baobuibk/SpaceLiin_BEE-DAL_EXP_V1.0_HW/07_REF/position-connectors.docx

TOP VIEW

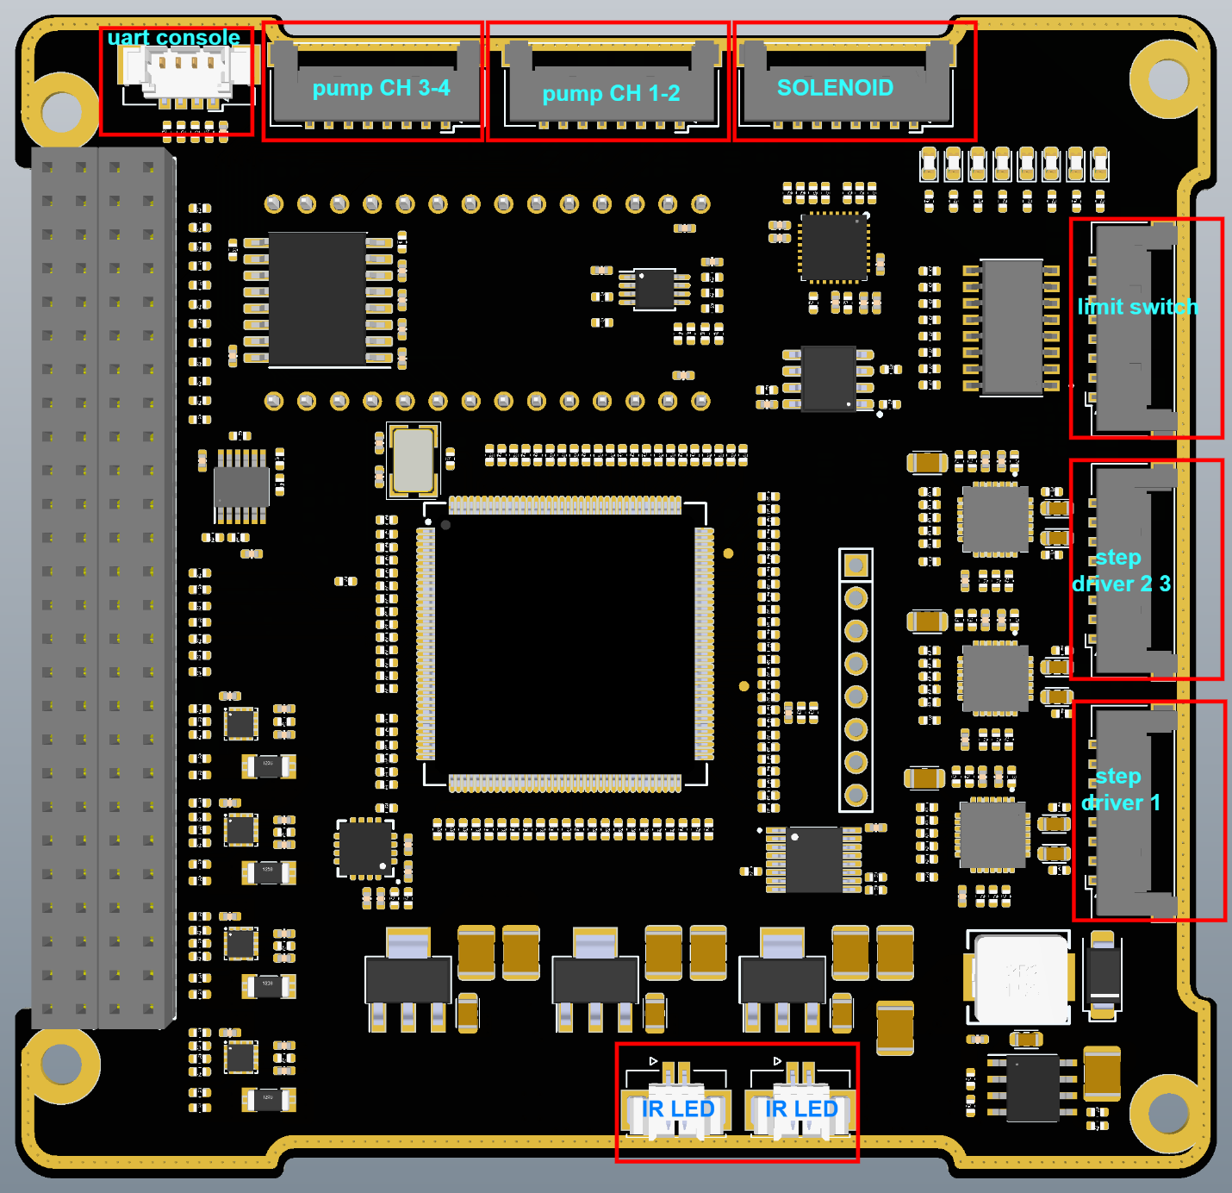
[picture p5: figure]

BOT VIEW

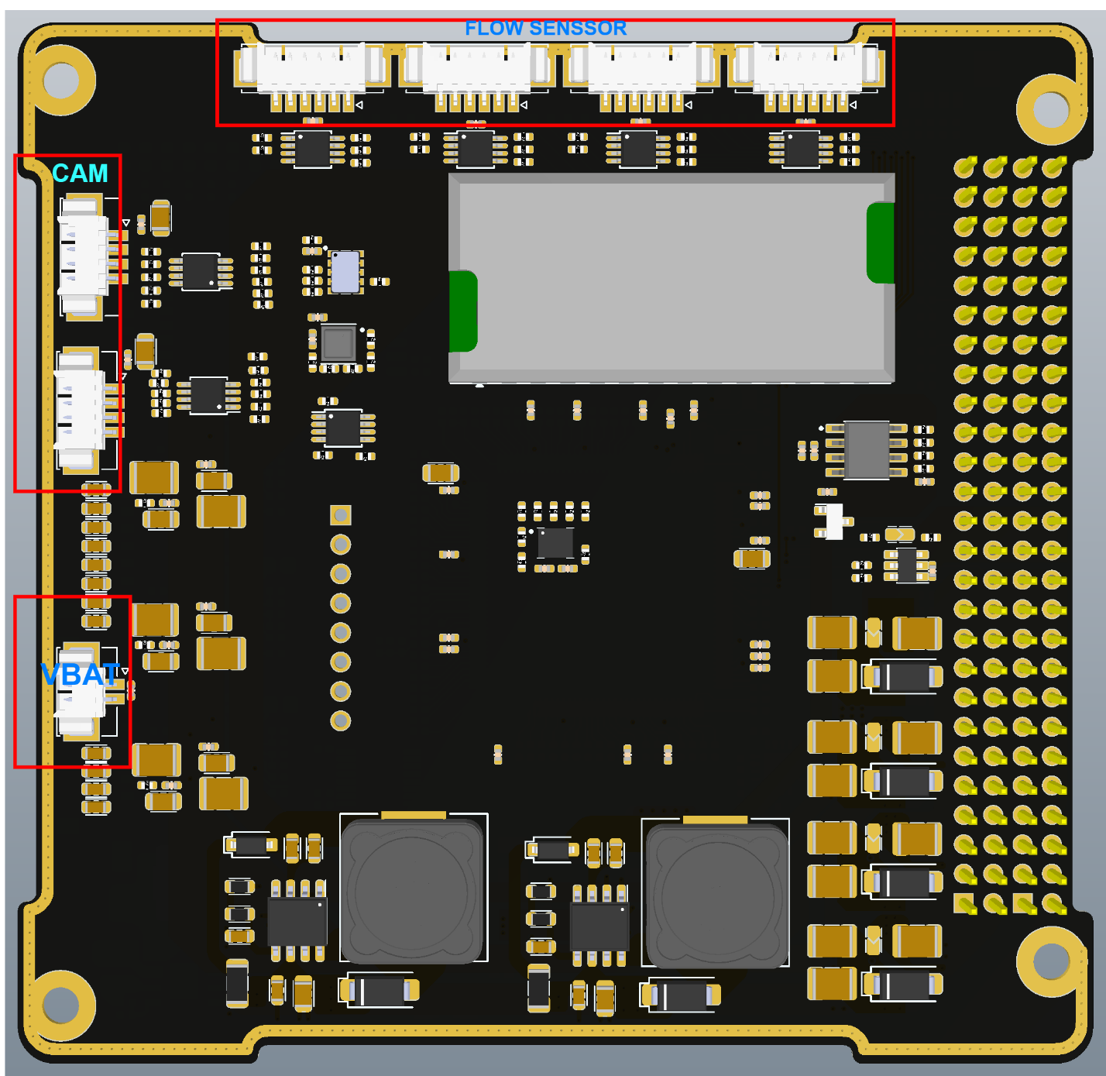
[picture p6: figure]
