baobuibk/SpaceLiin_BEE-DAL_EXP_V1.0_HW/03_BOM/BEE-DAL_EXP_V1.0.xlsx

Name | Description | Designator | Quantity | Library Name | Footprint | Manufacturer 1 | Manufacturer Part Number 1
_LED_YELLOW | LED YELLOW CLEAR 0603 SMD | D3, D10, D11, D12, D13, D14, D15, D16 | 8 | LABLIB.SchLib | LED_0603 | Würth Elektronik Midcom | 150060YS75000
0R | RES 0 OHM JUMPER 1/16W 0402 | R81, R91, R135, R144, R154, R156, R233, R234, R235, R236, R239, R240, R241, R242, R243, R244, R246, R285, R286, R287, R296, R297, R298, R304, R305, R307, R311, R312 | 28 | LABLIB.SchLib | RES_C_1005X40 | Yageo Group | RC0402JR-070RL
0.01uF/50V | CAP CER 10000PF 50V X7R 0603 | C19 | 1 | LABLIB.SchLib | CAP_C_1608X80 | Samsung Electro-Mechanics | CL10B103KB8NNNC
0.05R/1W | RES 0.05 OHM 1% 1W 1206 | R173, R176 | 2 | LABLIB.SchLib | RES_C_3216X70 | Stackpole Electronics | CSNL1206FT50L0
0.1uF/25V | CAP CER 0.1UF 25V X7R 0402 | C13, C14, C17, C18, C23, C29, C30, C31, C32, C33, C34, C35, C36, C37, C38, C39, C40, C41, C42, C43, C44, C45, C46, C47, C48, C49, C50, C51, C52, C53, C54, C55, C56, C57, C58, C59, C60, C61, C63, C64, C111, C112, C134, C137, C139, C141, C142, C143, C144, C164, C165, C166, C167, C168, C171, C172, C173, C174, C176, C177, C178, C179, C407, C408 | 64 | LABLIB.SchLib | CAP_C_1005X60 | Samsung Electro-Mechanics | CL05B104KA5NNNC
0.1uF/25V | CAP CER 0.1UF 25V X7R 0603 | C16, C69, C70, C71, C72, C74, C75, C76, C77, C80, C81, C82, C83, C84, C85, C86, C87, C88, C89, C90, C91, C92, C93 | 23 | LABLIB.SchLib | CAP_C_1608X80 | Samsung Electro-Mechanics | CL10B104KA8NNNC
1k | RES SMD 1K OHM 1% 1/10W 0402 | R5, R13, R256, R257, R258, R263, R271 | 7 | LABLIB.SchLib | RES_C_1005X40 | Panasonic | ERJ2RKF1001X
1k | RES 1K OHM 1% 1/10W 0603 | R174, R177 | 2 | LABLIB.SchLib | RES_C_1608X60 | SEI | RMCF0603FT1K00
1M | RES 1M OHM 1% 1/16W 0402 | R112 | 1 | LABLIB.SchLib | RES_C_1005X40 | Yageo Group | RC0402FR-071ML
1N4007FL | DIODE STANDARD 1000V 1A SOD123FL | D18, D19, D20, D21 | 4 | LABLIB.SchLib | SOD3717X145N | Sangdest Microelectronics | 1N4007FL
1N5819HW-7-F | DIODE SCHOTTKY 40V 1A SOD123 | D5, D7 | 2 | LABLIB.SchLib | SOD3717X145N | Diodes Inc. | 1N5819HW-7-F
1uF/25V | CAP CER 1UF 25V X5R 0402 | C4, C10, C21, C65, C125, C131, C169, C170, C175, C409 | 10 | LABLIB.SchLib | CAP_C_1005X60 | Holystone | C0402B105K025T
1.6k | RES SMD 1.6K OHM 1% 1/10W 0402 | R8, R16, R266, R274 | 4 | LABLIB.SchLib | RES_C_1005X40 | Panasonic | ERJ2RKF1601X
2.2nF/50V | CAP CER 2200PF 50V X7R 0402 | C5, C6, C11, C12, C126, C127, C132, C133 | 8 | LABLIB.SchLib | CAP_C_1005X60 | Samsung Electro-Mechanics | CL05B222KB5NNNC
2.2uF/10V | CAP CER 2.2UF 10V X7S 0402 | C67, C411 | 2 | LABLIB.SchLib | CAP_C_1005X60 | TDK | C1005X7S1A225K050BC
3.24k | RES 3.24K OHM 1% 1/16W 0402 | R35, R322 | 2 | LABLIB.SchLib | RES_C_1005X40 | Vishay | CRCW04023K24FKED
4.7k | RES SMD 4.7K OHM 1% 1/10W 0402 | R108, R114, R115, R116, R117, R118, R119, R120, R121, R126, R127, R128, R129, R131, R132, R136, R137, R138, R139, R140, R145, R146, R147, R148, R149, R157, R158, R159, R160, R283, R284, R294, R295, R327, R328, R329, R330 | 37 | LABLIB.SchLib | RES_C_1005X40 | Panasonic | ERJ-2RKF4701X
4.7nF/50V | CAP CER 4700PF 50V X7R 0603 | C15 | 1 | LABLIB.SchLib | CAP_C_1608X80 | Samsung Electro-Mechanics | CL10B472KB8NNNC
4.7uF/10V | CAP CER 4.7UF 10V X5R 0402 | C62, C109, C110, C406 | 4 | LABLIB.SchLib | CAP_C_1005X60 | Samsung Electro-Mechanics | CL05A475MP5NRNC
5.62k | RES SMD 5.62K OHM 1% 1/10W 0402 | R113 | 1 | LABLIB.SchLib | RES_C_1005X40 | Panasonic | ERJ2RKF5621X
10k | RES SMD 10K OHM 1% 1/10W 0402 | R6, R9, R14, R20, R23, R24, R50, R51, R52, R53, R62, R63, R65, R67, R78, R122, R130, R133, R163, R164, R165, R170, R180, R249, R250, R251, R264, R272, R275, R277, R279, R288, R299, R319, R320, R332, R338, R339, R342, R343, R346, R349, R352, R355, R409, R410, R415 | 47 | LABLIB.SchLib | RES_C_1005X40 | Panasonic | ERJ-2RKF1002X
10k | RES 10K OHM 1% 1/10W 0603 | R175, R178 | 2 | LABLIB.SchLib | RES_C_1608X60 | Yageo Group | RC0603FR-0710KL
10uF/25V | CAP CER 10UF 25V X5R 0805 | C27, C28, C68, C73, C113, C116, C119, C136, C138 | 9 | LABLIB.SchLib | CAP_C_2012X110 | Samsung Electro-Mechanics | CL21A106KAYNNNE
12pF/50V | CAP CER 12PF 50V C0G/NP0 0402 | C24, C25, C26 | 3 | LABLIB.SchLib | CAP_C_1005X60 | Murata | GJM1555C1H120FB01D
16.5k/1% | RES 16.5K OHM 1% 1/16W 0402 | R124, R125 | 2 | LABLIB.SchLib | RES_C_1005X40 | Stackpole Electronics | RMCF0402FT16K5
20k | RES 20K OHM 1% 1/16W 0402 | R172, R417 | 2 | LABLIB.SchLib | RES_C_1005X40 | Yageo Group | RC0402FR-0720KL
22nF/16V | CAP CER 0.022UF 16V X7R 0402 | C66, C410 | 2 | LABLIB.SchLib | CAP_C_1005X60 | Yageo Group | C0402C223K4RACTU
22R | RES SMD 22 OHM 0.5% 1/16W 0402 | R18, R22, R25, R26, R27, R28, R29, R30, R31, R32, R33, R34, R36, R37, R38, R39, R40, R42, R44, R46, R47, R48, R49, R54, R55, R56, R57, R58, R59, R60, R61, R64, R66, R68, R69, R70, R71, R72, R73, R74, R75, R76, R77, R79, R80, R82, R83, R85, R86, R87, R88, R90, R92, R93, R96, R97, R98, R99, R101, R102, R103, R104, R105, R106, R107, R109, R110, R111, R123, R142, R143, R150, R151, R161, R162, R166, R167, R168, R169, R171, R179, R303, R306, R308, R309, R310, R313, R321, R323, R324, R325, R326, R331, R334, R335, R344, R345, R347, R348, R350, R351, R353, R354, R411, R412, R413, R414, R416 | 108 | LABLIB.SchLib | RES_C_1005X40 | Panasonic | ERA-2AKD220X
47k | RES SMD 47K OHM 1% 1/10W 0402 | R3, R4, R7, R11, R12, R15, R261, R262, R269, R270 | 10 | LABLIB.SchLib | RES_C_1005X40 | Panasonic | ERJ2RKF4702X
47uF/25V | CAP CER 47UF 25V X5R 1210 | C1, C2, C3, C7, C8, C9, C20, C22, C78, C79, C114, C115, C117, C118, C120, C121, C122, C123, C124, C128, C129, C130 | 22 | LABLIB.SchLib | CAP_C_3225X80 | TAIYO YUDEN | TMK325ABJ476MMP
47uH | FIXED IND 47UH 2.8A 67 MOHM SMD | L1, L2 | 2 | BEE-DAL_EXP_sche.SCHLIB | IND_MP_1250x1250x850 | EPCOS | B82477P4473M000
60R | RES SMD 60.4 OHM 1% 1/10W 0402 | R17, R19 | 2 | LABLIB.SchLib | RES_C_1005X40 | Panasonic | ERJ2RKF60R4X
100k | RES 100K OHM 1% 1/10W 0402 | R278 | 1 | LABLIB.SchLib | RES_C_1005X40 | Panasonic | ERJ-2RKF1003X
120R | RES SMD 120 OHM 0.1% 1/16W 0402 | R276, R336, R337, R340, R341 | 5 | LABLIB.SchLib | RES_C_1005X40 | Panasonic | ERA2AEB121X
133k | RES SMD 133K OHM 1% 1/10W 0402 | R265, R273 | 2 | LABLIB.SchLib | RES_C_1005X40 | Panasonic | ERJ-2RKF1333X
470k | RES SMD 470K OHM 1% 1/10W 0402 | R2, R10, R260, R268 | 4 | LABLIB.SchLib | RES_C_1005X40 | Panasonic | ERJ2RKF4703X
0532610271 | CONN HEADER SMD R/A 2POS 1.25MM | J3, J11, J12 | 3 | LABLIB.SchLib | MOLEX_0532610271 | Molex | 53261-0271
0532610471 | CONN HEADER SMD R/A 4POS 1.25MM | J15, J17 | 2 | BEE-DAL_EXP_sche.SCHLIB | MOLEX_0532610471 | Molex | 53261-0471
0532610671 | CONN HEADER SMD R/A 6POS 1.25MM | J4, J5 | 2 | LABLIB.SchLib | MOLEX_0532610671 | Molex | 53261-0671
0533980471 | CONN HEADER SMD 4POS 1.25MM | J1 | 1 | LABLIB.SchLib | MOLEX_0533980471 | Molex | 53398-0471
5040500491 | CONN HEADER SMD R/A 4POS 1.5MM | J6 | 1 | LABLIB.SchLib | MOLEX_5040500491 | Molex | 504050-0491
5040500591 | CONN HEADER SMD R/A 5POS 1.5MM | J13, J14 | 2 | LABLIB.SchLib | MOLEX_5040500591 | Molex | 504050-0591
5040500891 | CONN HEADER SMD R/A 8POS 1.5MM | J7, J8, J9, J10, J16, J18, J19, J20 | 8 | LABLIB.SchLib | MOLEX_5040500891 | Molex | 504050-0891
AL8843SP-13 | IC LED DRIVER RGLTR PWM 3A 8SO | U18, U19 | 2 | BEE-DAL_EXP_sche.SCHLIB | SOIC127P602X173-8N_EPAD | Diodes Inc. | AL8843SP-13
AO3400A | MOSFET N-CH 30V 5.7A SOT23-3L | Q1, Q2, Q3, Q4 | 4 | LABLIB.SchLib | SOT95P240X120-3N | Alpha & Omega Semiconductor | AO3400A
BME688 | SENSOR GAS/HUM/PRES/TEMP I2C SPI | U13 | 1 | LABLIB.SchLib | IC_BME688 | Bosch Tools | BME688
DNP/0R |  | JP5 | 1 | LABLIB.SchLib | JUMPER_1-2_1608X60
DNP/0R | RES 0 OHM JUMPER 1/10W 0603 | JP6, JP7 | 2 | LABLIB.SchLib | RES_C_1608X60 | Yageo Group | RC0603JR-070RL
DNP/0R | RES 0 OHM JUMPER 1/16W 0402 | R289, R302, R315, R316, R317, R318 | 6 | LABLIB.SchLib | RES_C_1005X40 | Yageo Group | RC0402JR-070RL
DNP/4.7k | RES SMD 4.7K OHM 1% 1/10W 0402 | R84, R134, R141, R152, R153, R155, R237, R238, R247, R248, R281, R282, R292, R293 | 14 | LABLIB.SchLib | RES_C_1005X40 | Panasonic | ERJ-2RKF4701X
DNP/10k | RES SMD 10K OHM 1% 1/10W 0402 | R1, R259, R267 | 3 | LABLIB.SchLib | RES_C_1005X40 | Panasonic | ERJ-2RKF1002X
DNP/22R | RES SMD 22 OHM 0.5% 1/16W 0402 | R94 | 1 | LABLIB.SchLib | RES_C_1005X40 | Panasonic | ERA-2AKD220X
ESQ-126-14-G-D | CONN SOCKET 52POS 0.1 GOLD PCB | H1, H2 | 2 | BEE-DAL_EXP_sche.SCHLIB | SAMTEC_ESQ-126-14-G-D | Samtec | ESQ-126-14-G-D
FC5BQCCMC12.0-T1 | CRYSTAL 12.0000MHZ 20PF SMD | XC1 | 1 | BEE-DAL_EXP_sche.SCHLIB | AP7-00039 | Abracon | FC5BQCCMC12.0-T1
Header 8x1 |  | J2 | 1 | LABLIB.SchLib | Header_254P_8x1
hole_space |  | Hole1, Hole2, Hole3, Hole4 | 4 | BEE-DAL_EXP_sche.SCHLIB | HEX-M3_NoVia
IC_DRV8910QPWPRQ1 | IC HALF BRIDGE DRVR 6A 24HTSSOP | U20 | 1 | LABLIB.SchLib | IC_DRV8910QPWPRQ1 | Texas Instruments | DRV8910QPWPRQ1
IS66WVS8M8FBLL-104NLI | IC PSRAM 64M SPI/QUAD I/O 8-SOIC | U28 | 1 | LABLIB.SchLib | SOIC8_150MIL_N_ISI | ISSI | IS66WVS8M8FBLL-104NLI
JUMPER |  | JP1, JP2, JP3, JP4, JP10, JP11 | 6 | BEE-DAL_EXP_sche.SCHLIB | JUMPER_1608
KRL1632E-M-R010-F-T5 | RES 0.01 OHM 1% 3/4W 1206 | R252, R253, R254, R255 | 4 | LABLIB.SchLib | RES_C_1206_SHUNT | Susumu | KRL1632E-M-R010-F-T5
LM1117MP-3.3/NOPB | IC REG LINEAR 3.3V 800MA SOT-223 | VR1, VR2, VR3 | 3 | LABLIB.SchLib | VREG_LM1117MP-3.3/NOPB | Texas Instruments | LM1117MP-3.3/NOPB
LSM6DSOXTR | INEMO INERTIAL MODULE: 3D ACCELE | U14 | 1 | LABLIB.SchLib | PQFN50P250X300X86-14N | STMicroelectronics | LSM6DSOXTR
MAX3485CSA+T | IC TRANSCEIVER HALF 1/1 8SOIC | U34 | 1 | BEE-DAL_EXP_sche.SCHLIB | 21-0041-3-M_90-0096-8L_MXM | Analog Devices | MAX3485CSA+T
MAX22200ETJ+T | EIGHT HALF-BRIDGES SERIAL CONTRO | U17, U35 | 2 | LABLIB.SchLib | 21-0140AK_T3255_8C_MXM | Analog Devices | MAX22200ETJ+T
MB85RS2MTAPNF-G-BDERE1 | IC FRAM 2MBIT SPI 40MHZ 8SOP | U6 | 1 | BEE-DAL_EXP_sche.SCHLIB | SOIC127P602X173-8N | Fujitsu | MB85RS2MTAPNF-G-BDERE1
mp-HighDriver |  | U11 | 1 | LABLIB.SchLib | MP_HIGHDRIVER
mp-HighDriver4 |  | U15 | 1 | BEE-DAL_EXP_sche.SCHLIB | MP_HIGHDRIVER4
OPA2340UA | IC CMOS 2 CIRCUIT 8SOIC | U36, U37 | 2 | BEE-DAL_EXP_sche.SCHLIB | SOIC127P602X173-8N | Texas Instruments | OPA2340UA
PAC1934 UQFN-16 | IC CURRENT MONITOR 1% 16UQFN | U25 | 1 | LABLIB.SchLib | UQFN-16_4X4_EP2.6X2.6 | Microchip | PAC1934TI/JQ
PCA9508DP,118 | IC REDRIVER I2C HOTSWAP 8TSSOP | U9, U10, U12, U16, U29, U30, U32 | 7 | BEE-DAL_EXP_sche.SCHLIB | TSOP8 | NXP Semiconductors | PCA9508DP,118
RV-3129-C3-32.768KHZ-OPTION-A-TB-QA | IC RTC CLK/CALENDAR I2C 10SON | U7 | 1 | BEE-DAL_EXP_sche.SCHLIB | IC_RV-3129-C3_32.768KHZ_OPTION_A_TB_QA | Micro Crystal | RV-3129-C3-32.768KHZ-OPTION-A-TB-QA
SAMV71Q21B | IC MCU 32BIT 2MB FLASH 144LQFP | U5 | 1 | BEE-DAL_EXP_sche.SCHLIB | AP6-00118 | Microchip | ATSAMV71Q21B-AABT
SN65C3232PWR | 2/2 Transceiver Full RS232 16-TSSOP 1GHz | U4 | 1 | LABLIB.SchLib | SOP65P640X120-16N | Texas Instruments | SN65C3232PWR
SN65HVD230DR | IC TRANSCEIVER HALF 1/1 8SOIC | U3 | 1 | BEE-1012 PAY-EXP_V110.IntLib | SOIC127P600X175-8N | Texas Instruments | SN65HVD230DR
SRP7050TA-220M | FIXED IND 22UH 2.5A 170 MOHM SMD | L3 | 1 | LABLIB.SchLib | PSM6050 | Bourns | SRP7050TA-220M
SS54 | DIODE SCHOTTKY 40V 5A SMA | D1, D2, D4, D6, D8, D9, D17 | 7 | LABLIB.SchLib | DO-214AC_SMA | Multicomp | SS54
TC1047AVNBTR | SENSOR ANALOG -40C-125C SOT23-3 | U31 | 1 | LABLIB.SchLib | SOT95P240X120-3N | Microchip | TC1047AVNBTR
TPL5010QDDCTQ1 | IC OSC PROG TIMER SOT-23-6 | U8 | 1 | BEE-DAL_EXP_sche.SCHLIB | SOT95P280X145-6N | Texas Instruments | TPL5010QDDCTQ1
TPS5430DDAR | IC REG BUCK ADJ 3A 8SOPWR | U33 | 1 | BEE-DAL_EXP_sche.SCHLIB | TPS54531DDAR | Texas Instruments | TPS5430DDAR
TPS259470ARPWR | IC ELECTRONIC FUSE 10VQFN | U1, U2, U26, U27 | 4 | BEE-DAL_EXP_sche.SCHLIB | VQFN-HR-10 | Texas Instruments | TPS259470ARPWR
 | TOTAL COMPONENTS |  | 546
