baobuibk/SpaceLiin_BEE-DAL_EXP_V1.0_HW/02_Schematic_pdf/BEE-DAL_EXP_V1.0.pdf

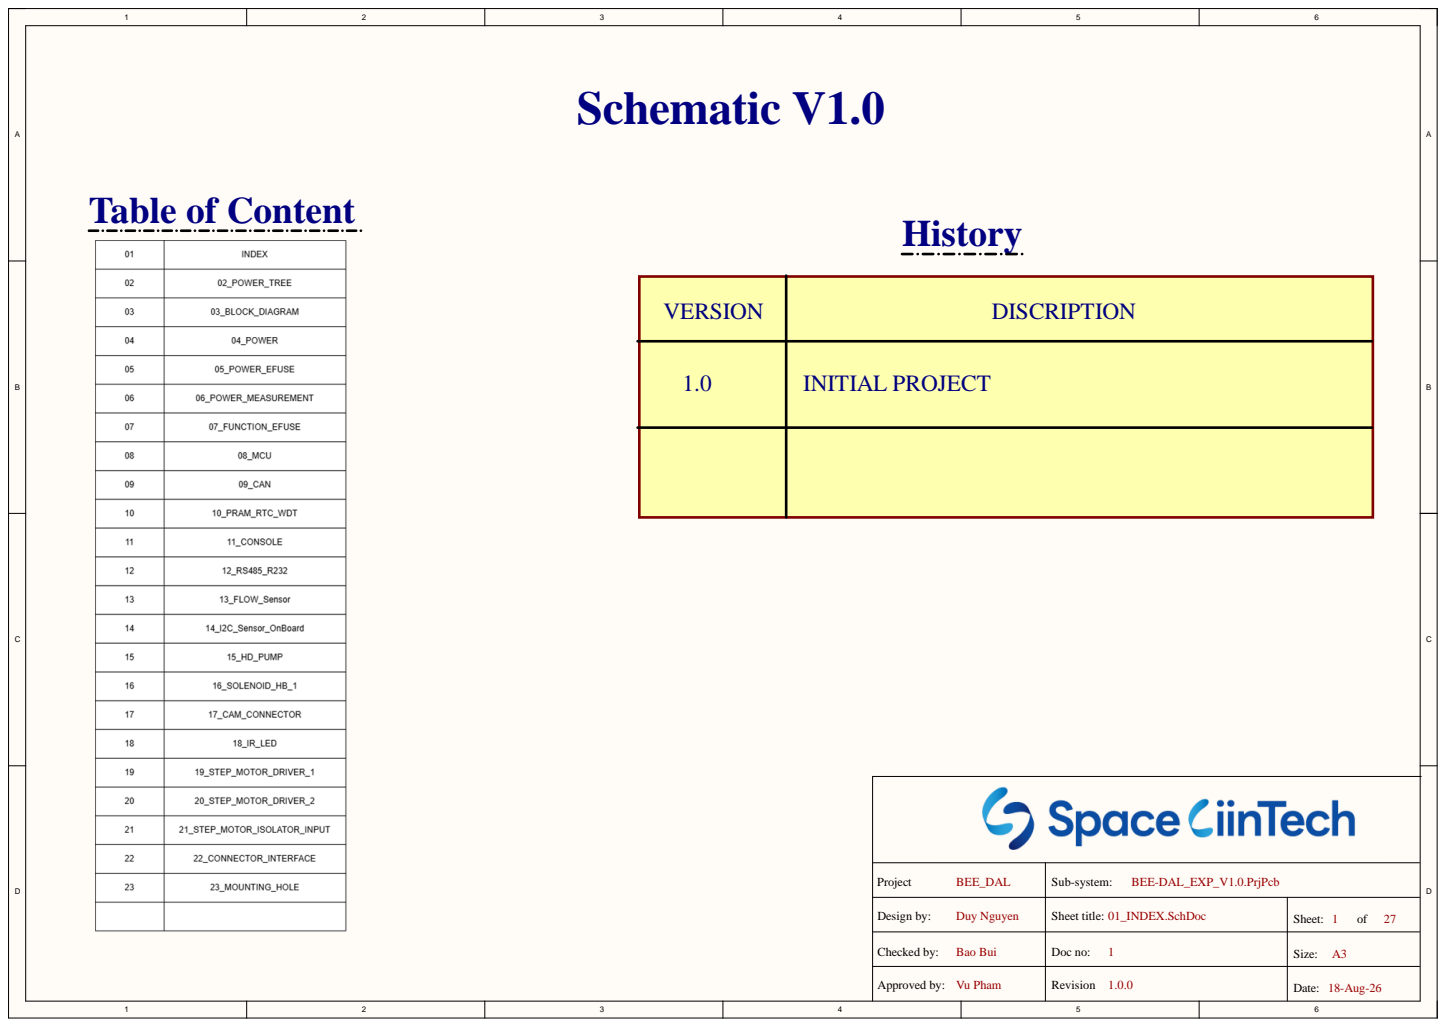
[picture p7: page 1]

VERSION | DISCRIPTION

1.0 | INITIAL PROJECT

Project BEE_DAL | Sub-system: BEE-DAL_EXP_V1.0.PrjPcb

Design by: Duy Nguyen | Sheet title: 01_INDEX.SchDoc | Sheet: 1 of 27

Checked by: Bao Bui | Doc no: 1 | Size: A3

Approved by: Vu Pham | Revision 1.0.0 | Date: 18-Aug-26

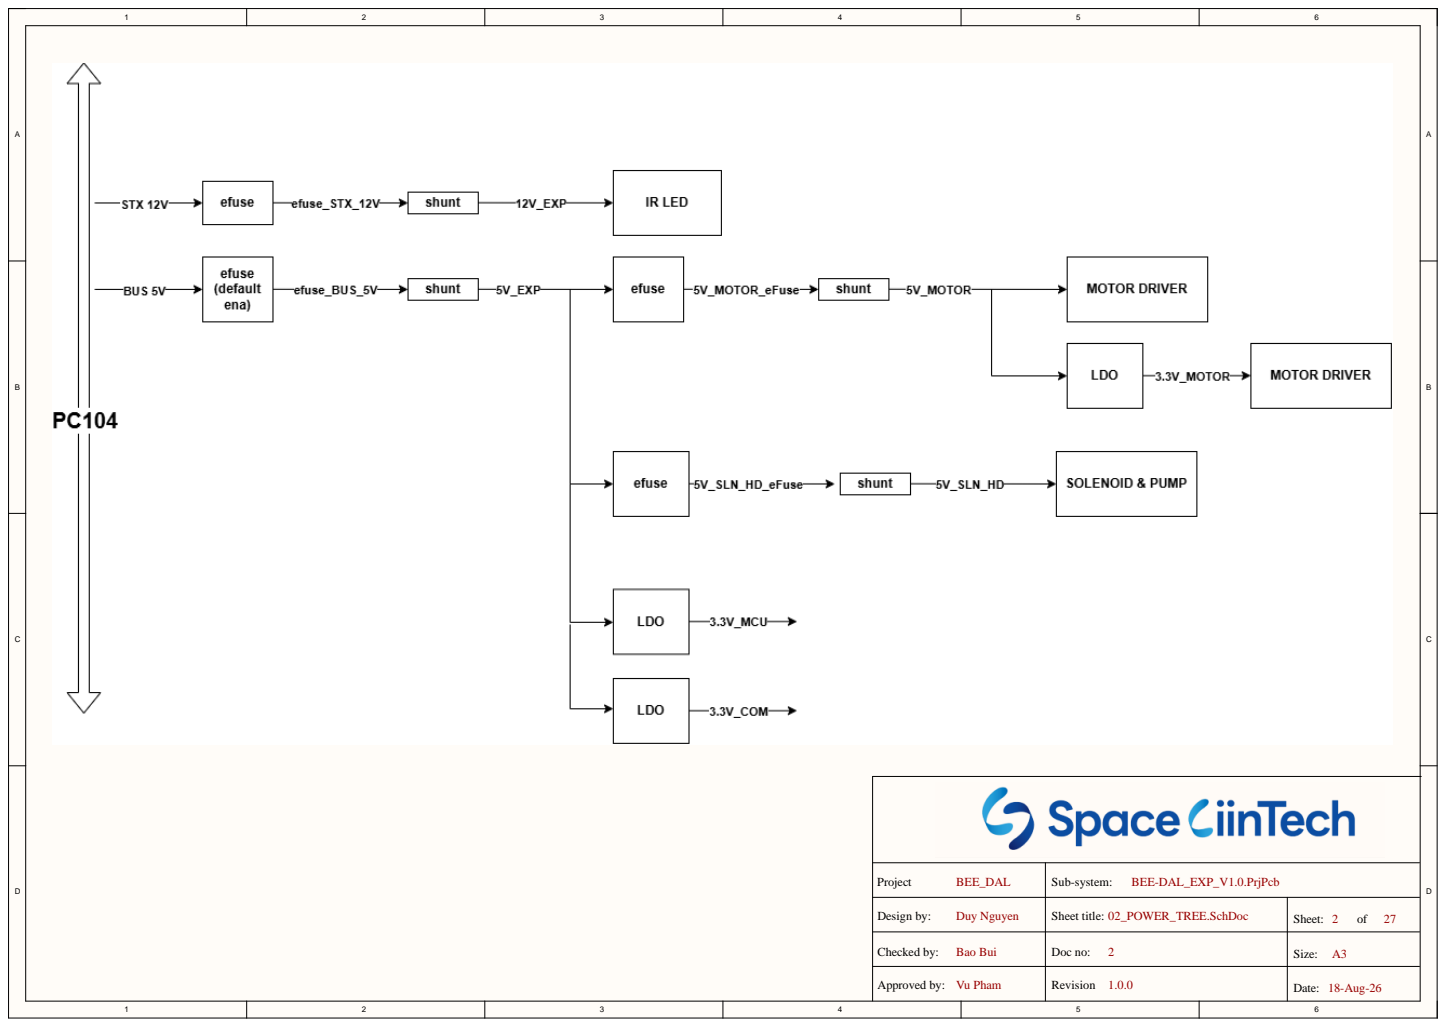
[picture p8: page 2]

Project BEE_DAL | Sub-system: BEE-DAL_EXP_V1.0.PrjPcb

Design by: Duy Nguyen | Sheet title: 02_POWER_TREE.SchDoc | Sheet: 2 of 27

Checked by: Bao Bui | Doc no: 2 | Size: A3

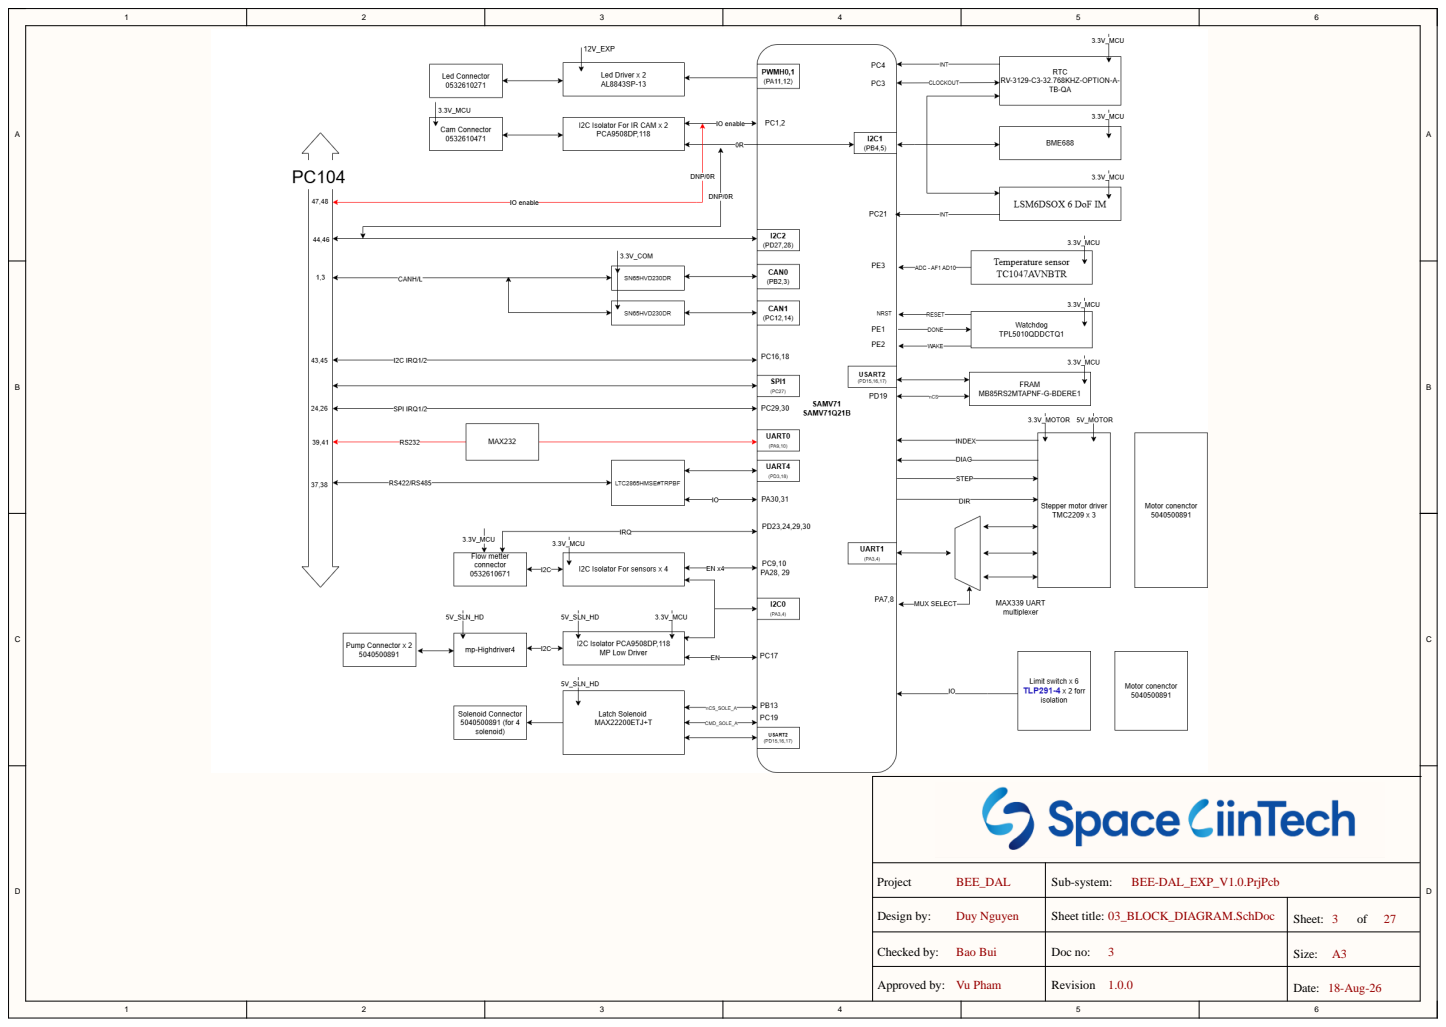
[picture p9: page 3]

Project BEE_DAL | Sub-system: BEE-DAL_EXP_V1.0.PrjPcb

Design by: Duy Nguyen | Sheet title: 03_BLOCK_DIAGRAM.SchDoc | Sheet: 3 of 27

Checked by: Bao Bui | Doc no: 3 | Size: A3

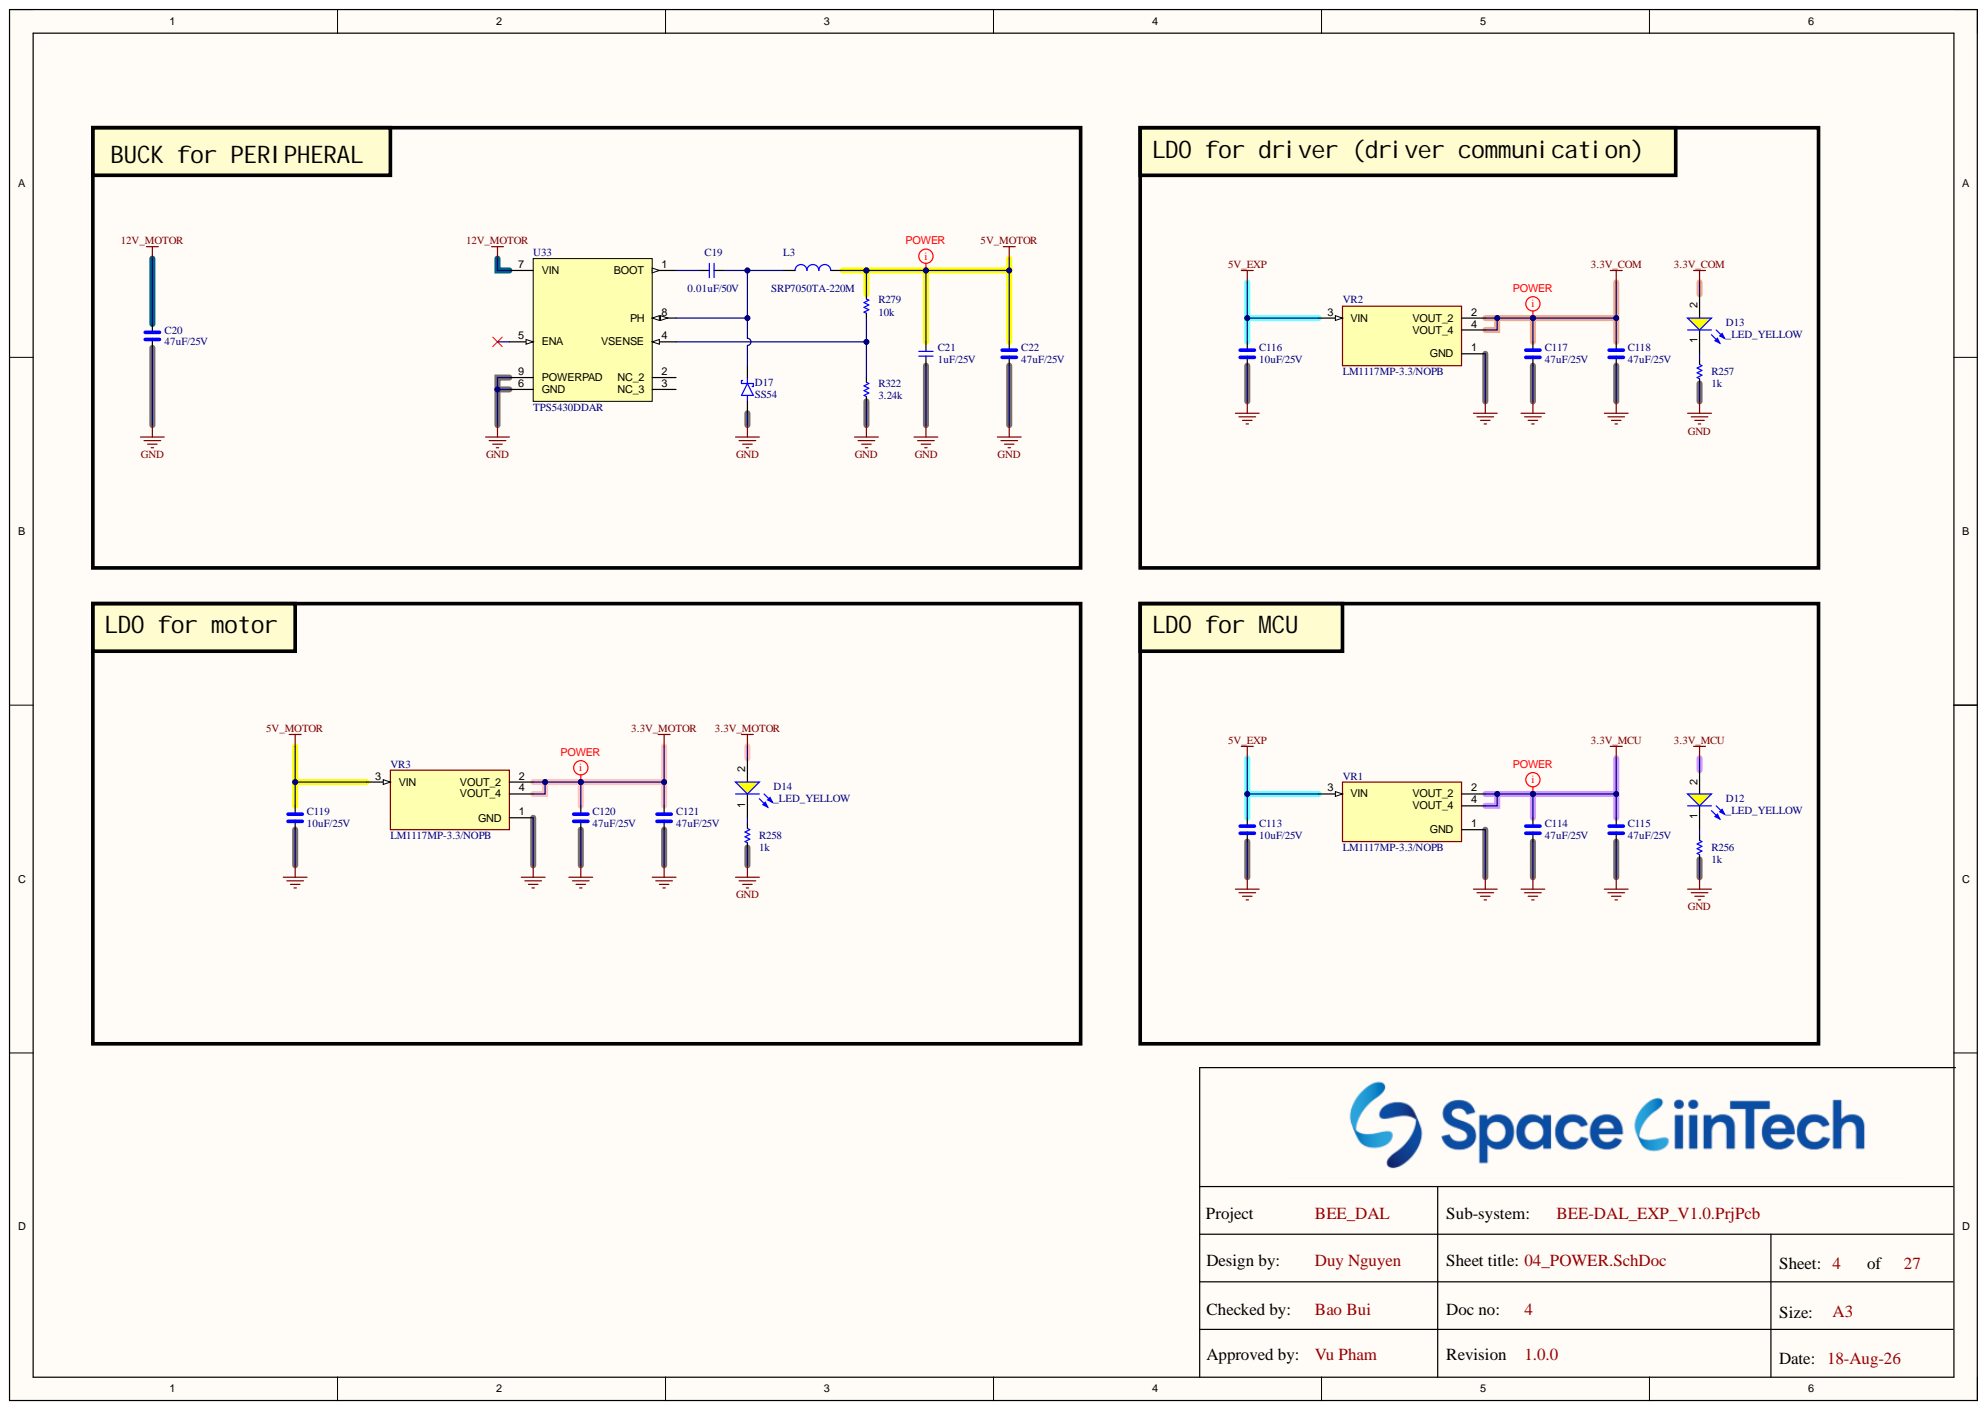
[picture p10: page 4]

LDO for driver (driver communication)

Design by: Project BEE_DAL | Sub-system: BEE-DAL_EXP_V1.0.P rjP c b

Che cked by: B ao Bui | Doc no: Revision Sheet title 4 | 18-Aug-26 4 of 27 Siz e : A3

Duy Nguye n | : 04_POWER.S chDoc | She et:

Vu Pha m | | Date :

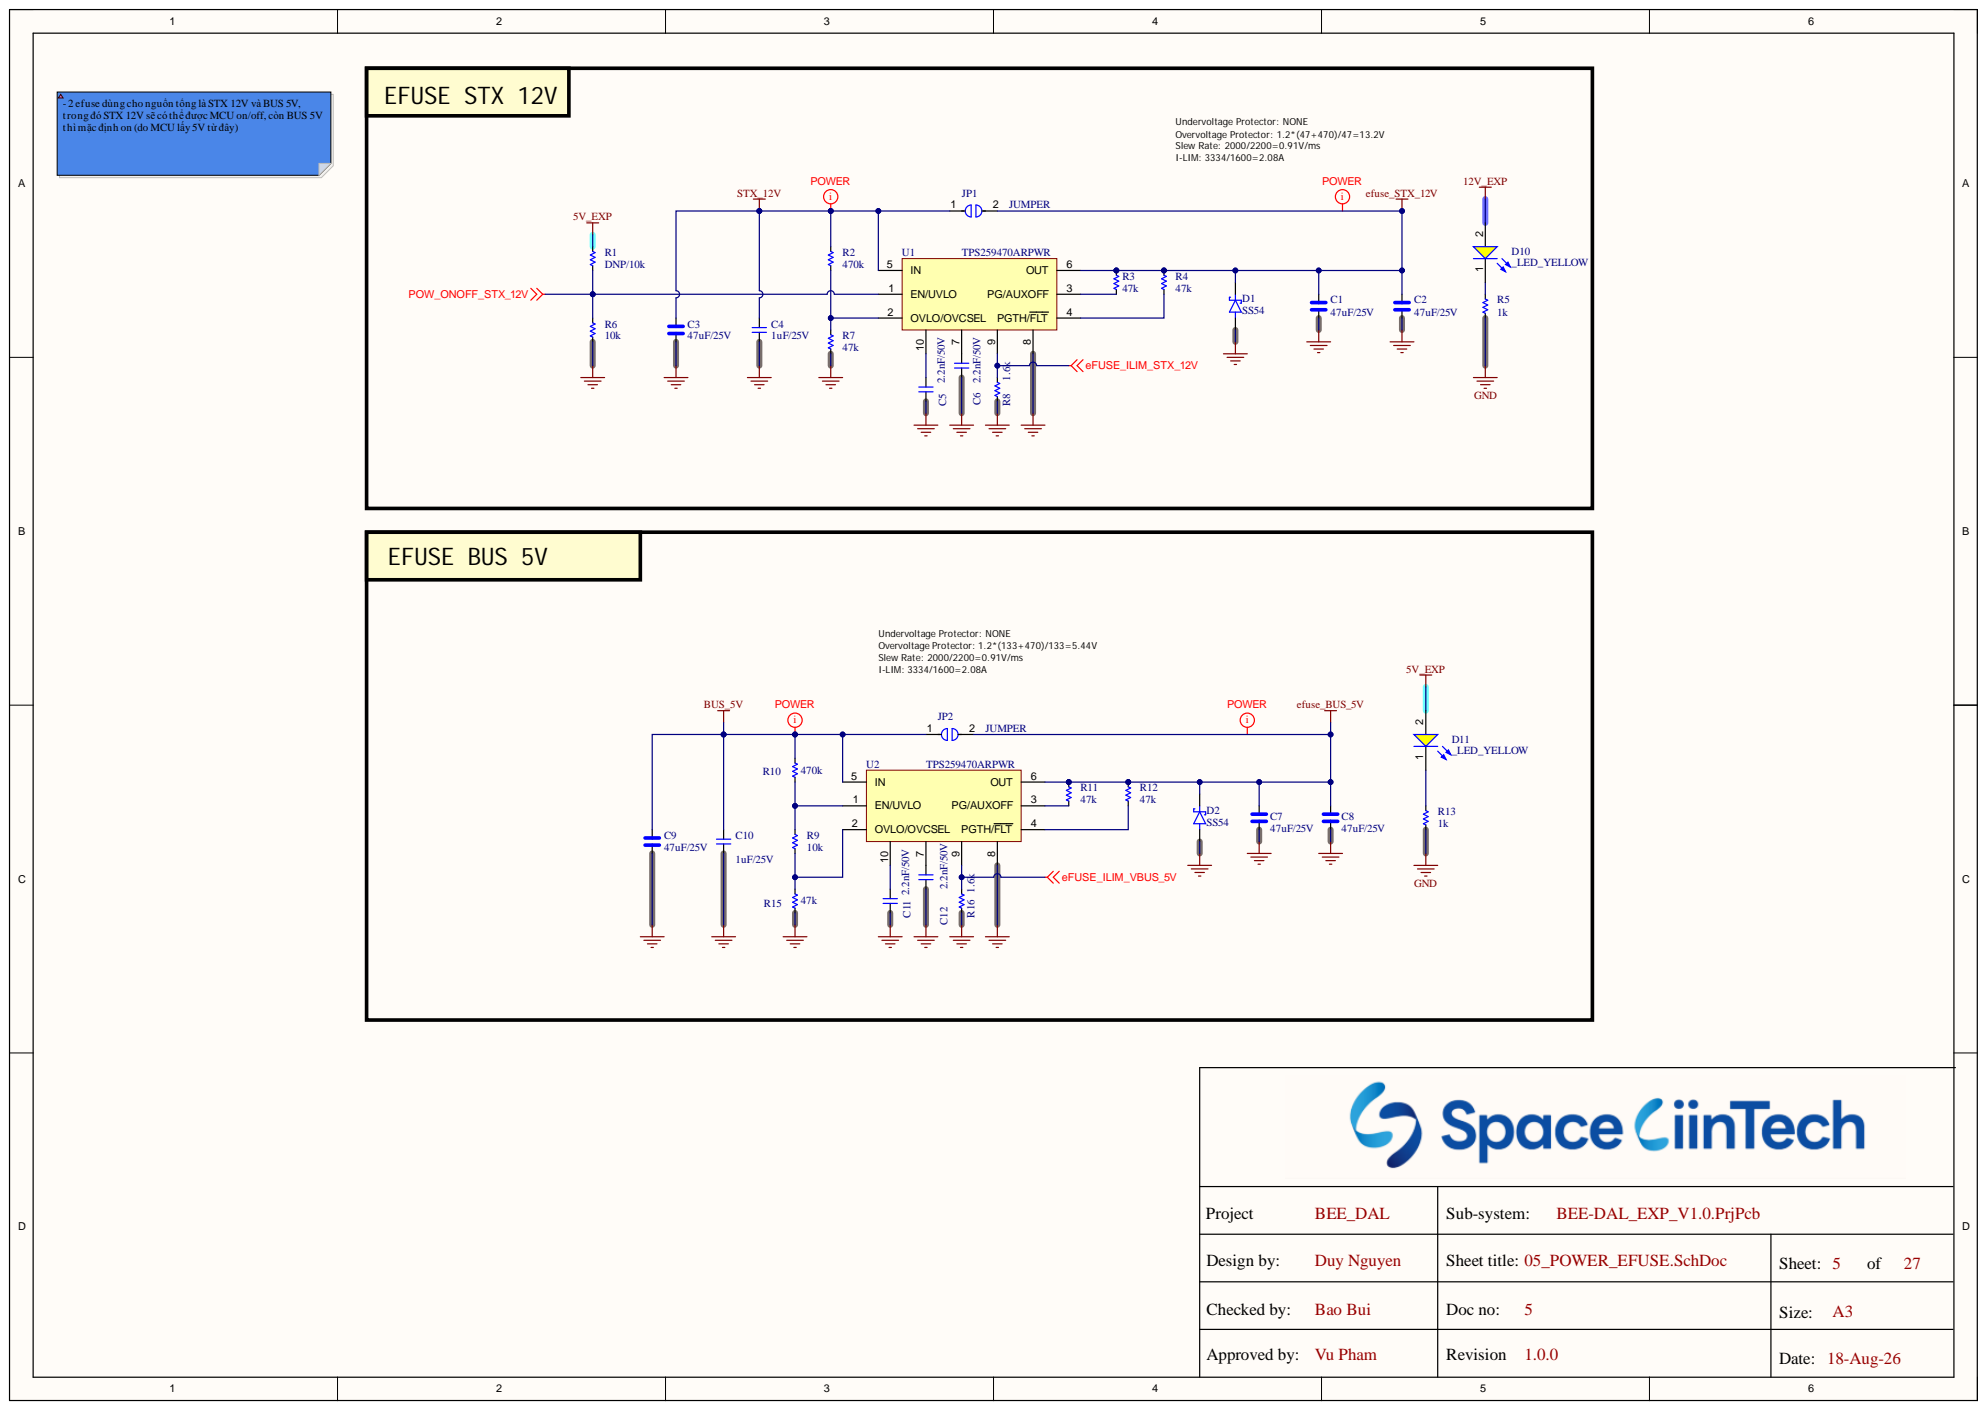
[picture p11: page 5]

- 2 efuse dùng cho nguồn tổng là STX 12V và BUS 5V,
trong đó STX 12V sẽ có thể được MCU on/off, còn BUS 5V
thì mặc định on (do MCU lấy 5V từ đây)

EN/UVLO 1 | R3

OVLO/OVCSEL 2

Project BEE_DAL | Sub-system: BEE-DAL_EXP_V1.0.PrjPcb

Design by: Duy Nguyen | Sheet title: 05_POWER_EFUSE.SchDoc | Sheet: 5 of 27

Checked by: Bao Bui | Doc no: 5 | Size: A3

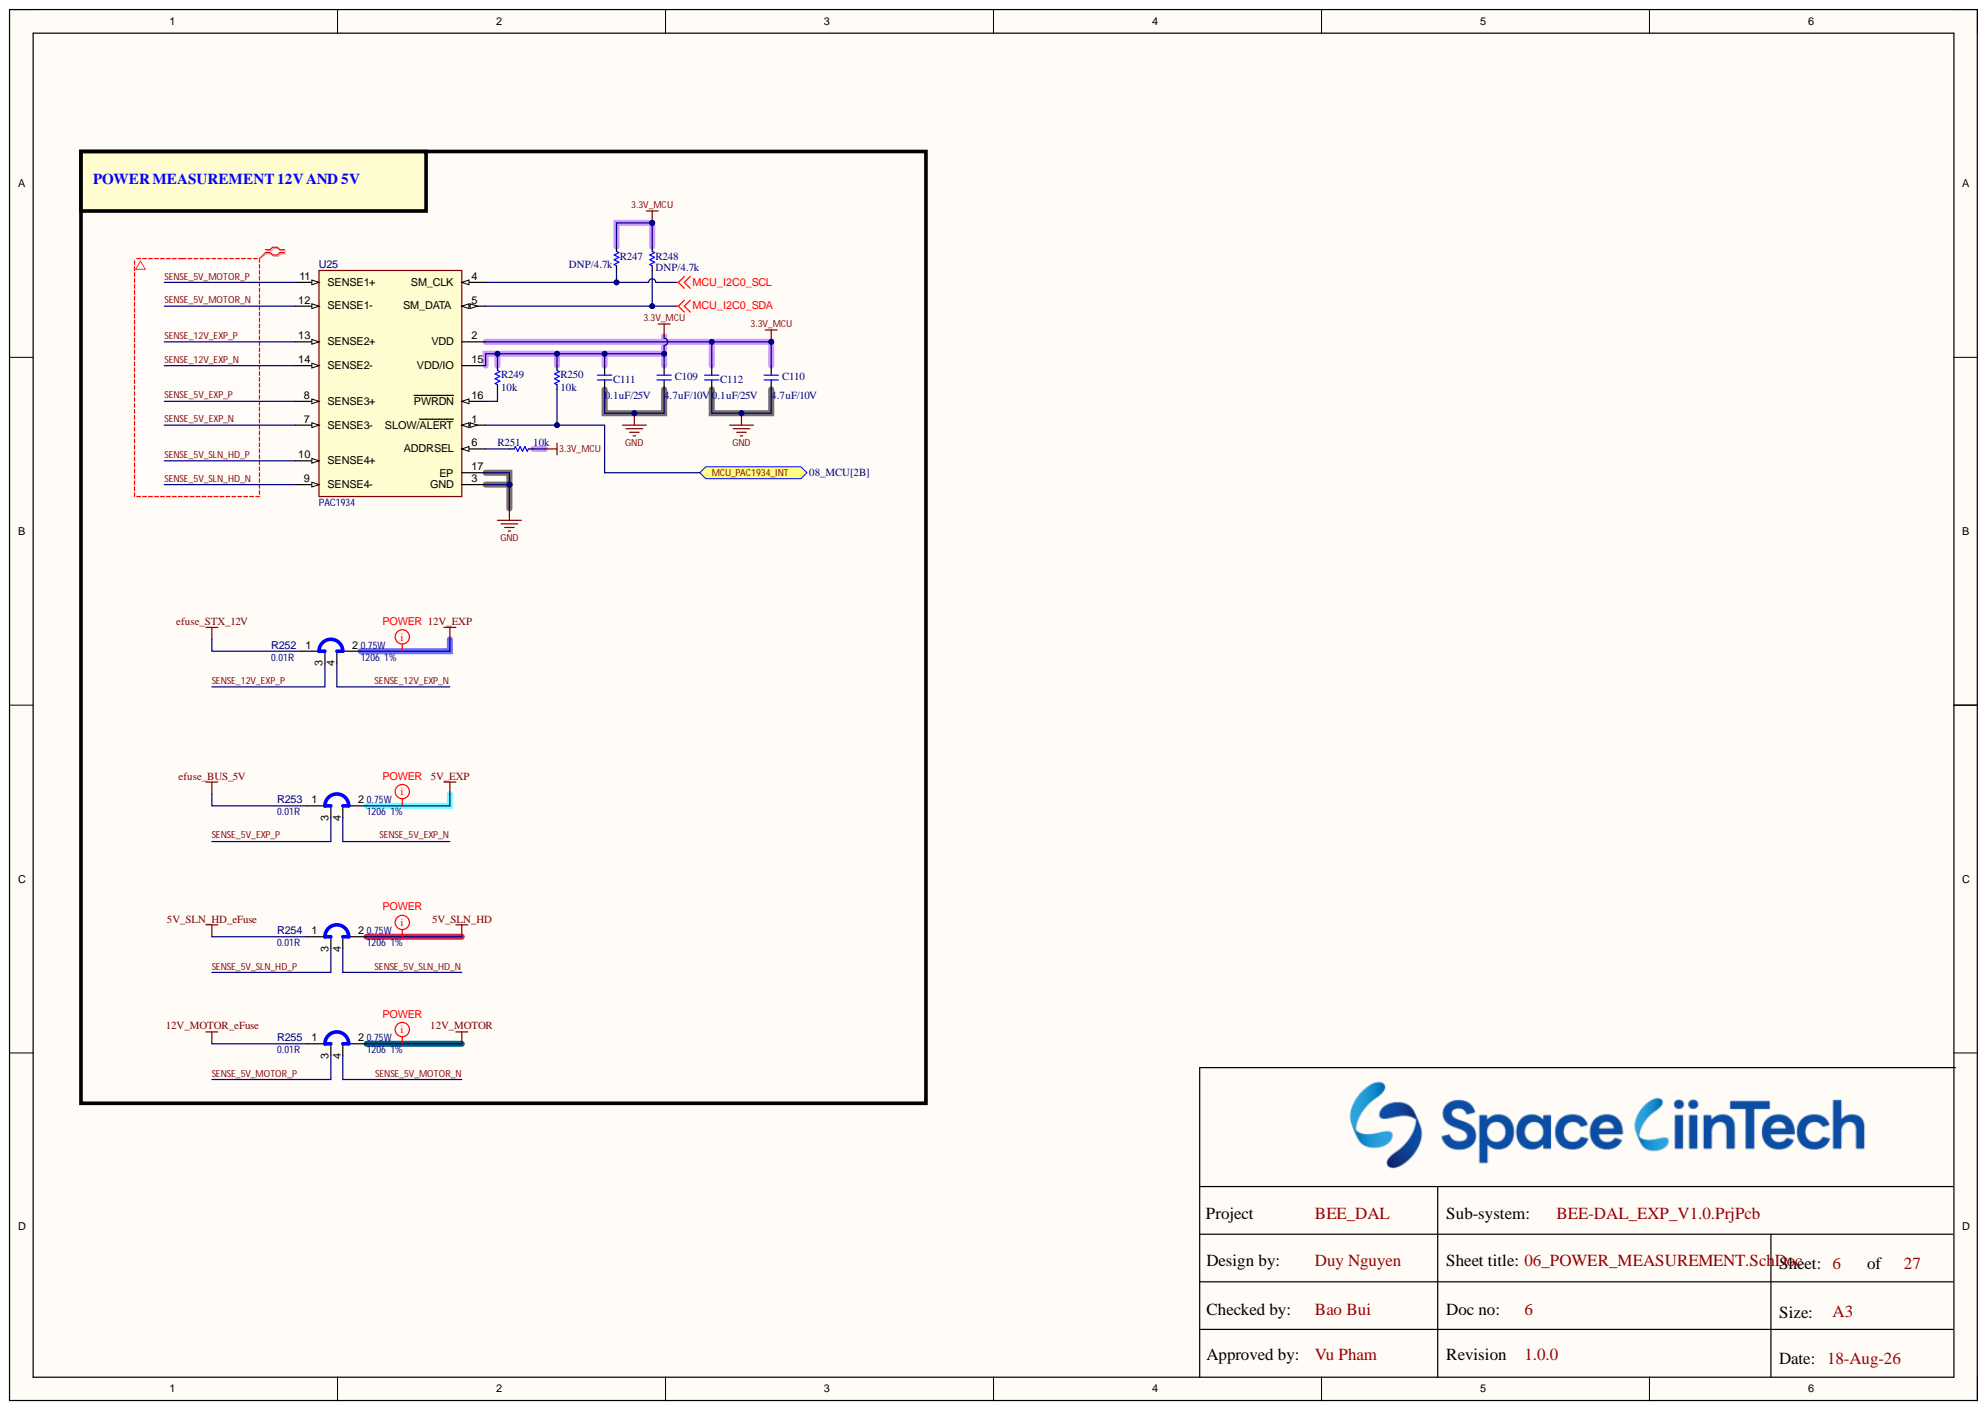
[picture p12: page 6]

Project BEE_DAL | Sub-system: BEE-DAL_EXP_V1.0.PrjPcb

Design by: Duy Nguyen | Sheet title: 06_POWER_MEASUREMENT.SchDoc | Sheet: 6 of 27

Checked by: Bao Bui | Doc no: 6 | Size: A3

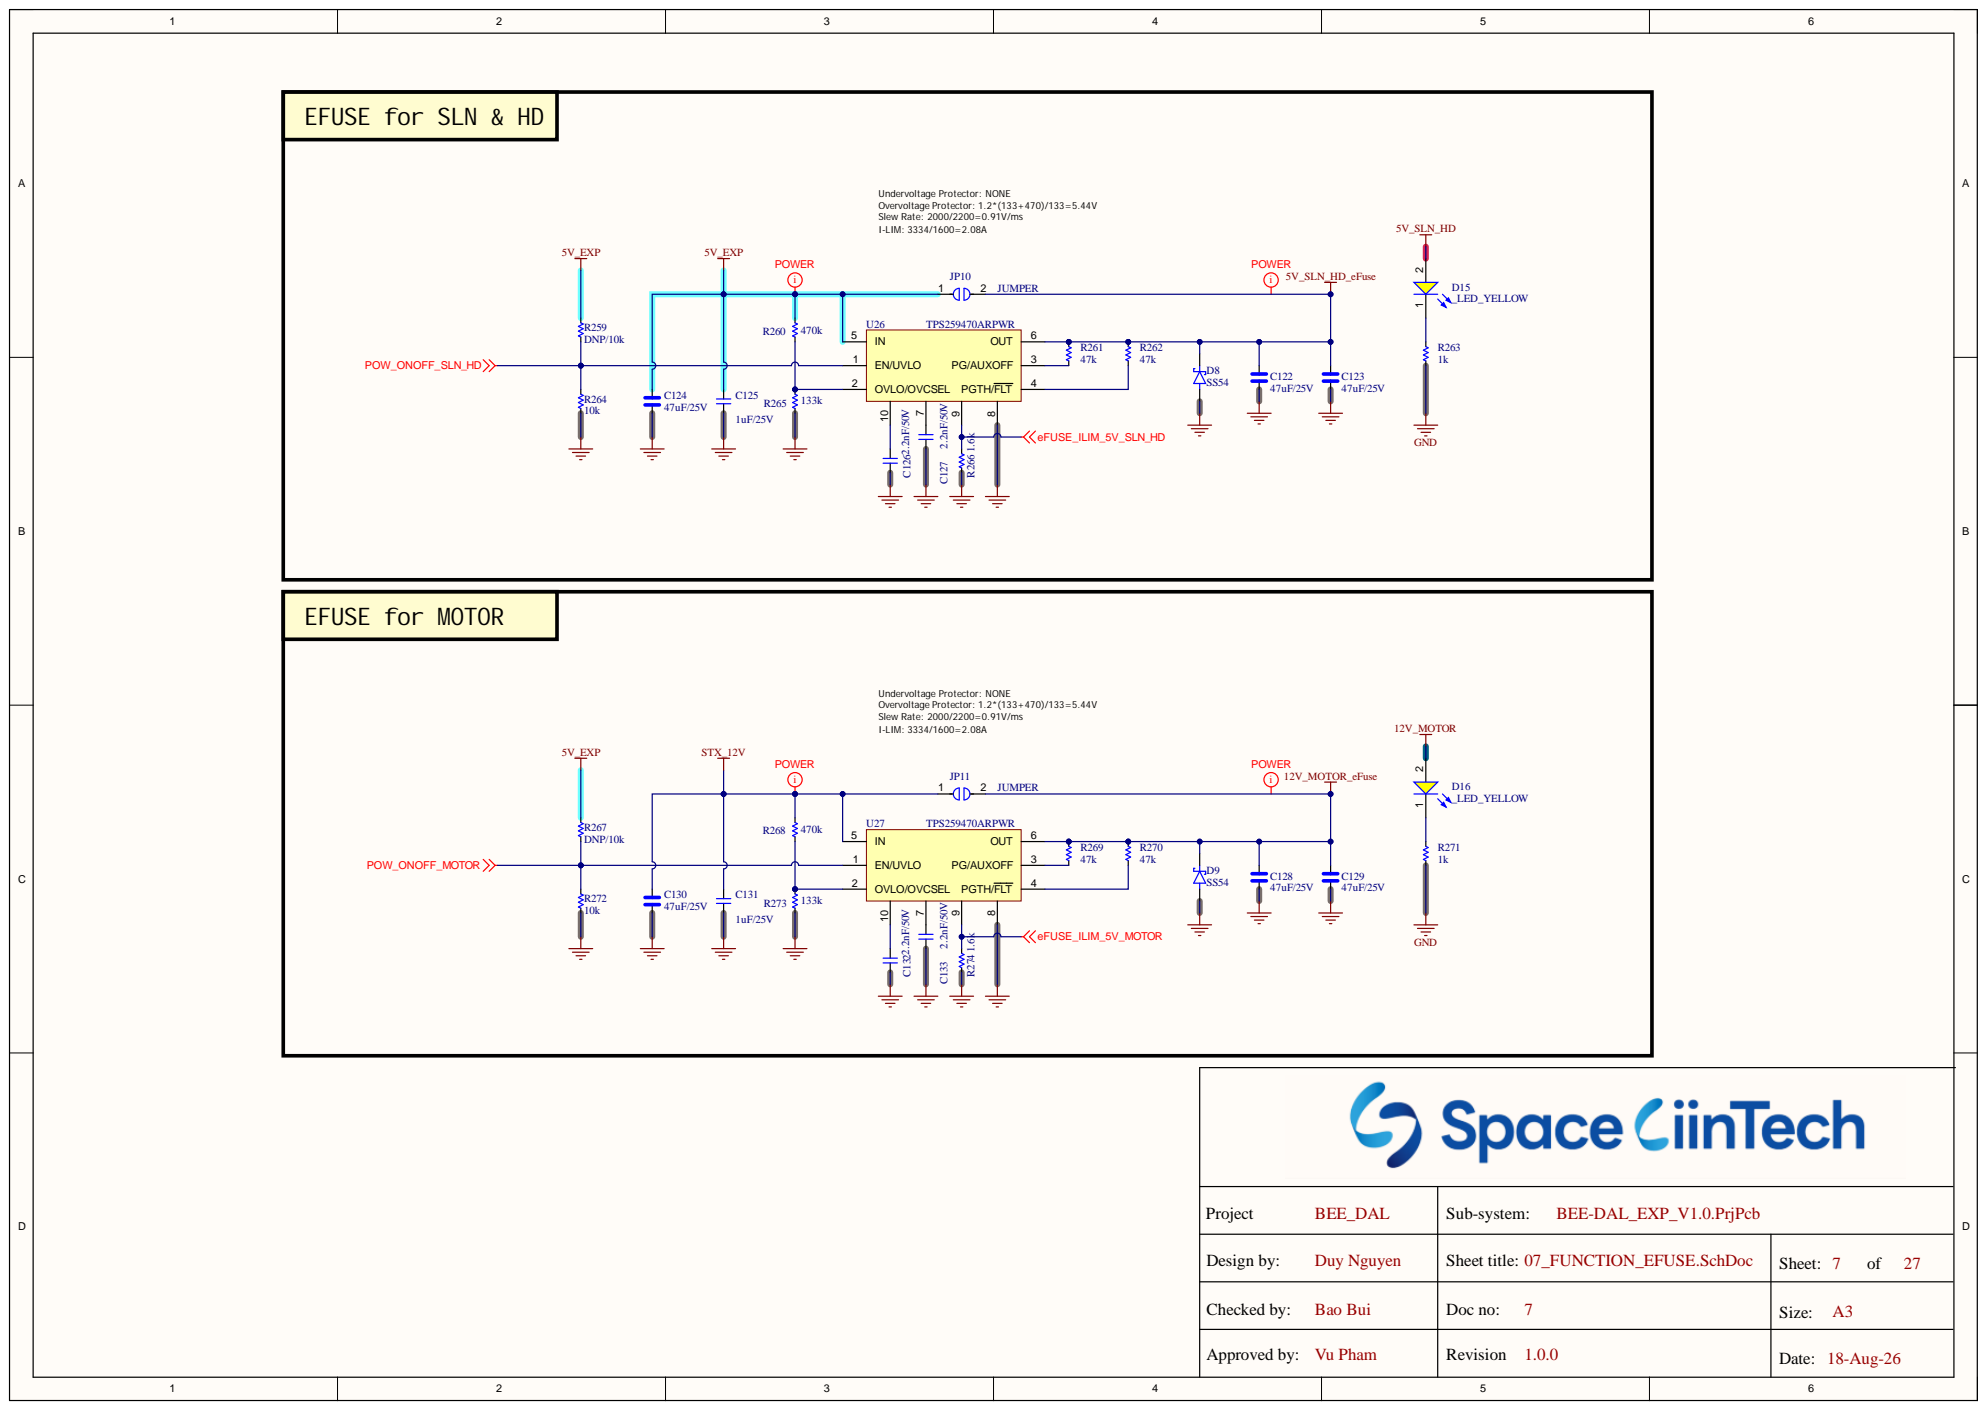
[picture p13: page 7]

EFUSE for SLN & HD

IN | PG/AUXO E L PGTH/F | T

2 | OVLO/OVC S LT | 4

Design by: Project BEE_DAL | Sub-system: BEE-DAL_EXP_V1.0.P rjP c b

Che cked by: B ao Bui | Doc no: Revision Sheet title 7 | 18-Aug-26 7 of 27 Siz e : A3

Duy Nguye n | : 07_FUNCTION_EFUSE.S chDoc | She et:

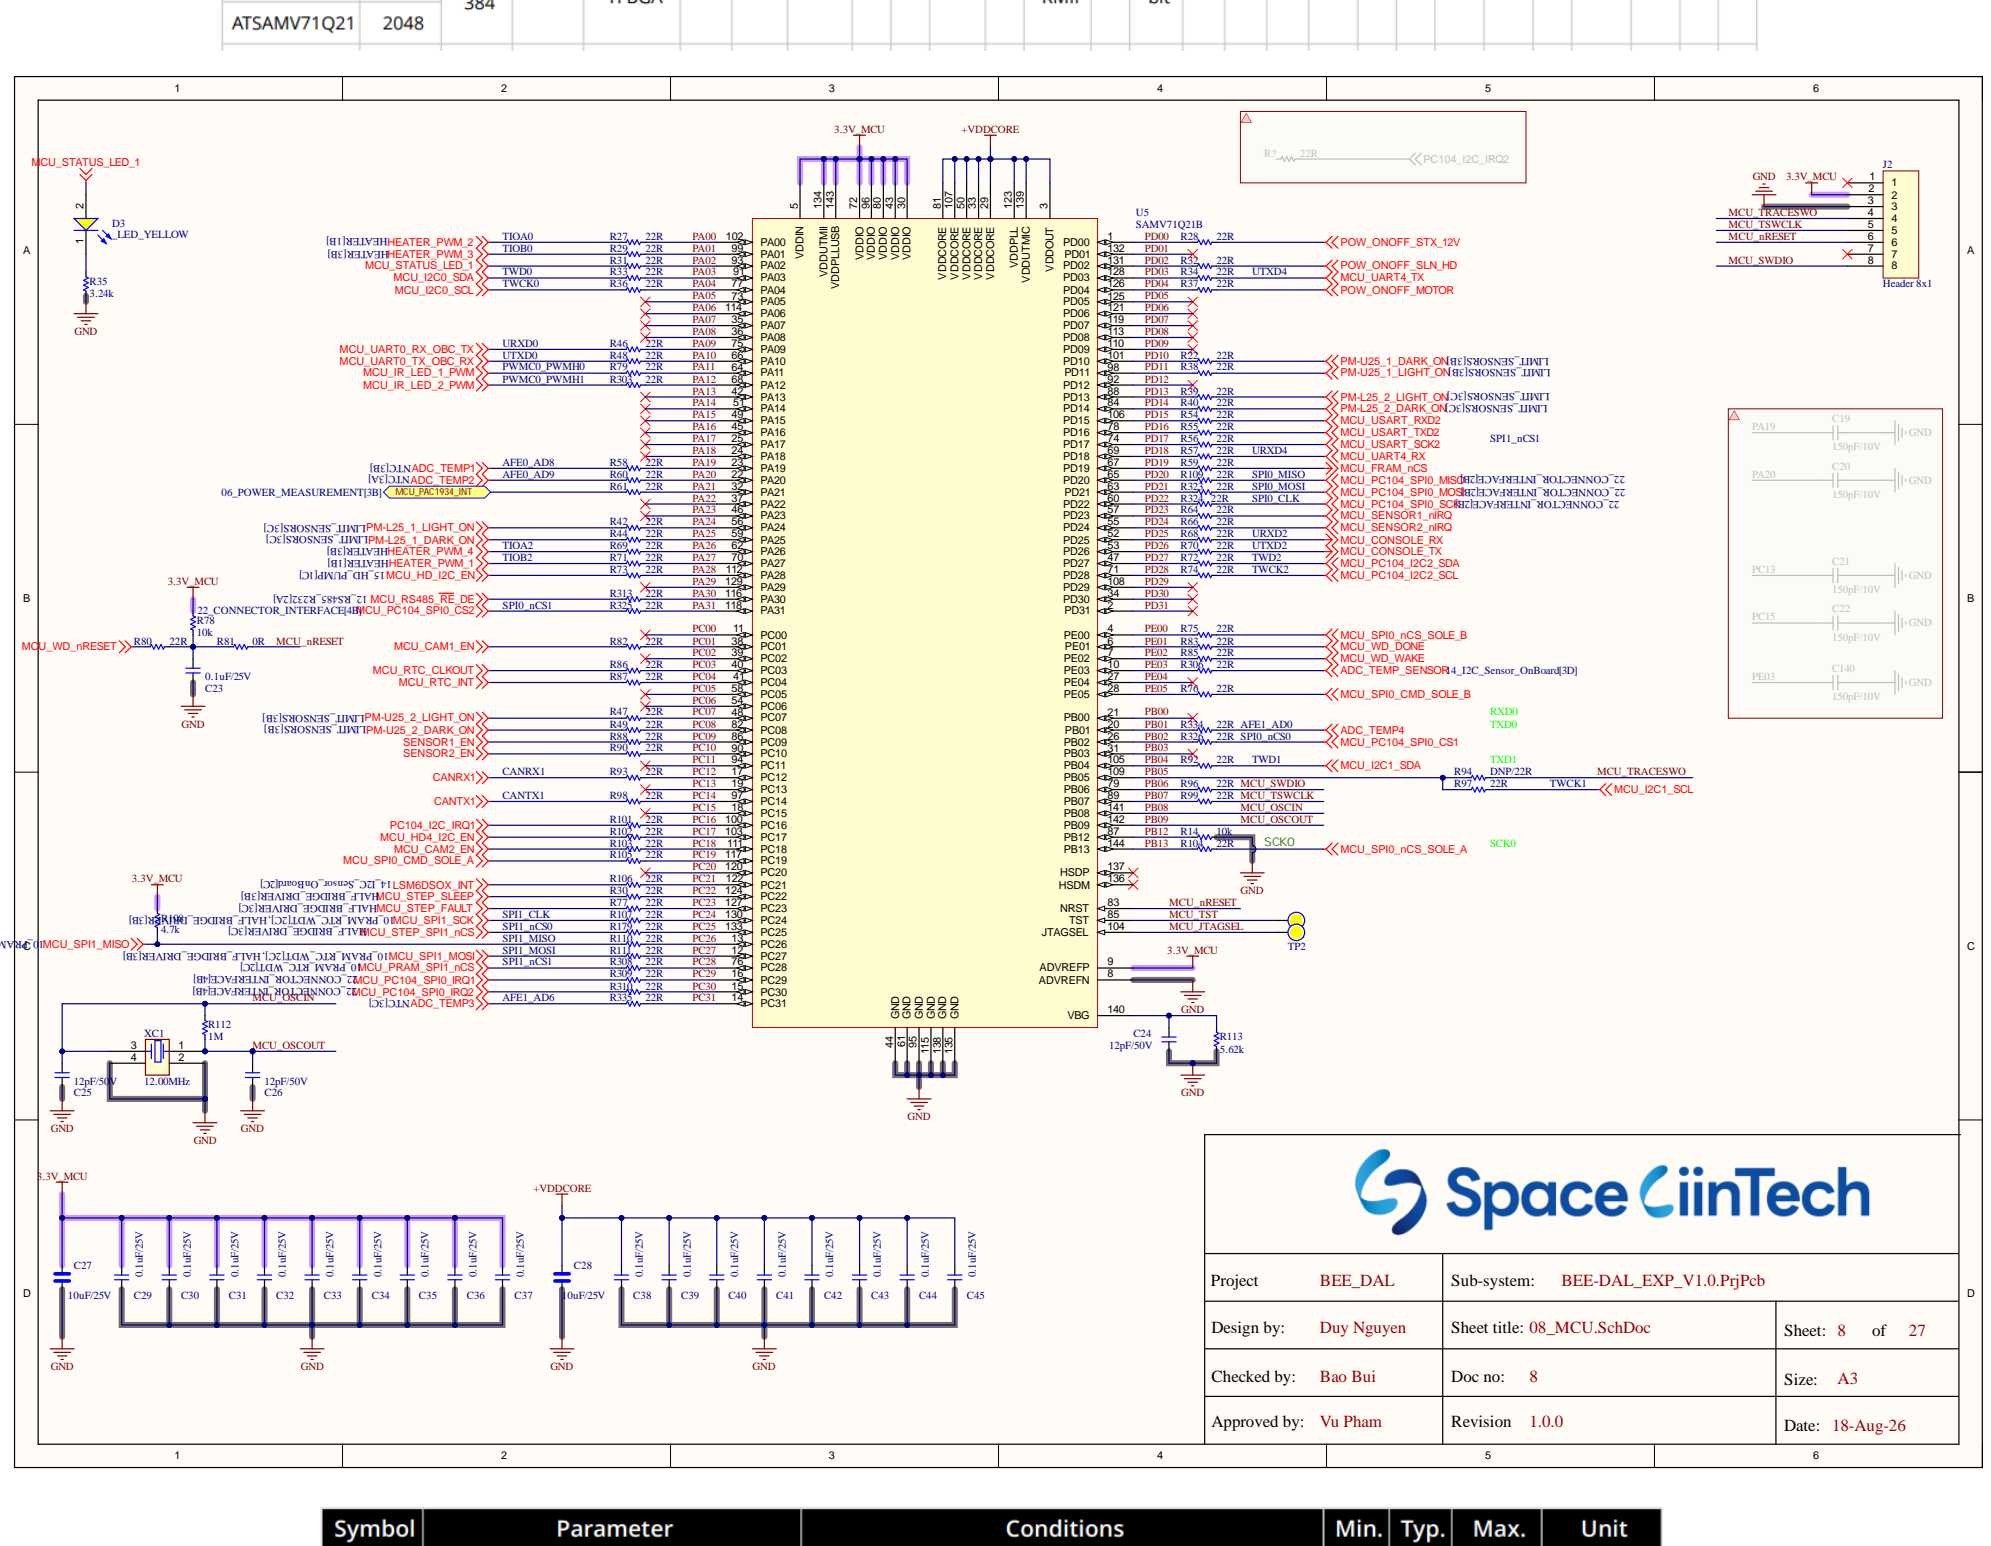
[picture p14: page 8]

Design by: Project BEE_DAL | Sub-system: BEE-DAL_EXP_V1.0.P rjP c b

Duy Nguye n | : 08_MCU.S chDoc | She et:

Doc no: Revision Sheet title

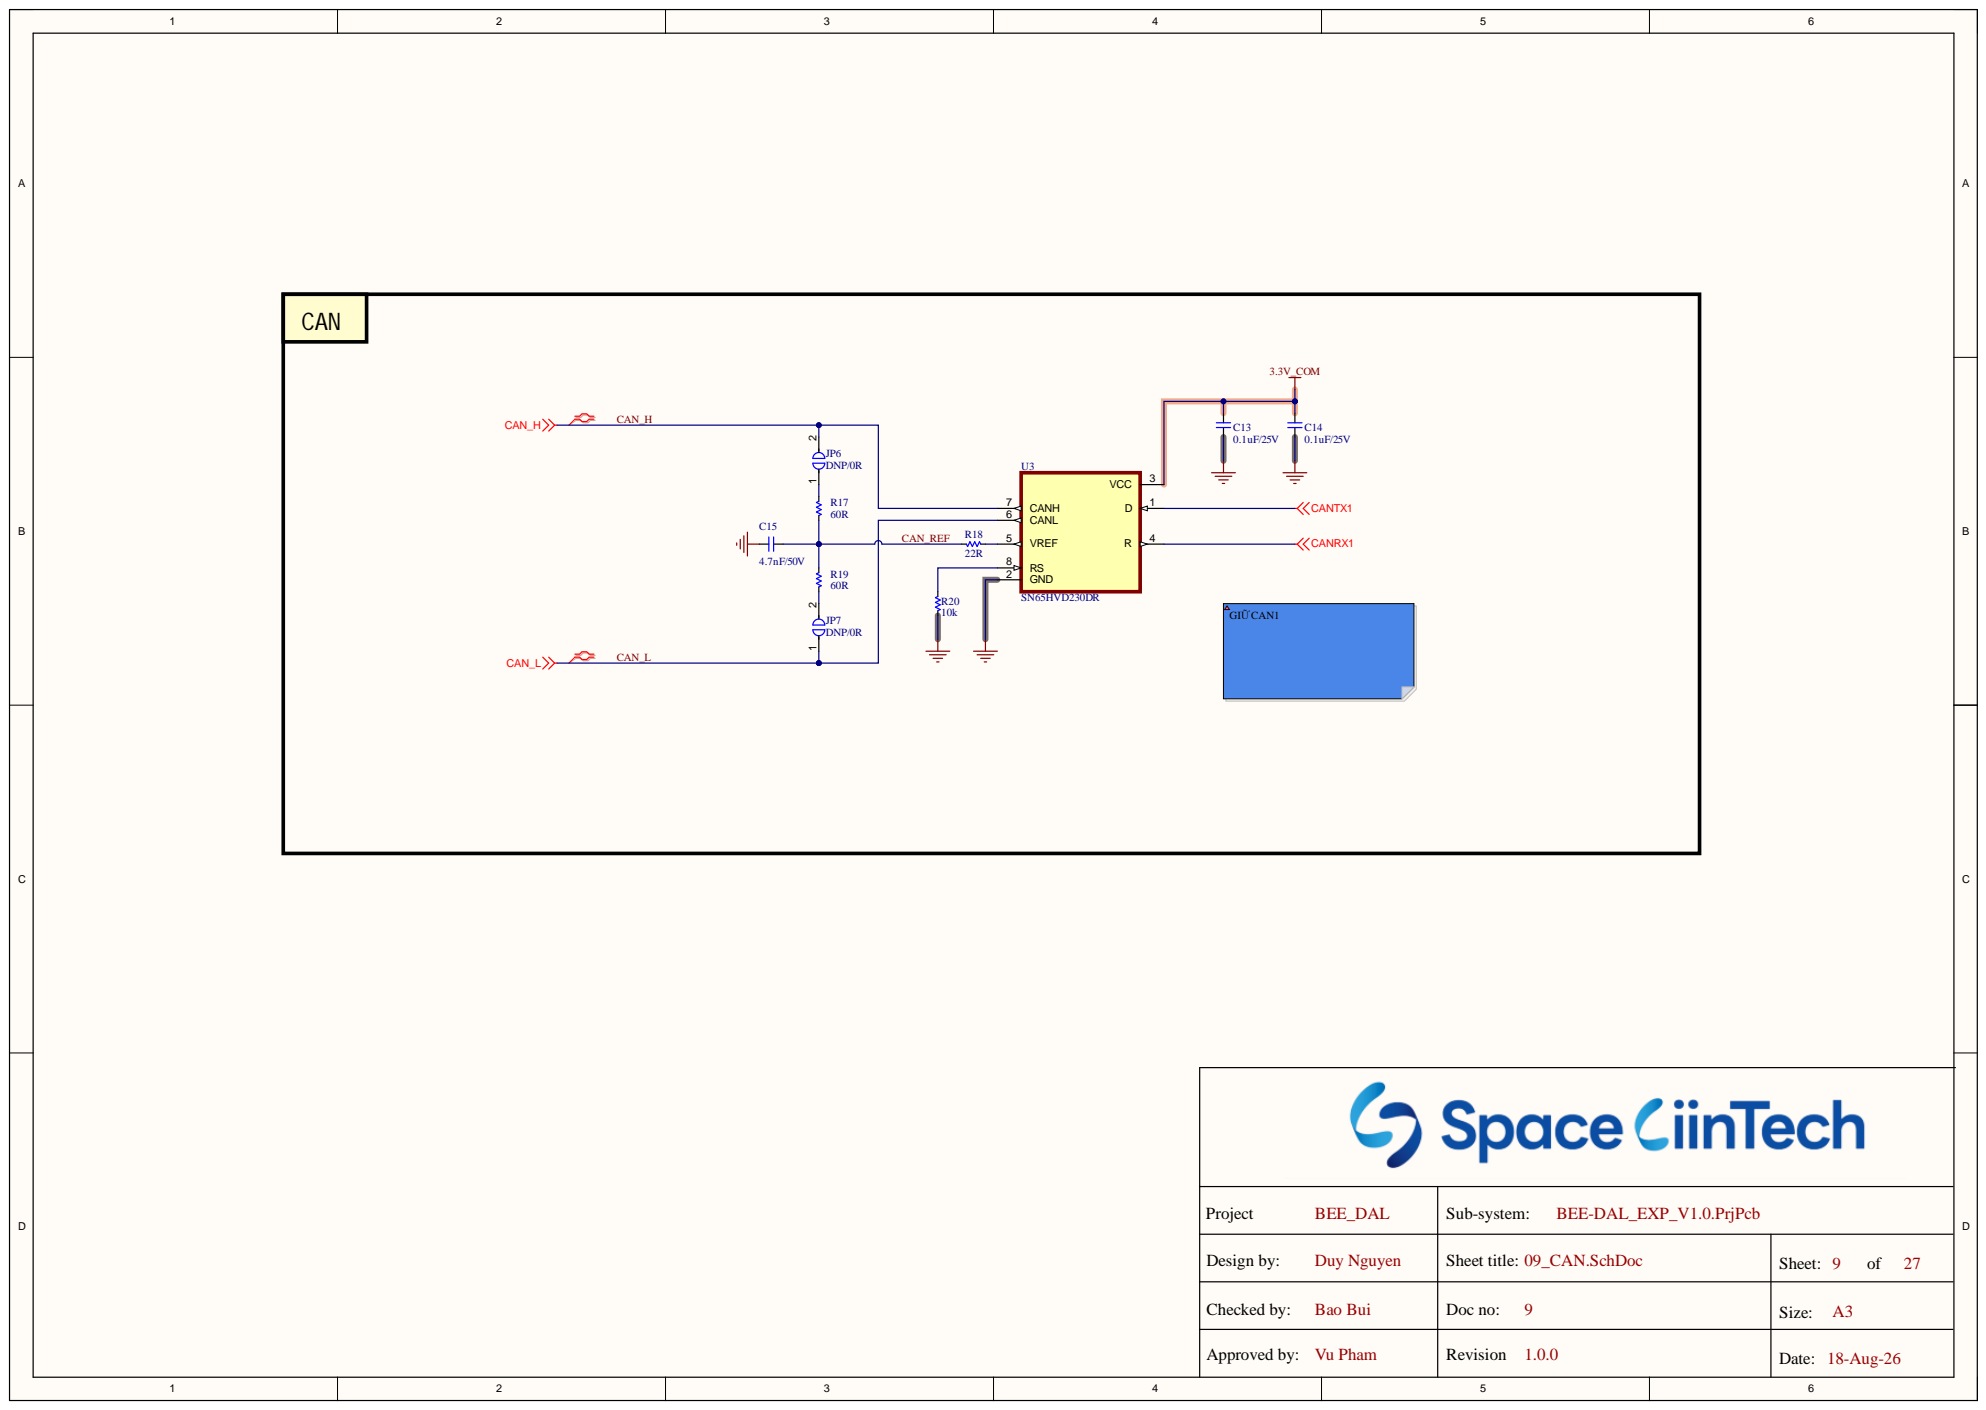
[picture p15: page 9]

Design by: Project BEE_DAL | Sub-system: BEE-DAL_EXP_V1.0.P rjP c b

Che cked by: B ao Bui | Doc no: Revision Sheet title 9 | 18-Aug-26 9 of 27 Siz e : A3

Duy Nguye n | : 09_CAN.S chDoc | She et:

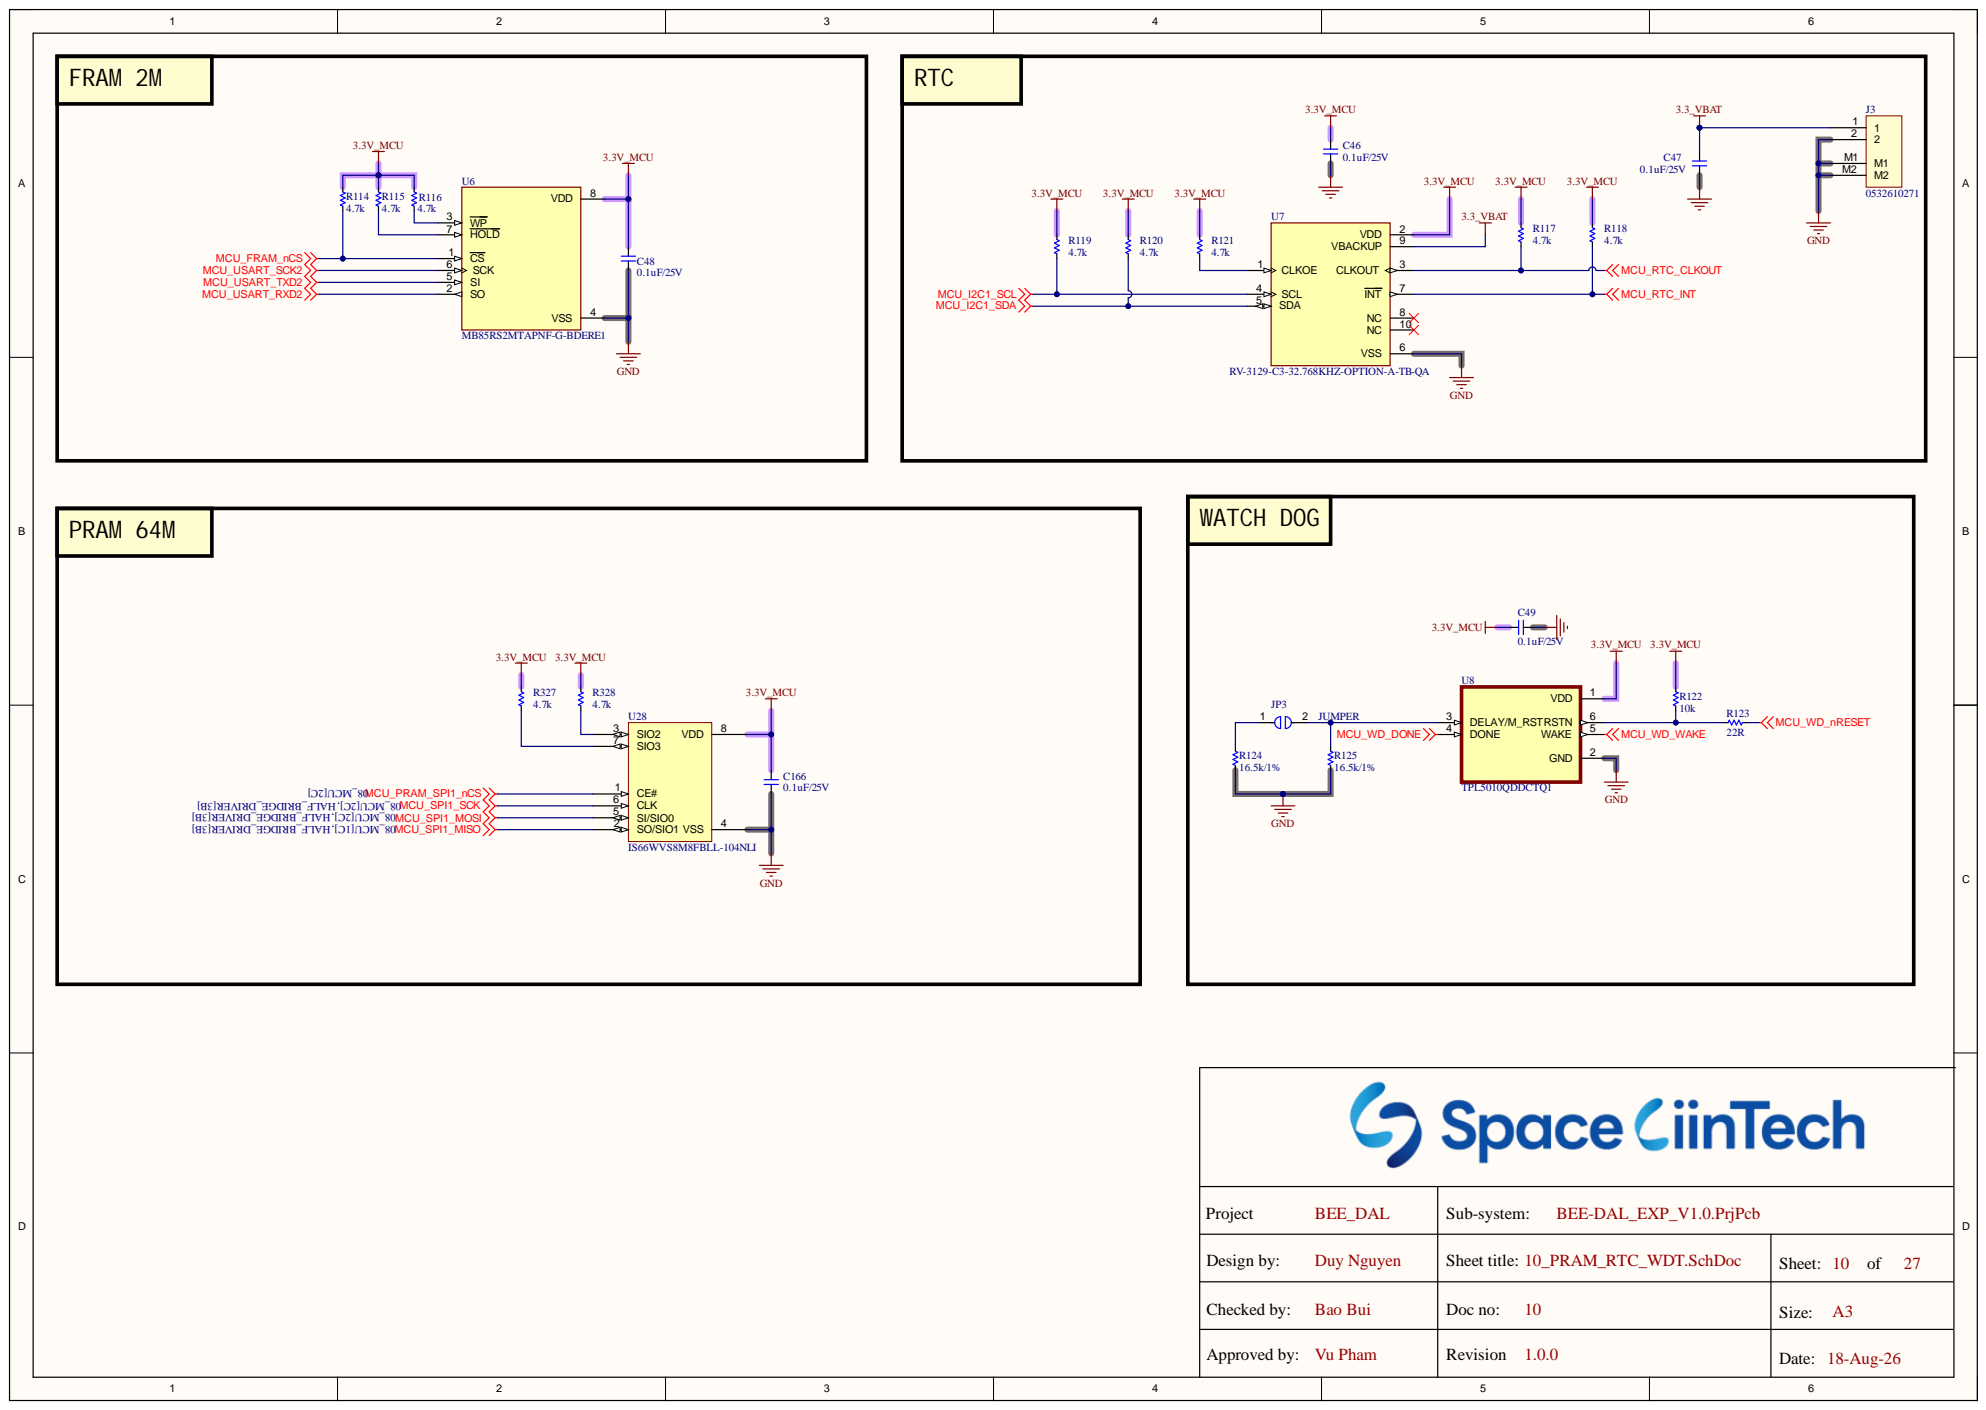
[picture p16: page 10]

RV-3129-C3-32.768KHZ-OPTION-A-TB-QA

Project BEE_DAL | Sub-system: BEE-DAL_EXP_V1.0.PrjPcb

Design by: Duy Nguyen | Sheet title: 10_PRAM_RTC_WDT.SchDoc | Sheet: 10 of 27

Checked by: Bao Bui | Doc no: 10 | Size: A3

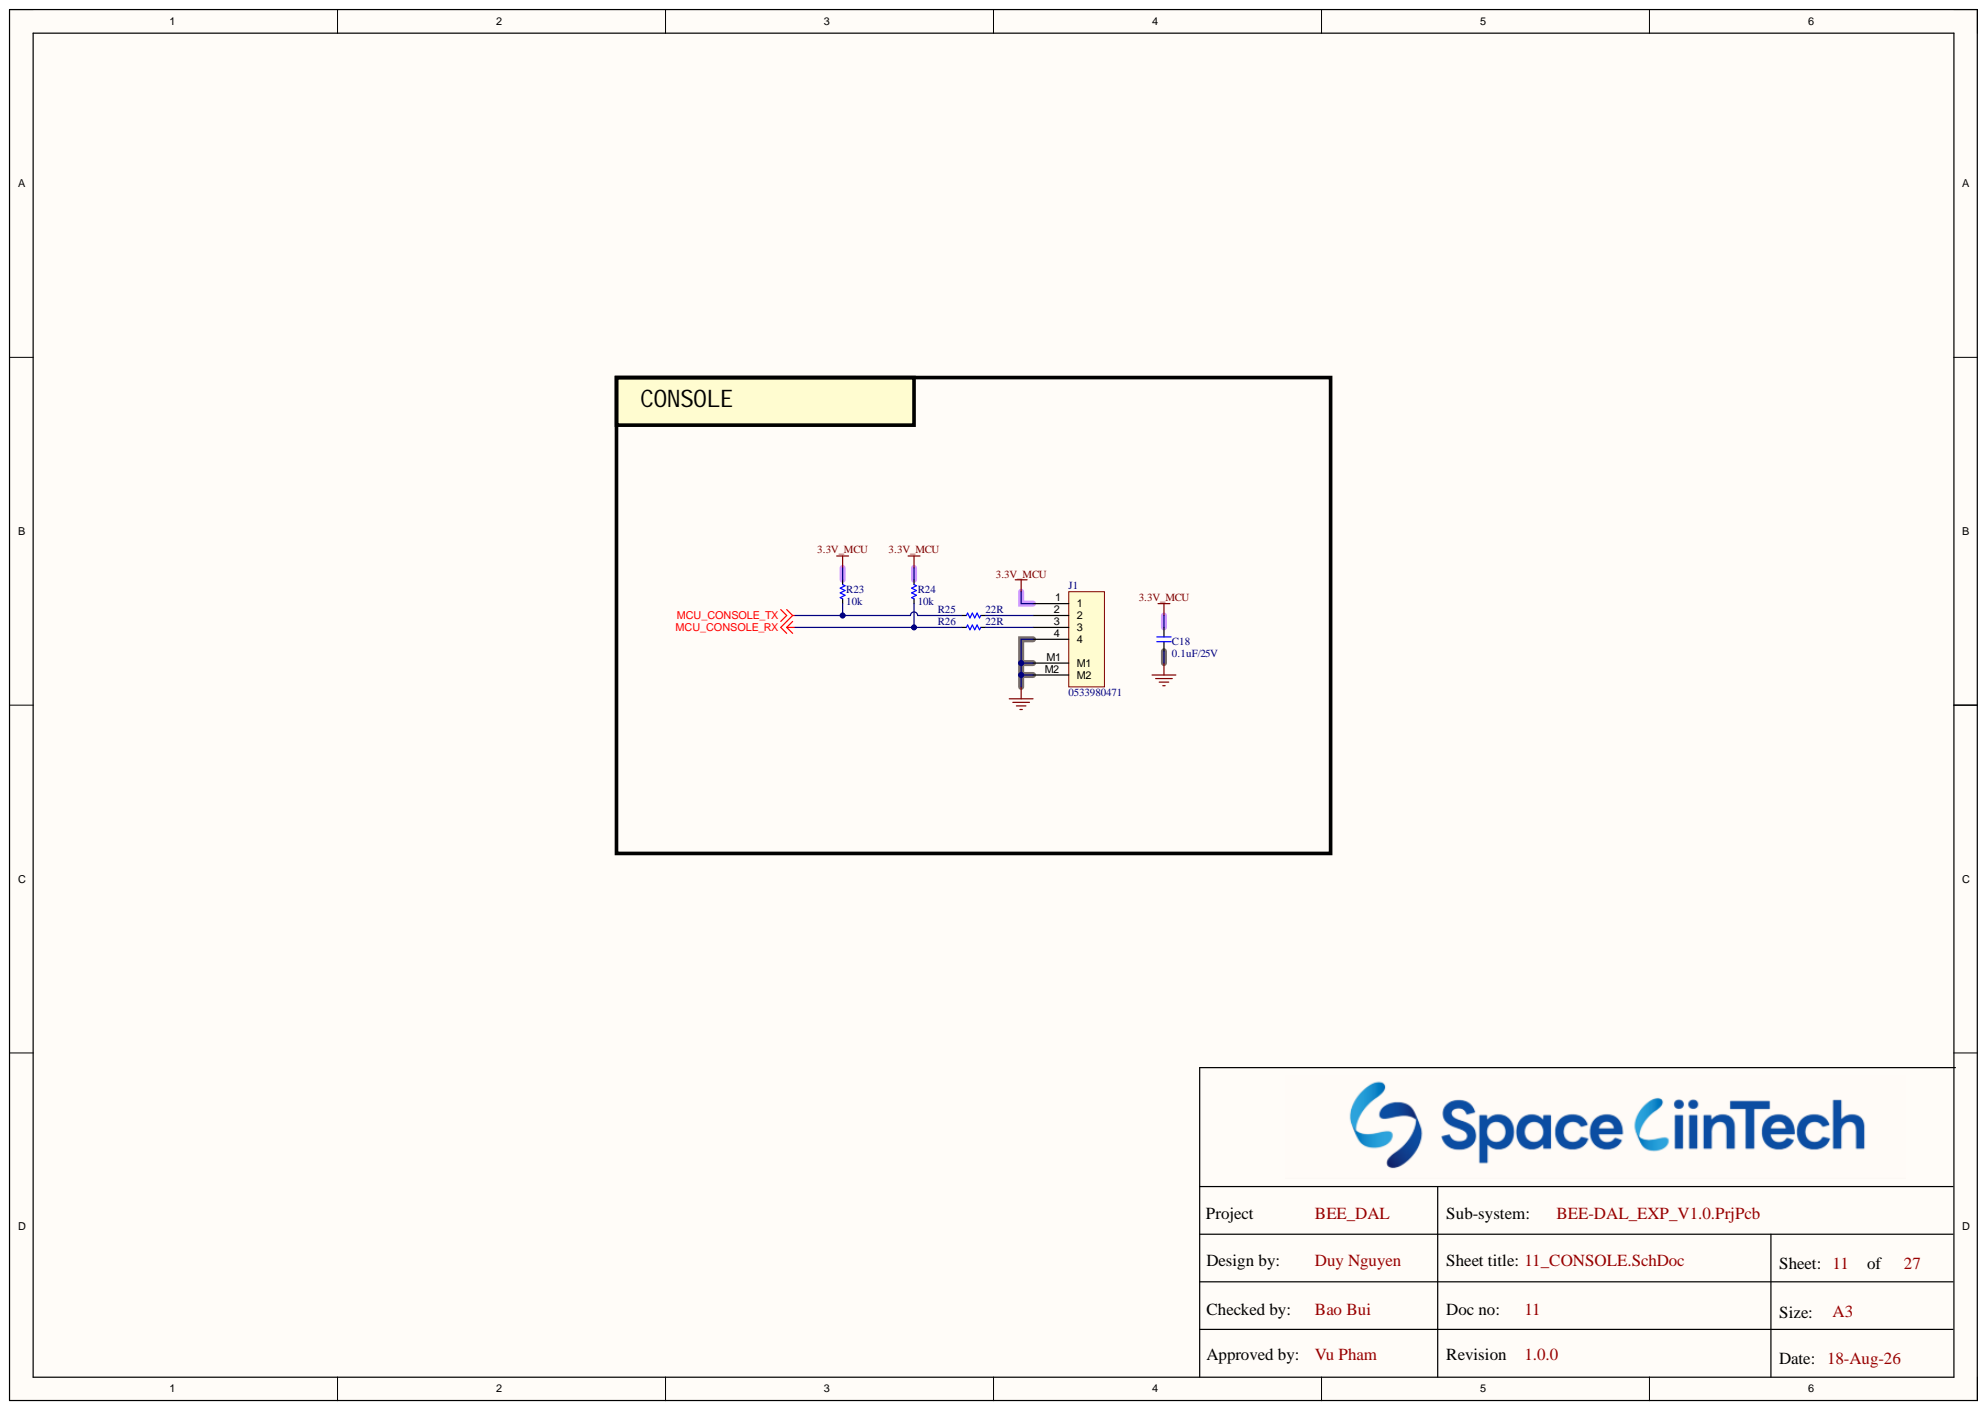
[picture p17: page 11]

M 1
M 2

Design by: Project BEE_DAL | Sub-system: BEE-DAL_EXP_V1.0.P rjP c b

Che cked by: B ao Bui | Doc no: Revision Sheet title 1.0.0 11_CONSOLE.S 1 1 | 18-Aug-26 11 of 27 Siz e : A3

Duy Nguye n | : chDoc | She et:

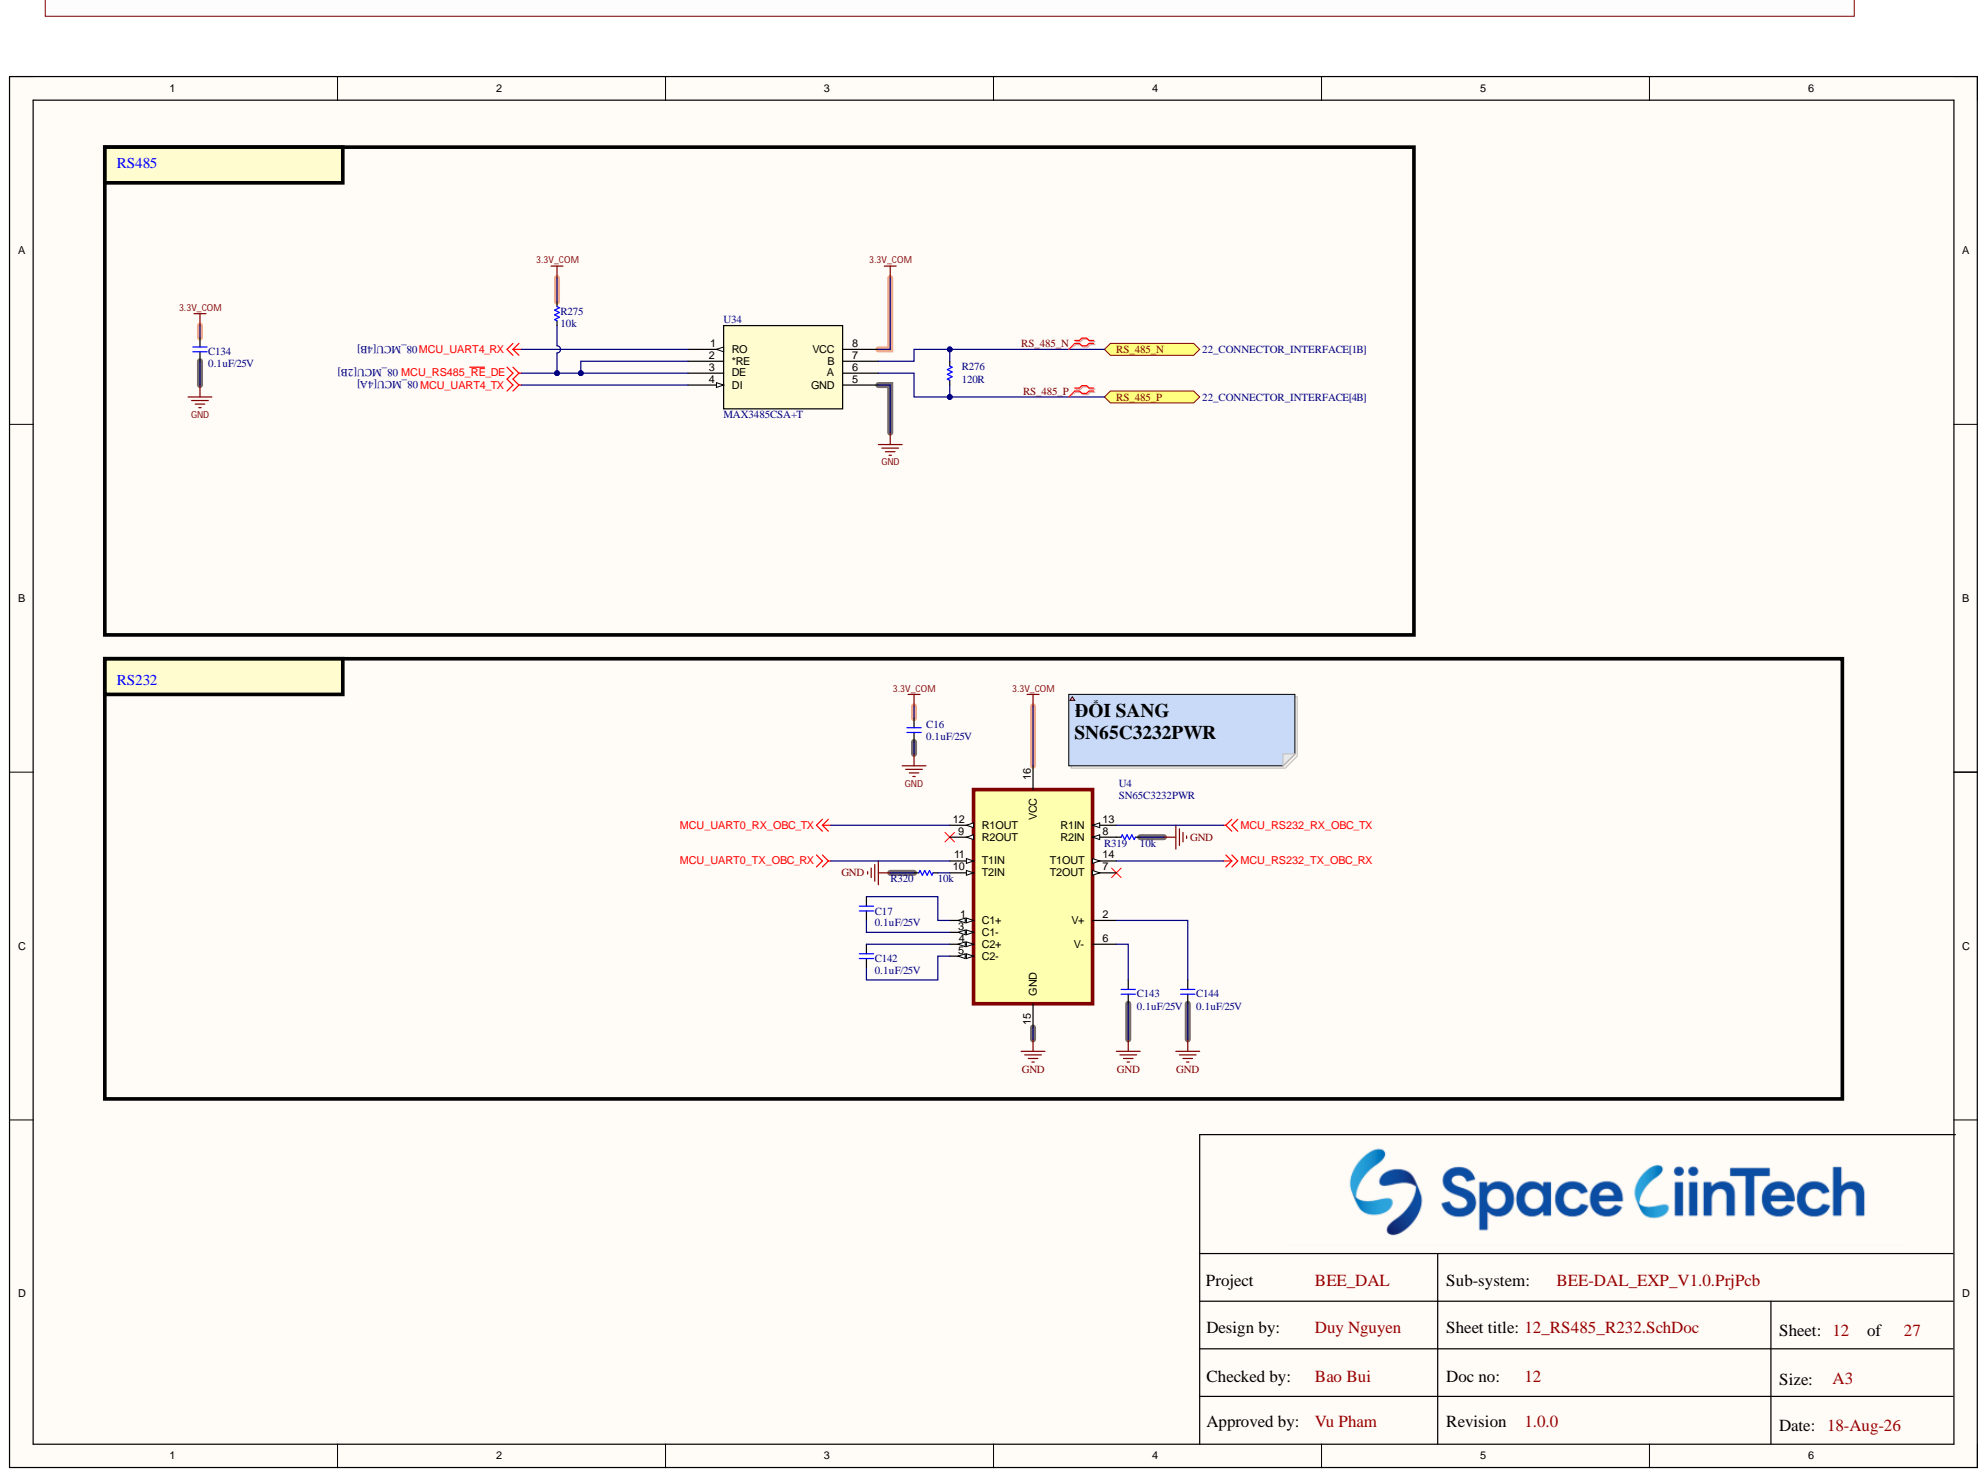
[picture p18: page 12]

Project BEE_DAL | Sub-system: BEE-DAL_EXP_V1.0.PrjPcb

Design by: Duy Nguyen | Sheet title: 12_RS485_R232.SchDoc | Sheet: 12 of 27

Checked by: Bao Bui | Doc no: 12 | Size: A3

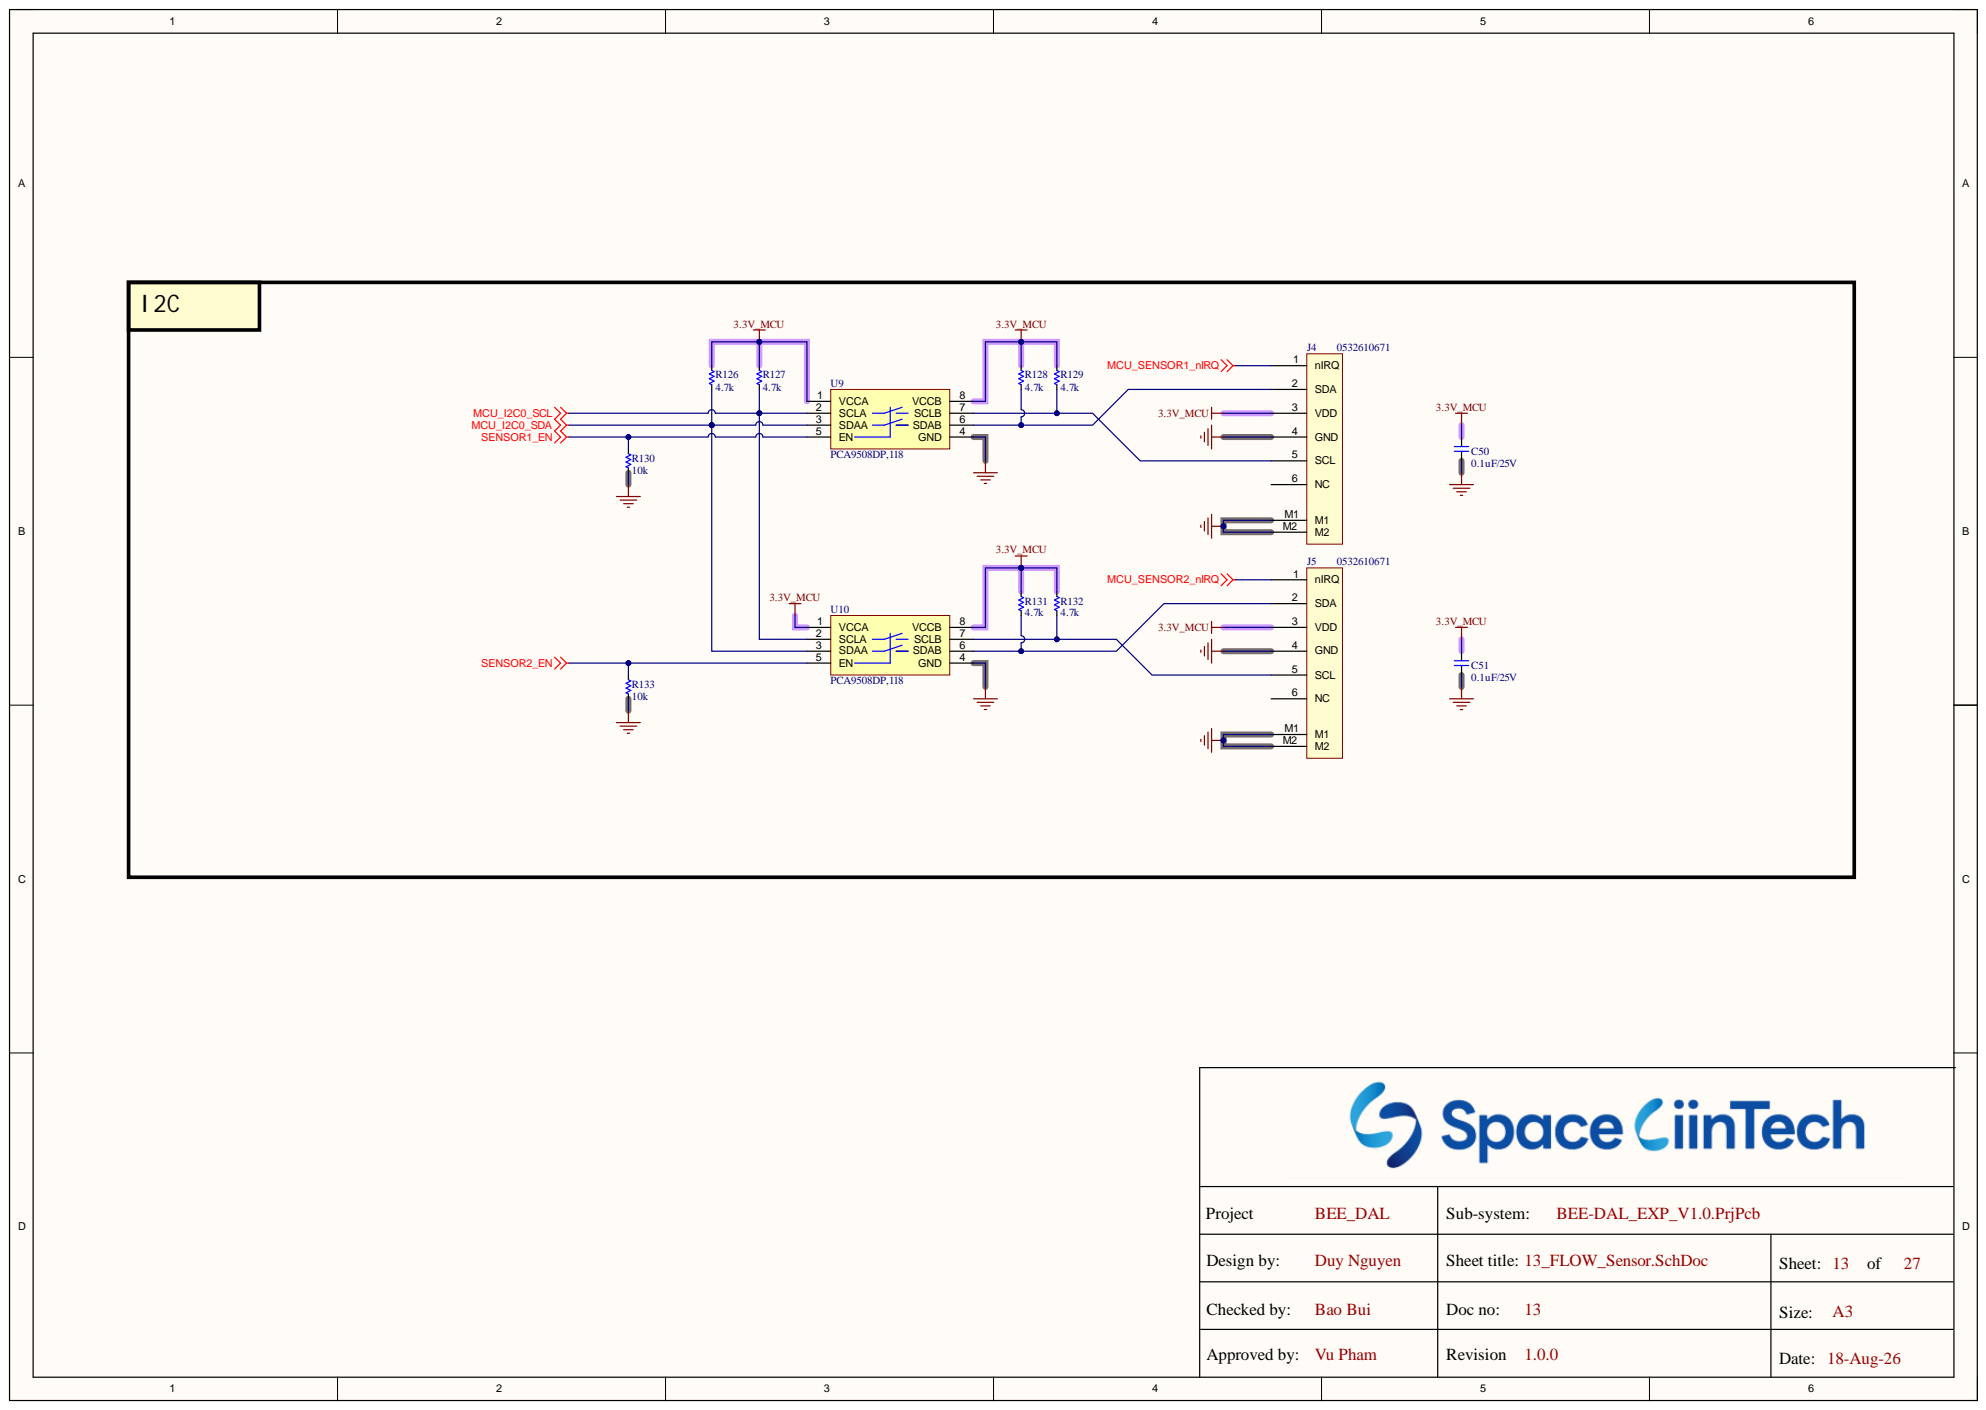
[picture p19: page 13]

Design by: Project BEE_DAL | Sub-system: BEE-DAL_EXP_V1.0.P rjP c b

Che cked by: B ao Bui | Doc no: Revision Sheet title 13 | Siz e : A3

Duy Nguye n | : 13_FLOW_S ensor.S chDoc | She et: 13 of 27

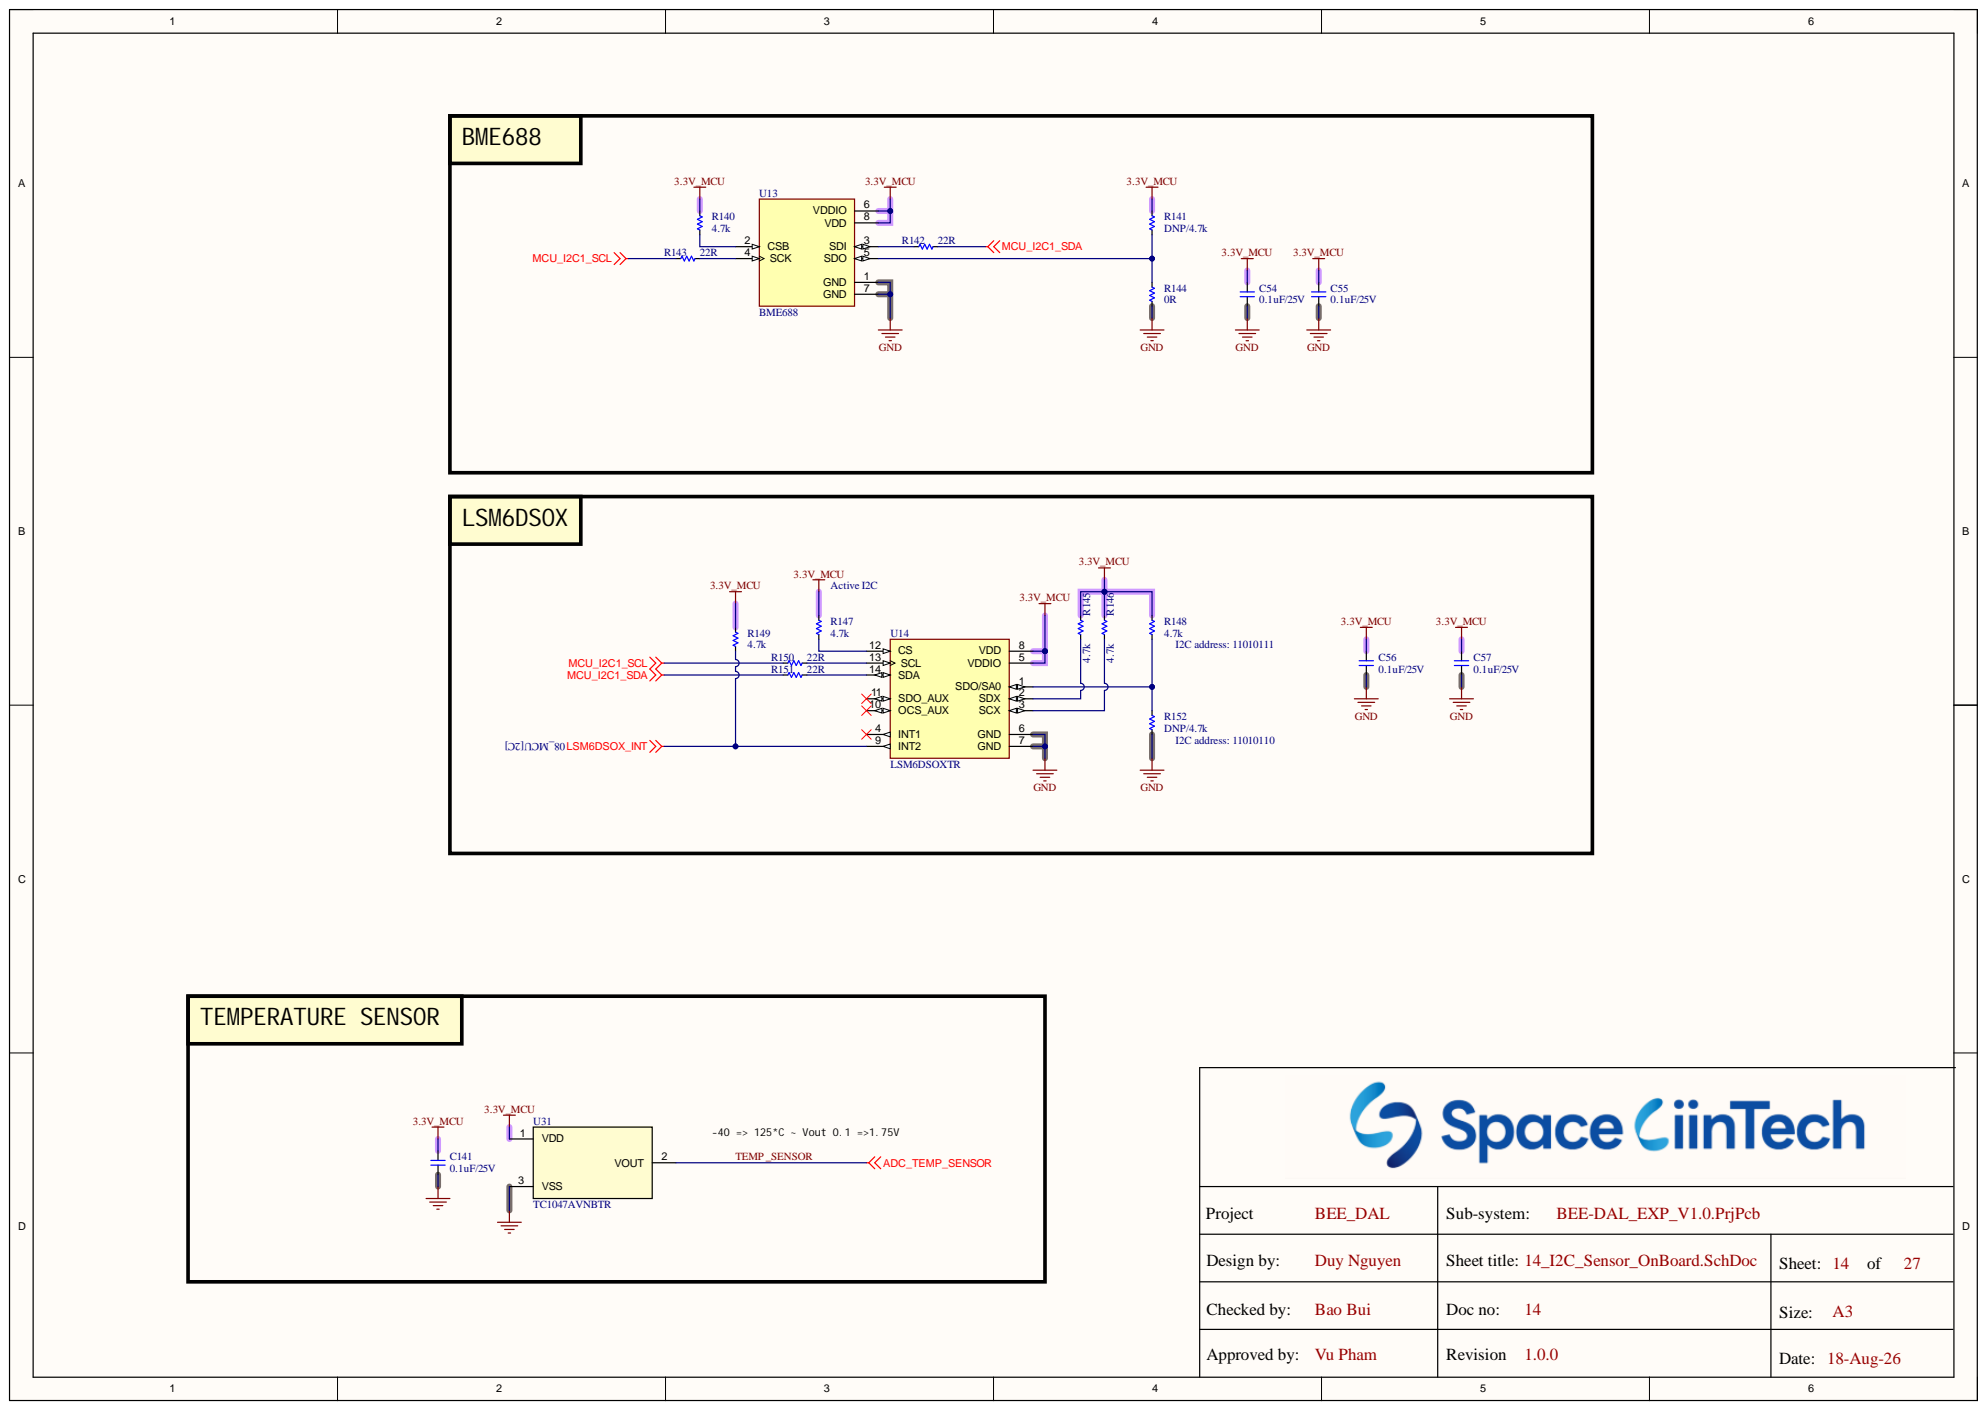
[picture p20: page 14]

Project BEE_DAL | Sub-system: BEE-DAL_EXP_V1.0.PrjPcb

Design by: Duy Nguyen | Sheet title: 14_I2C_Sensor_OnBoard.SchDoc | Sheet: 14 of 27

Checked by: Bao Bui | Doc no: 14 | Size: A3

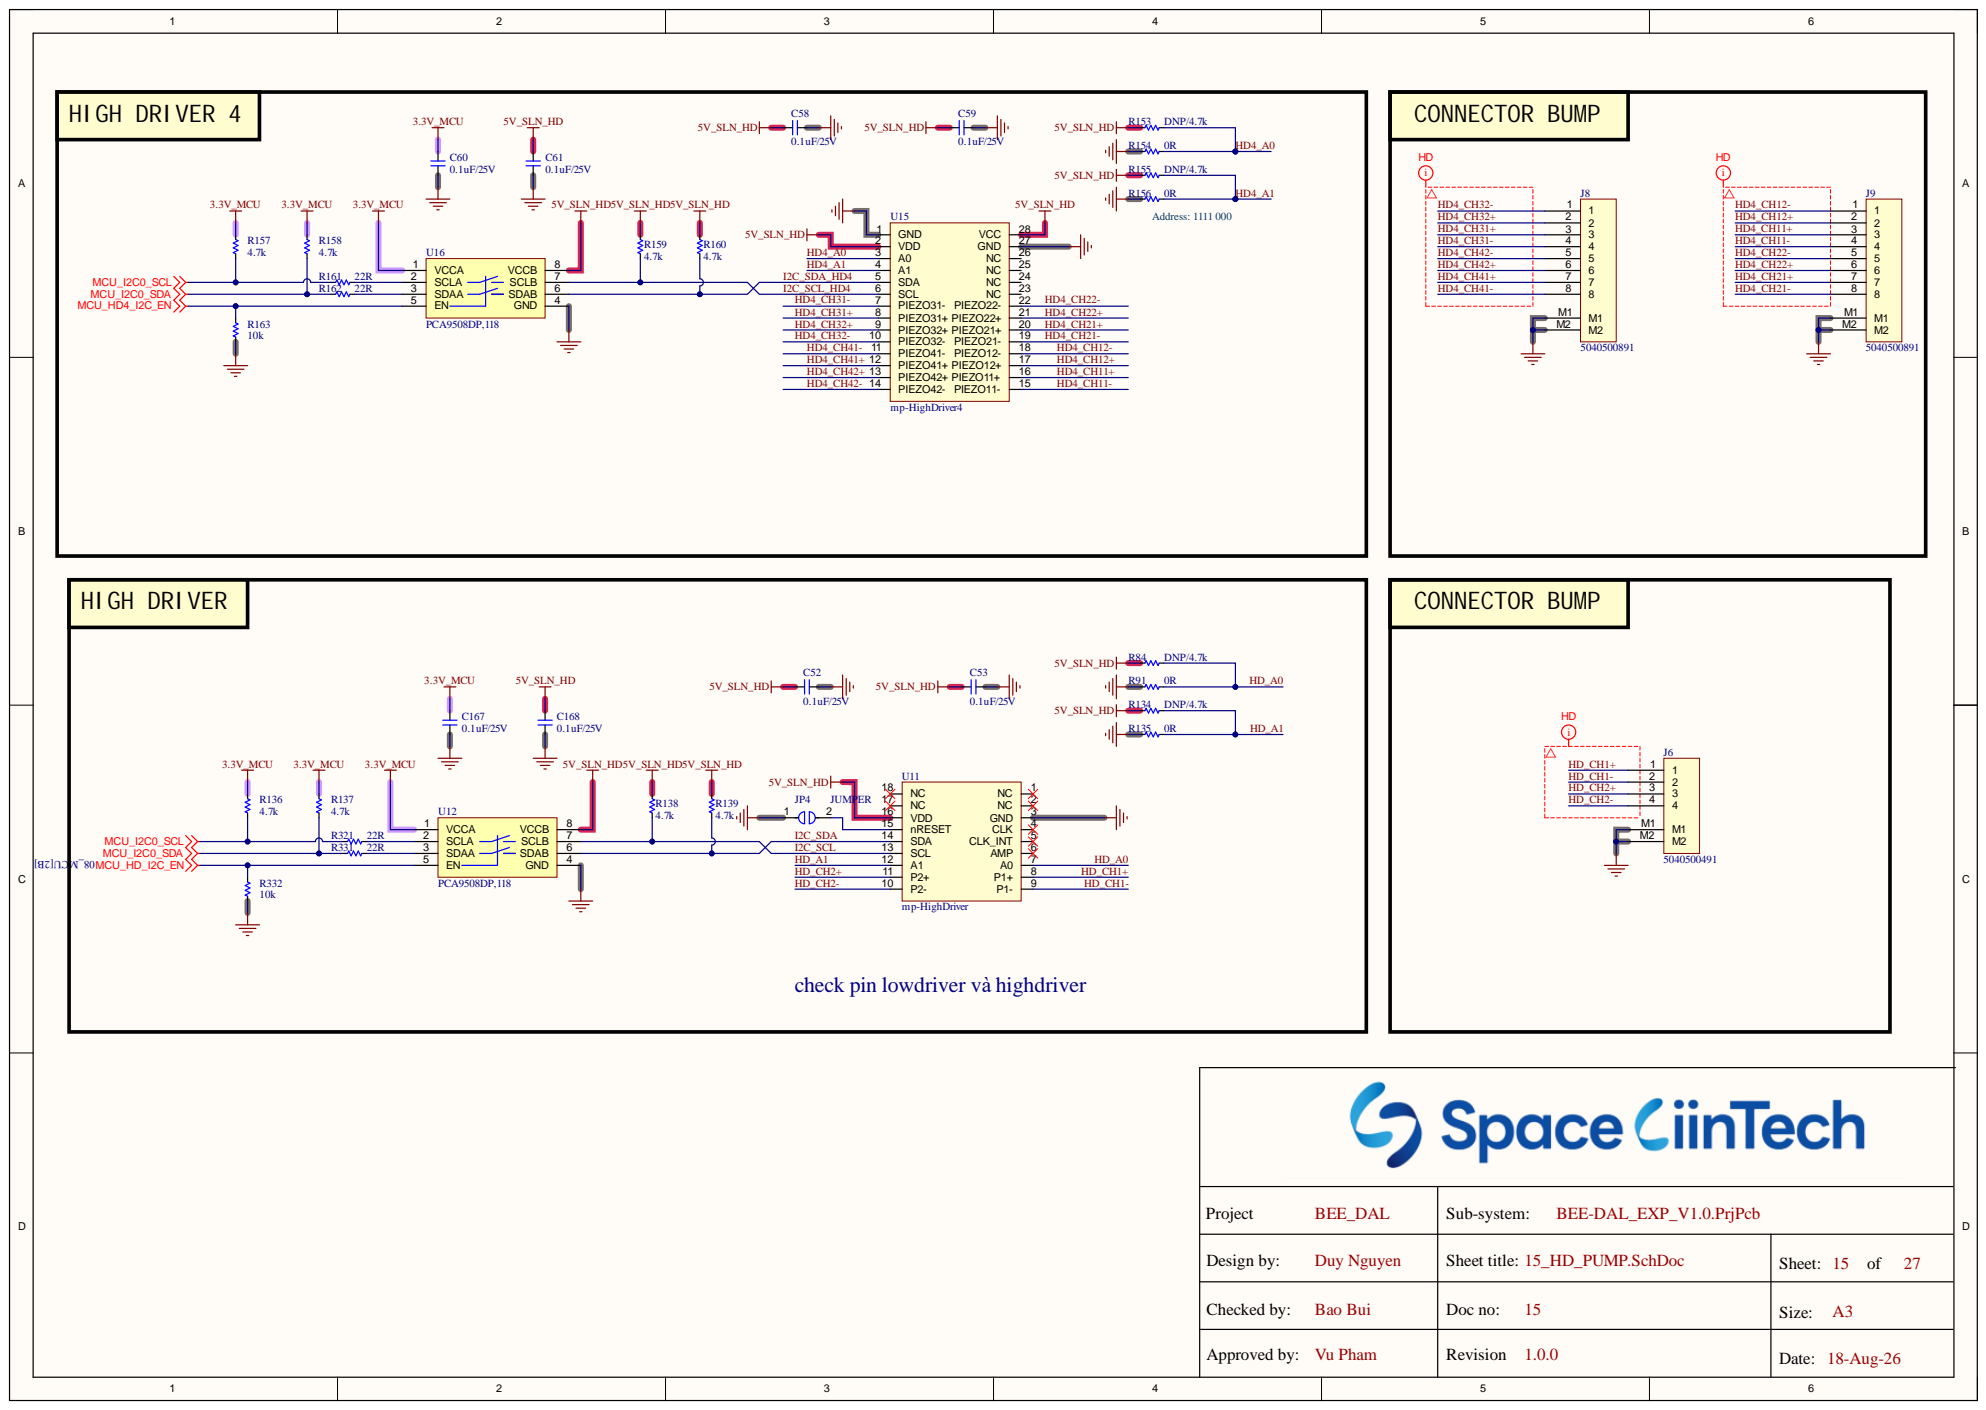
[picture p21: page 15]

check pin lowdriver và highdriver

Project BEE_DAL | Sub-system: BEE-DAL_EXP_V1.0.PrjPcb

Design by: Duy Nguyen | Sheet title: 15_HD_PUMP.SchDoc | Sheet: 15 of 27

Checked by: Bao Bui | Doc no: 15 | Size: A3

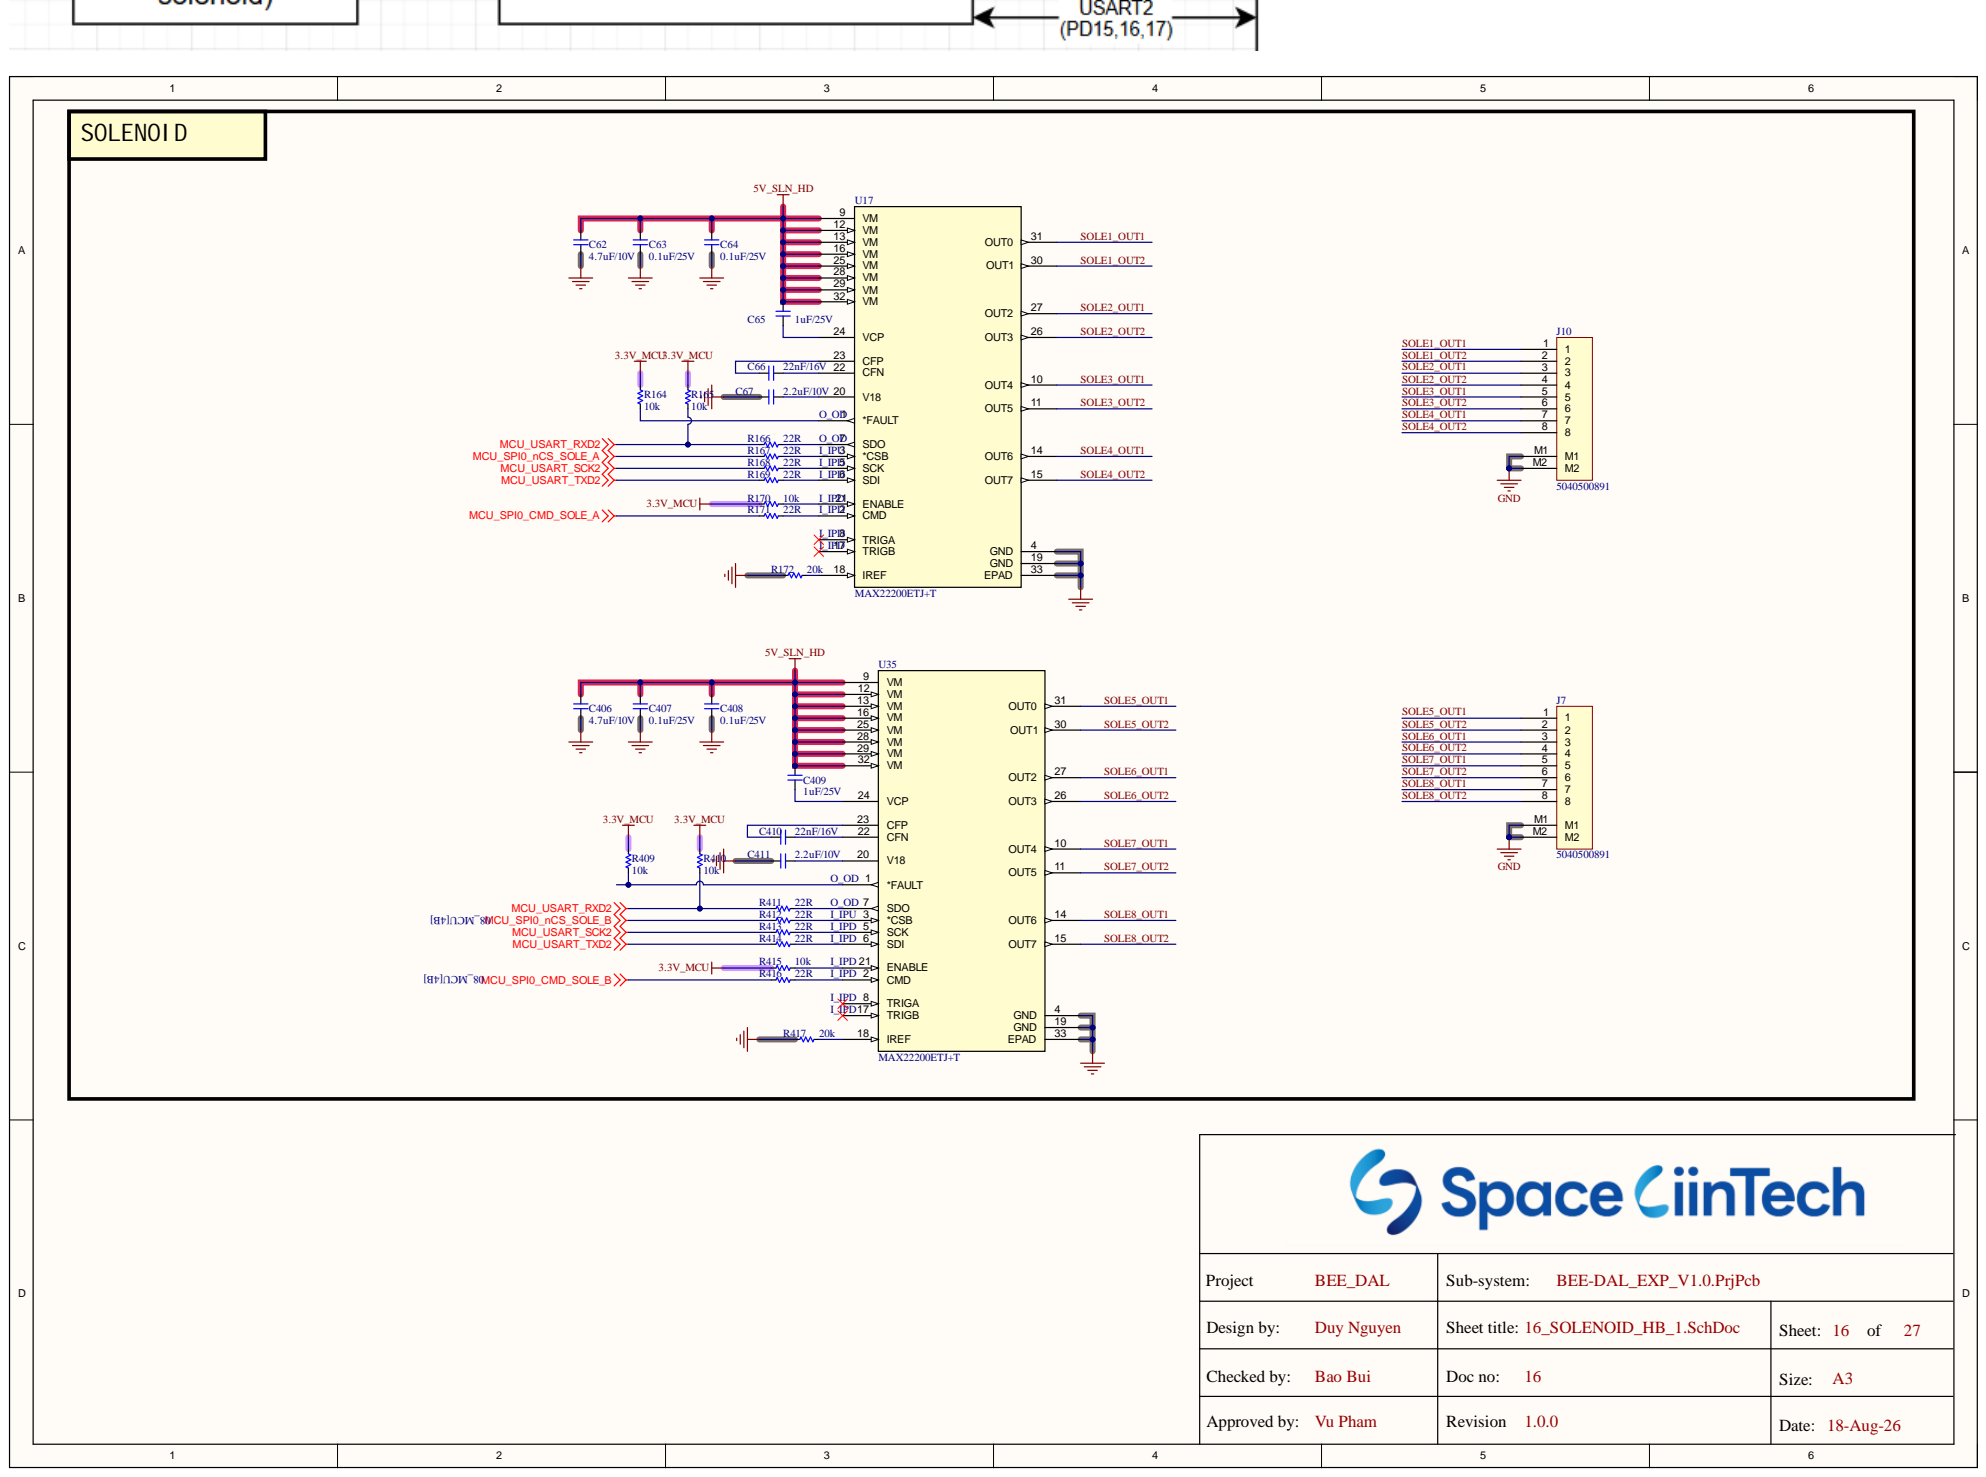
[picture p22: page 16]

Design by: Project BEE_DAL | Sub-system: BEE-DAL_EXP_V1.0.P rjP c b

Che cked by: B ao Bui | Doc no: Revision Sheet title 16 | Siz e : A3

Duy Nguye n | : 16_SOLENOID_HB_1.S chDoc | She et: 16 of 27

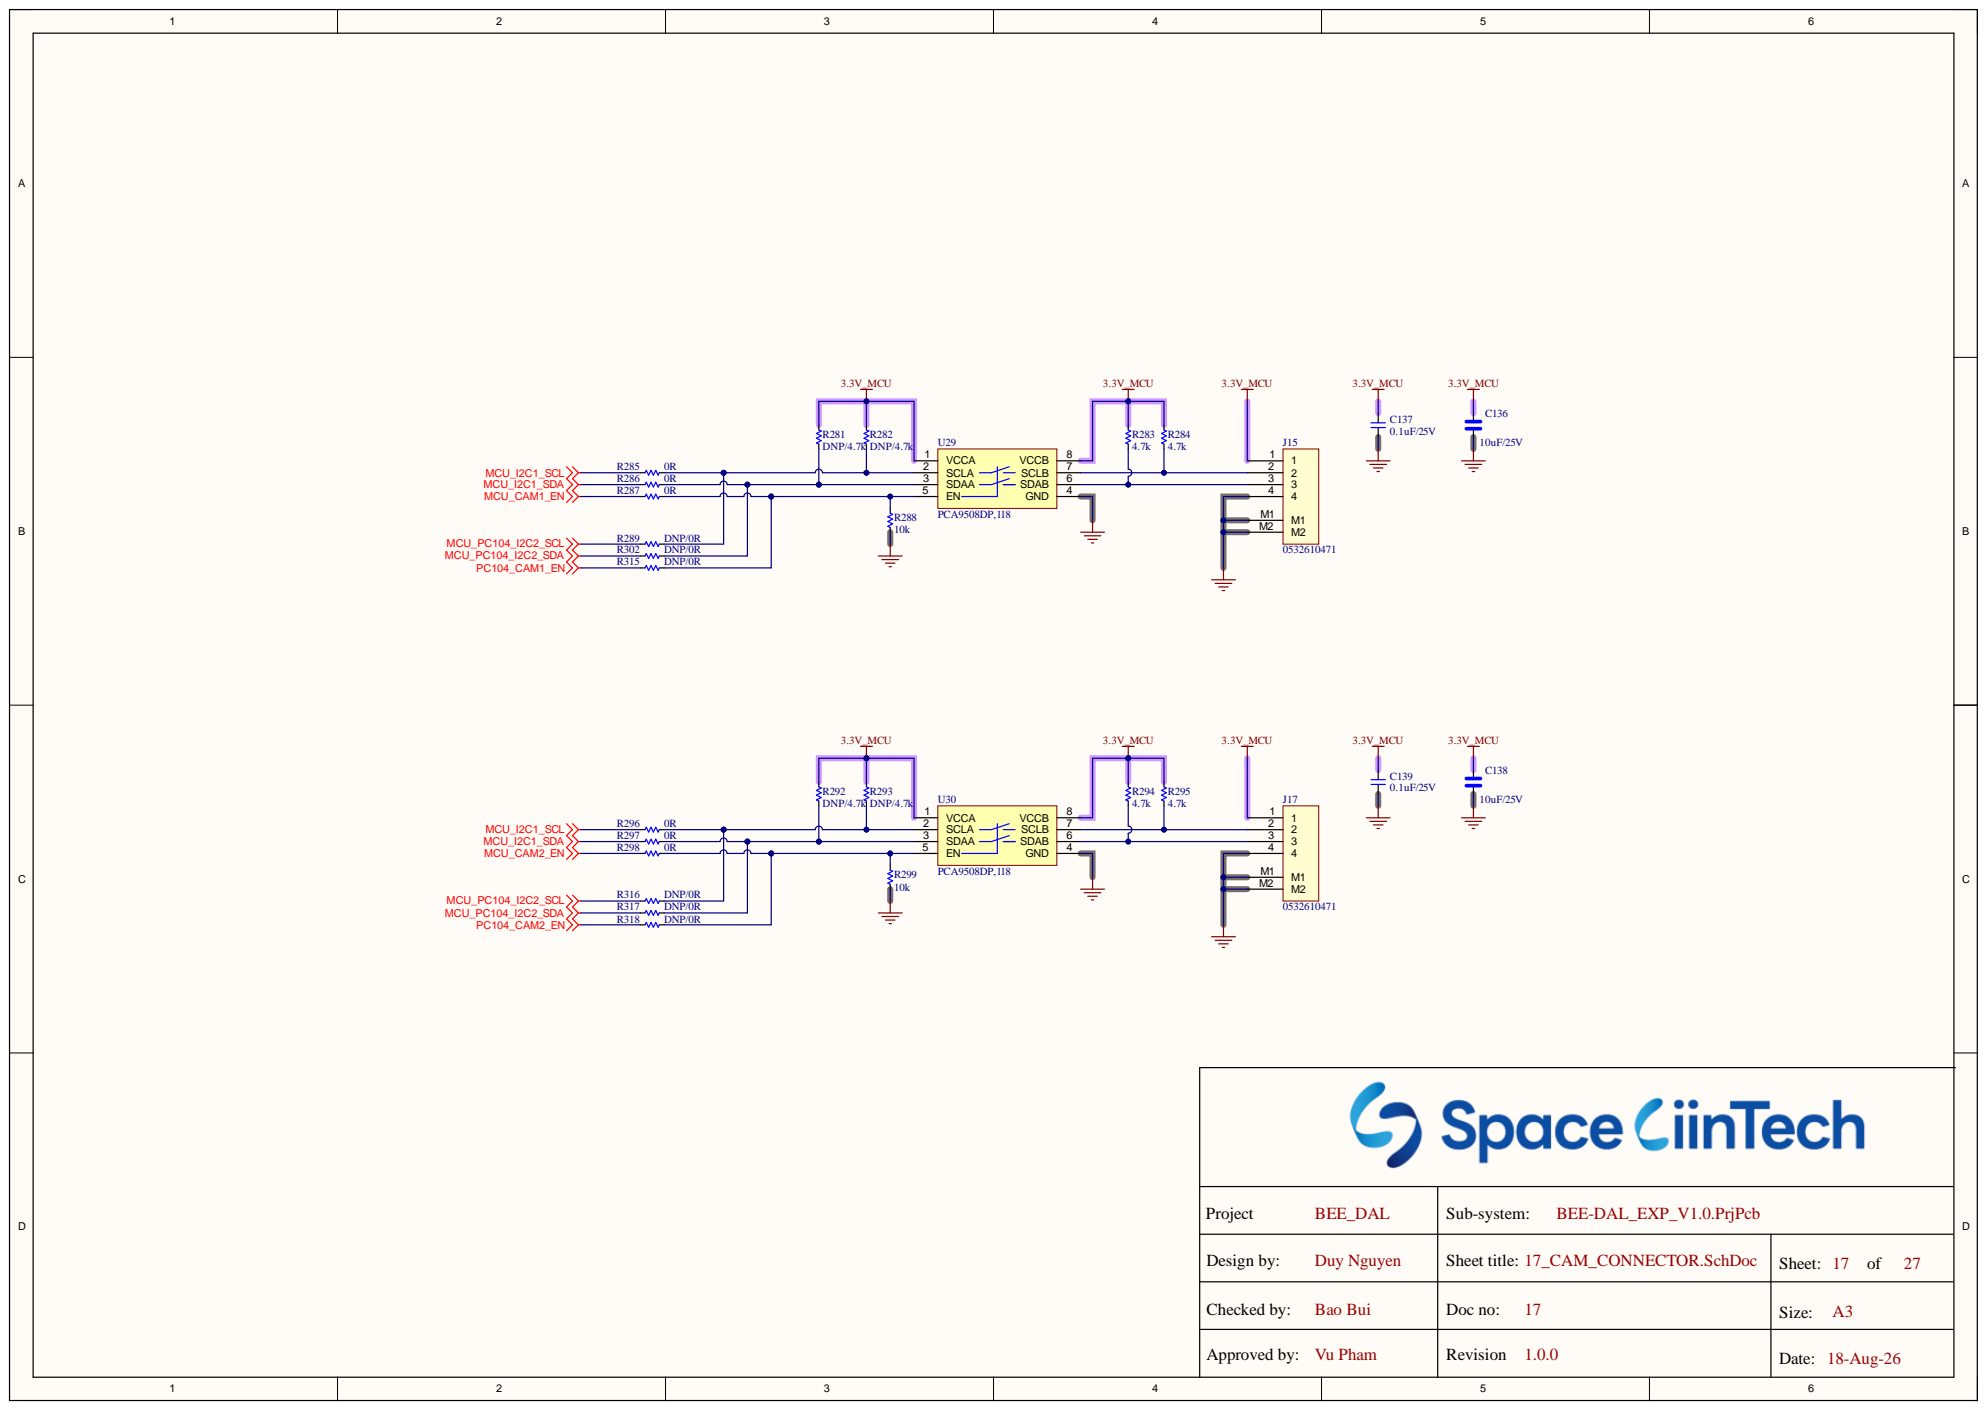
[picture p23: page 17]

Design by: Project BEE_DAL | Sub-system: BEE-DAL_EXP_V1.0.P rjP c b

Che cked by: B ao Bui | Doc no: Revision Sheet title 17 | Siz e : A3

Duy Nguye n | : 17_CAM_CONNEC TOR.S chDoc | She et: 17 of 27

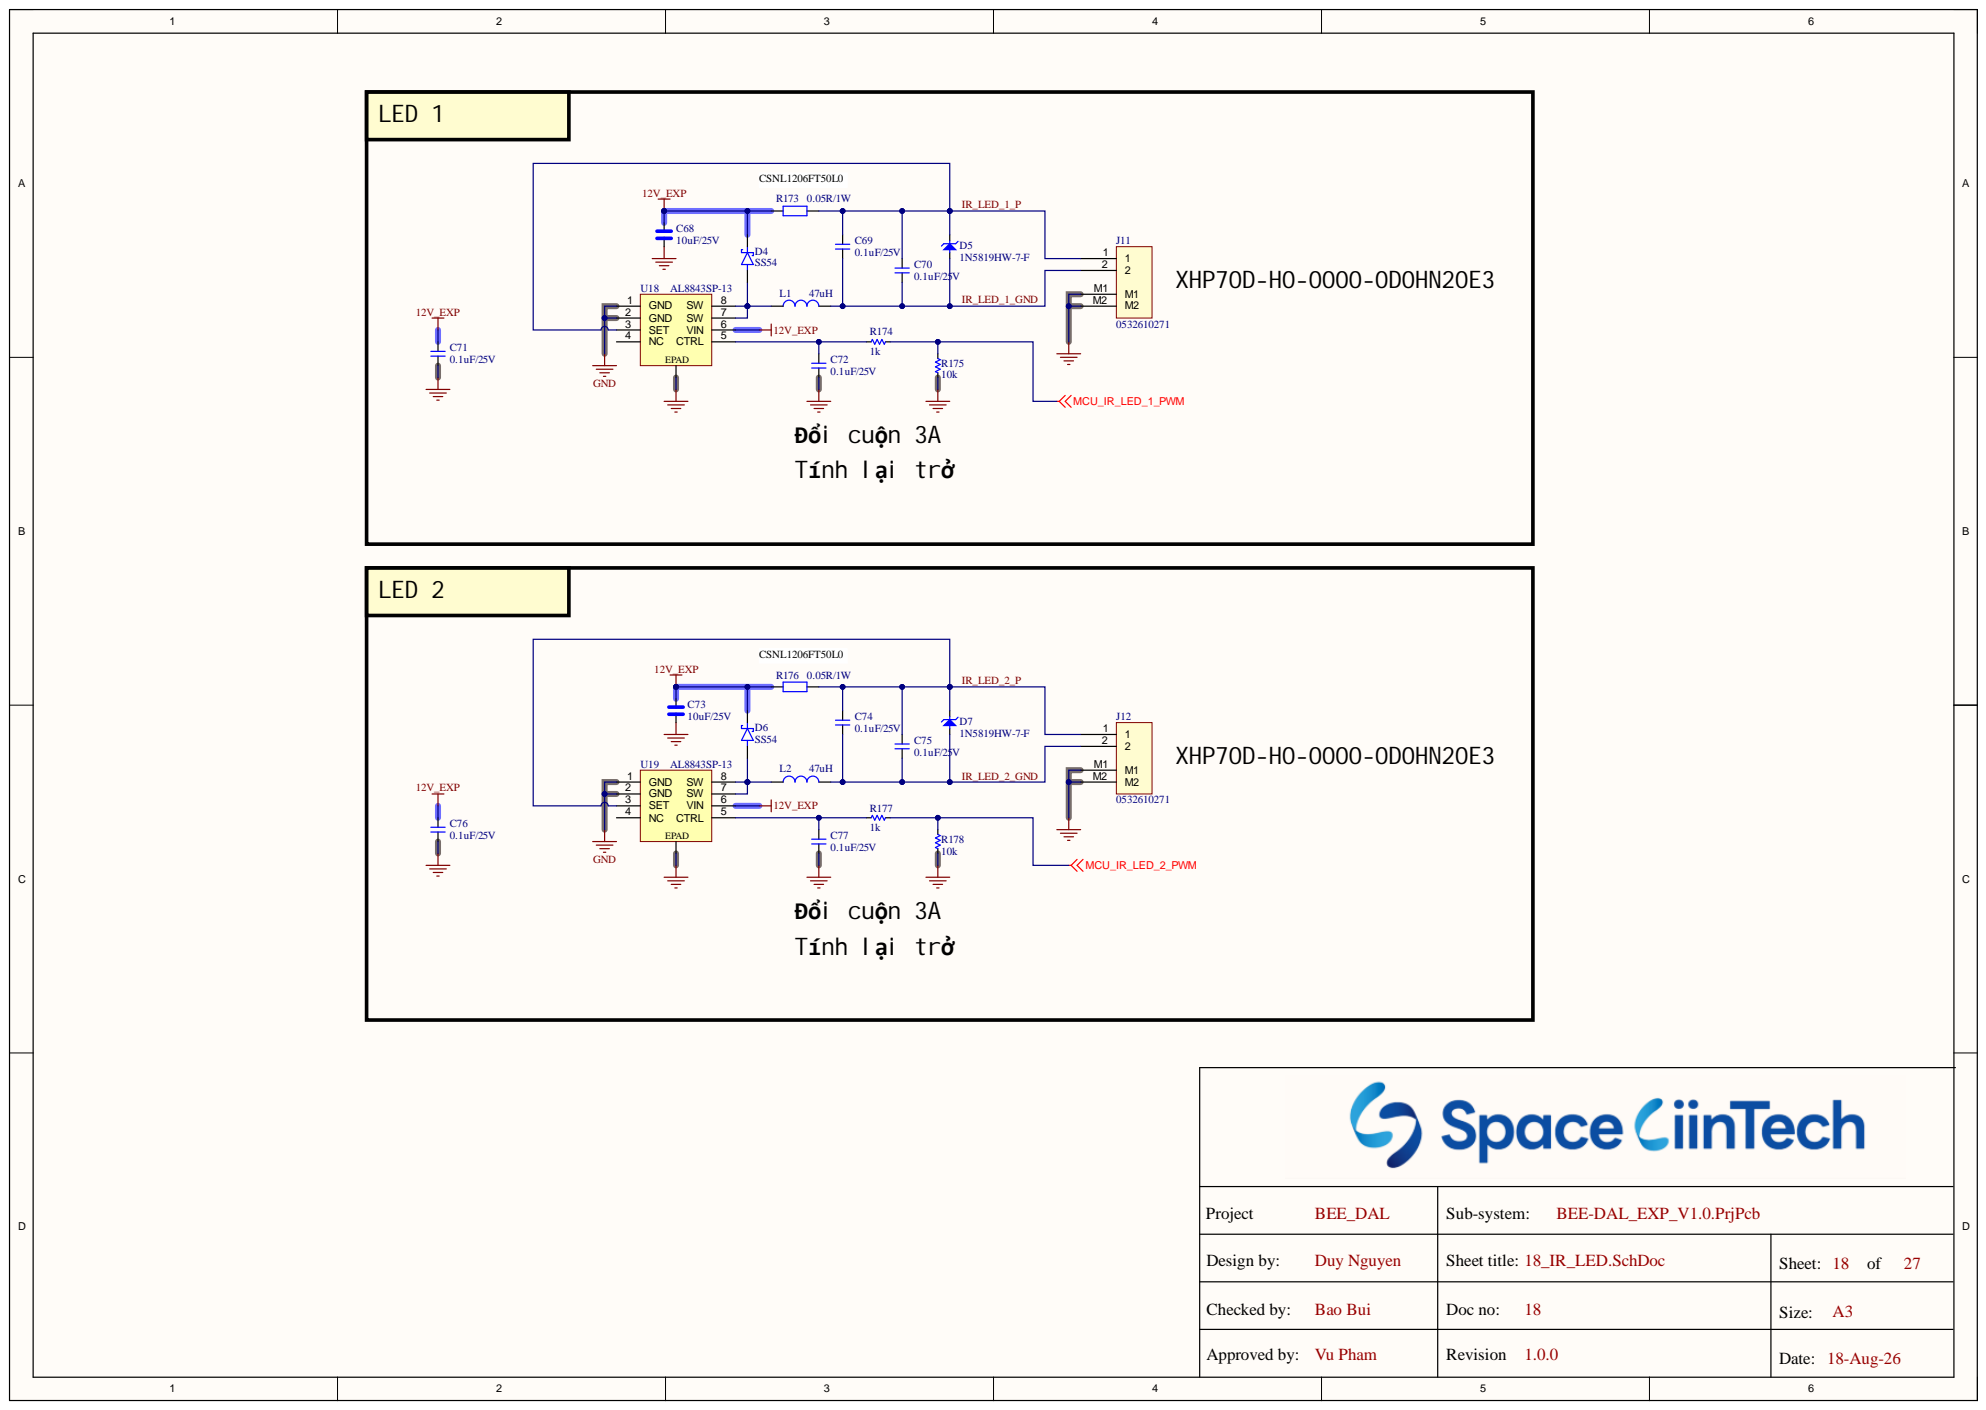
[picture p24: page 18]

GND 2

EPAD | Đổi cuộn 3A Tính lại trở

SET 3

Project BEE_DAL | Sub-system: BEE-DAL_EXP_V1.0.PrjPcb

Design by: Duy Nguyen | Sheet title: 18_IR_LED.SchDoc | Sheet: 18 of 27

Checked by: Bao Bui | Doc no: 18 | Size: A3

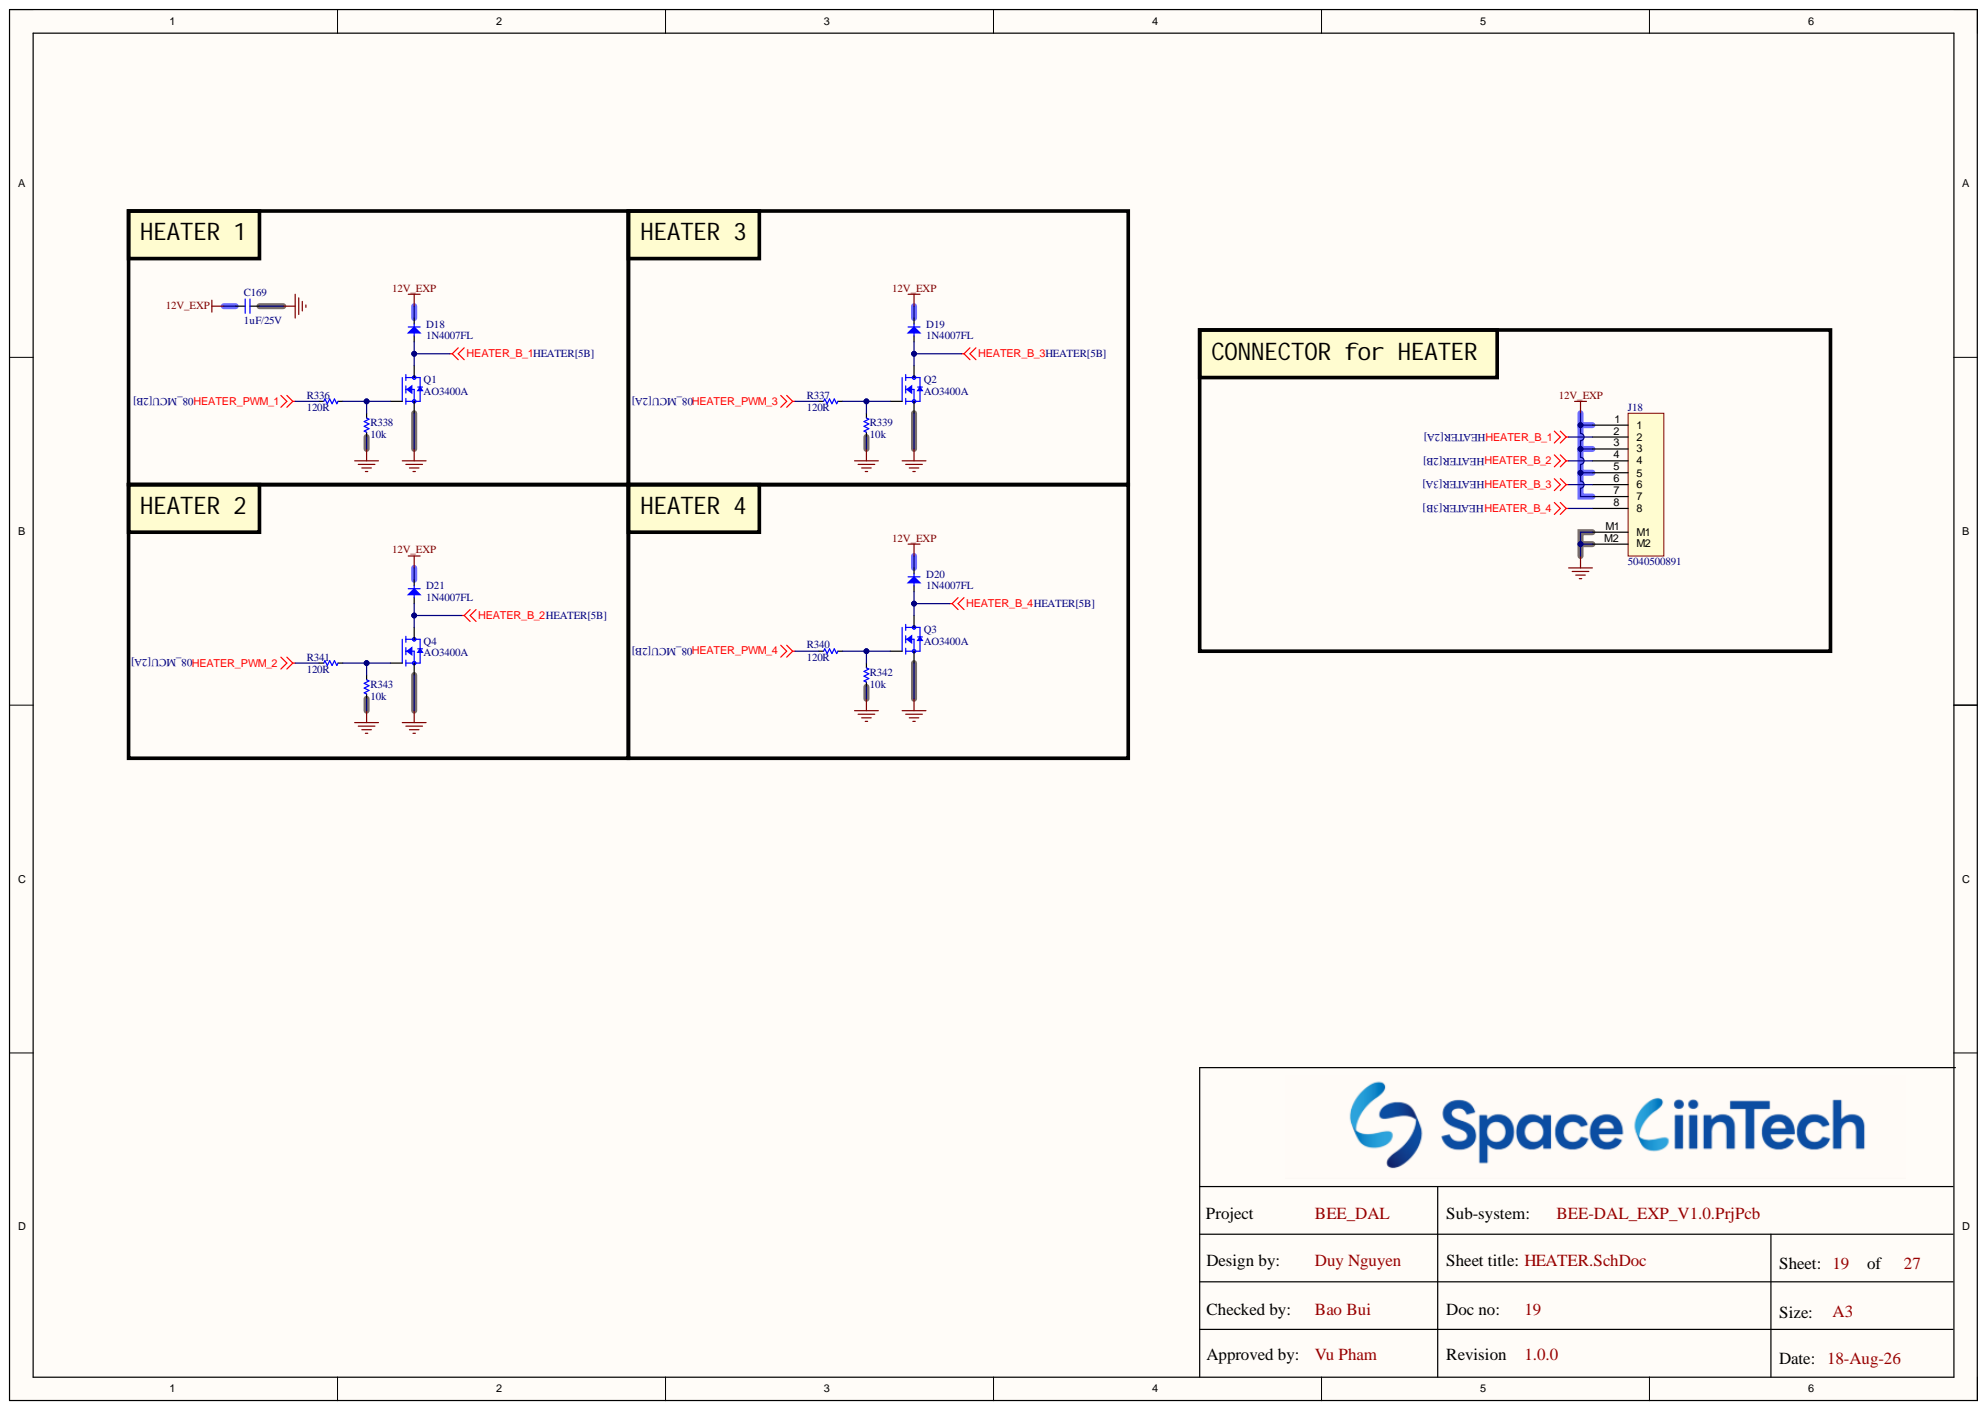
[picture p25: page 19]

HEATER 2 | 12V_EX P | HEATER 4 | 12V_EX P

Design by: Project BEE_DAL | Sub-system: BEE-DAL_EXP_V1.0.P rjP c b

Che cked by: B ao Bui | Doc no: Revision Sheet title 19 | Siz e : A3

Duy Nguye n | : HEATER.S chDoc | She et: 19 of 27

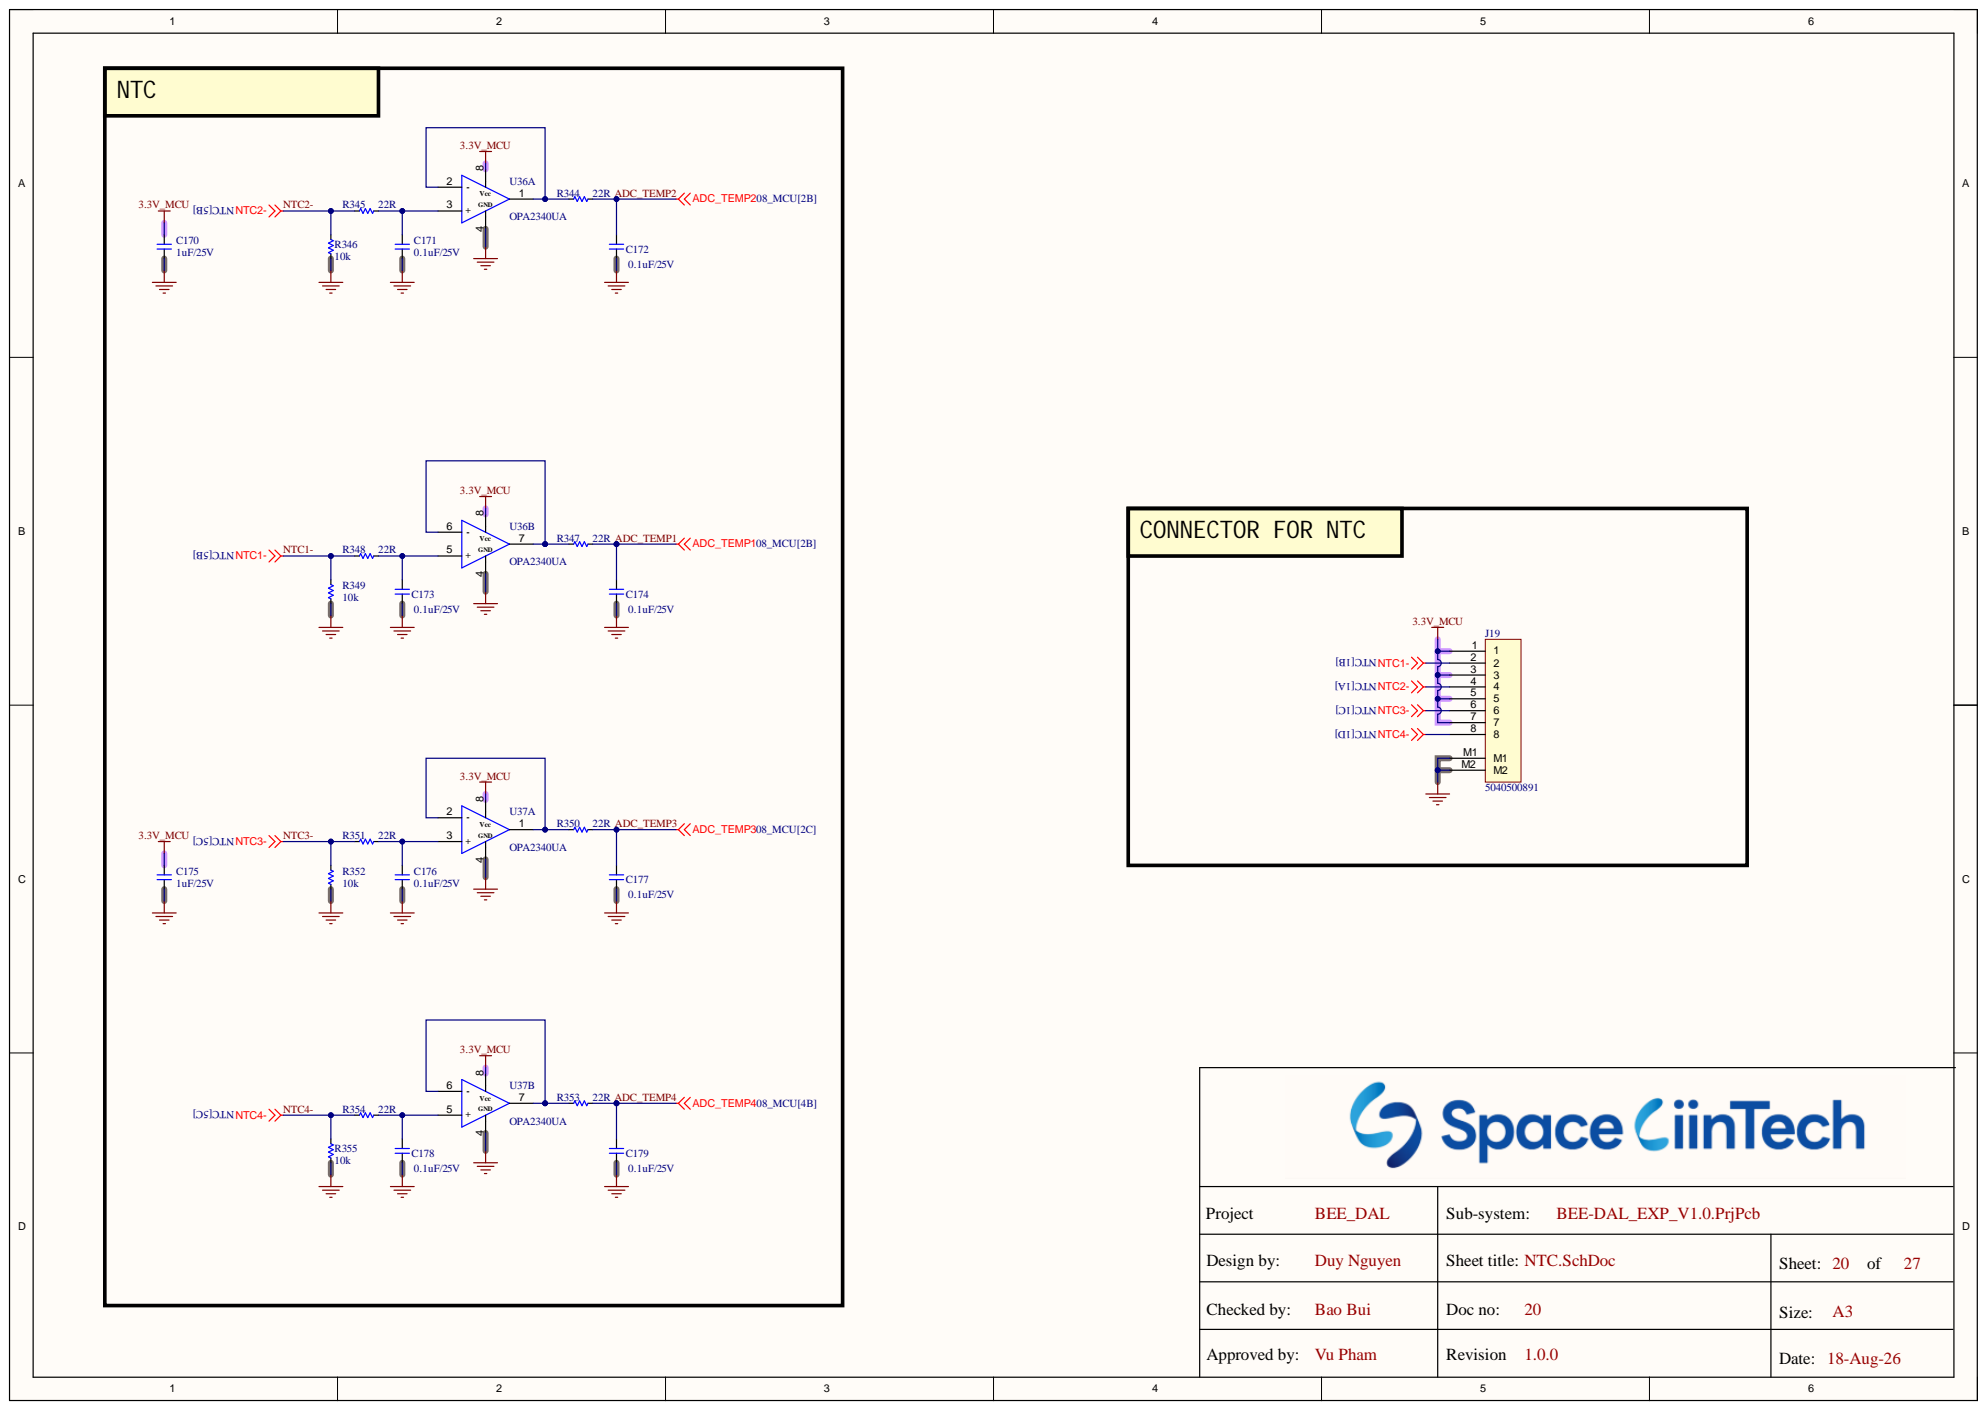
[picture p26: page 20]

Design by: Project BEE_DAL | Sub-system: BEE-DAL_EXP_V1.0.P rjP c b

Che cked by: B ao Bui | Doc no: Revision Sheet title 20 | Siz e : A3

Duy Nguye n | : NTC.S chDoc | She et: 20 of 27

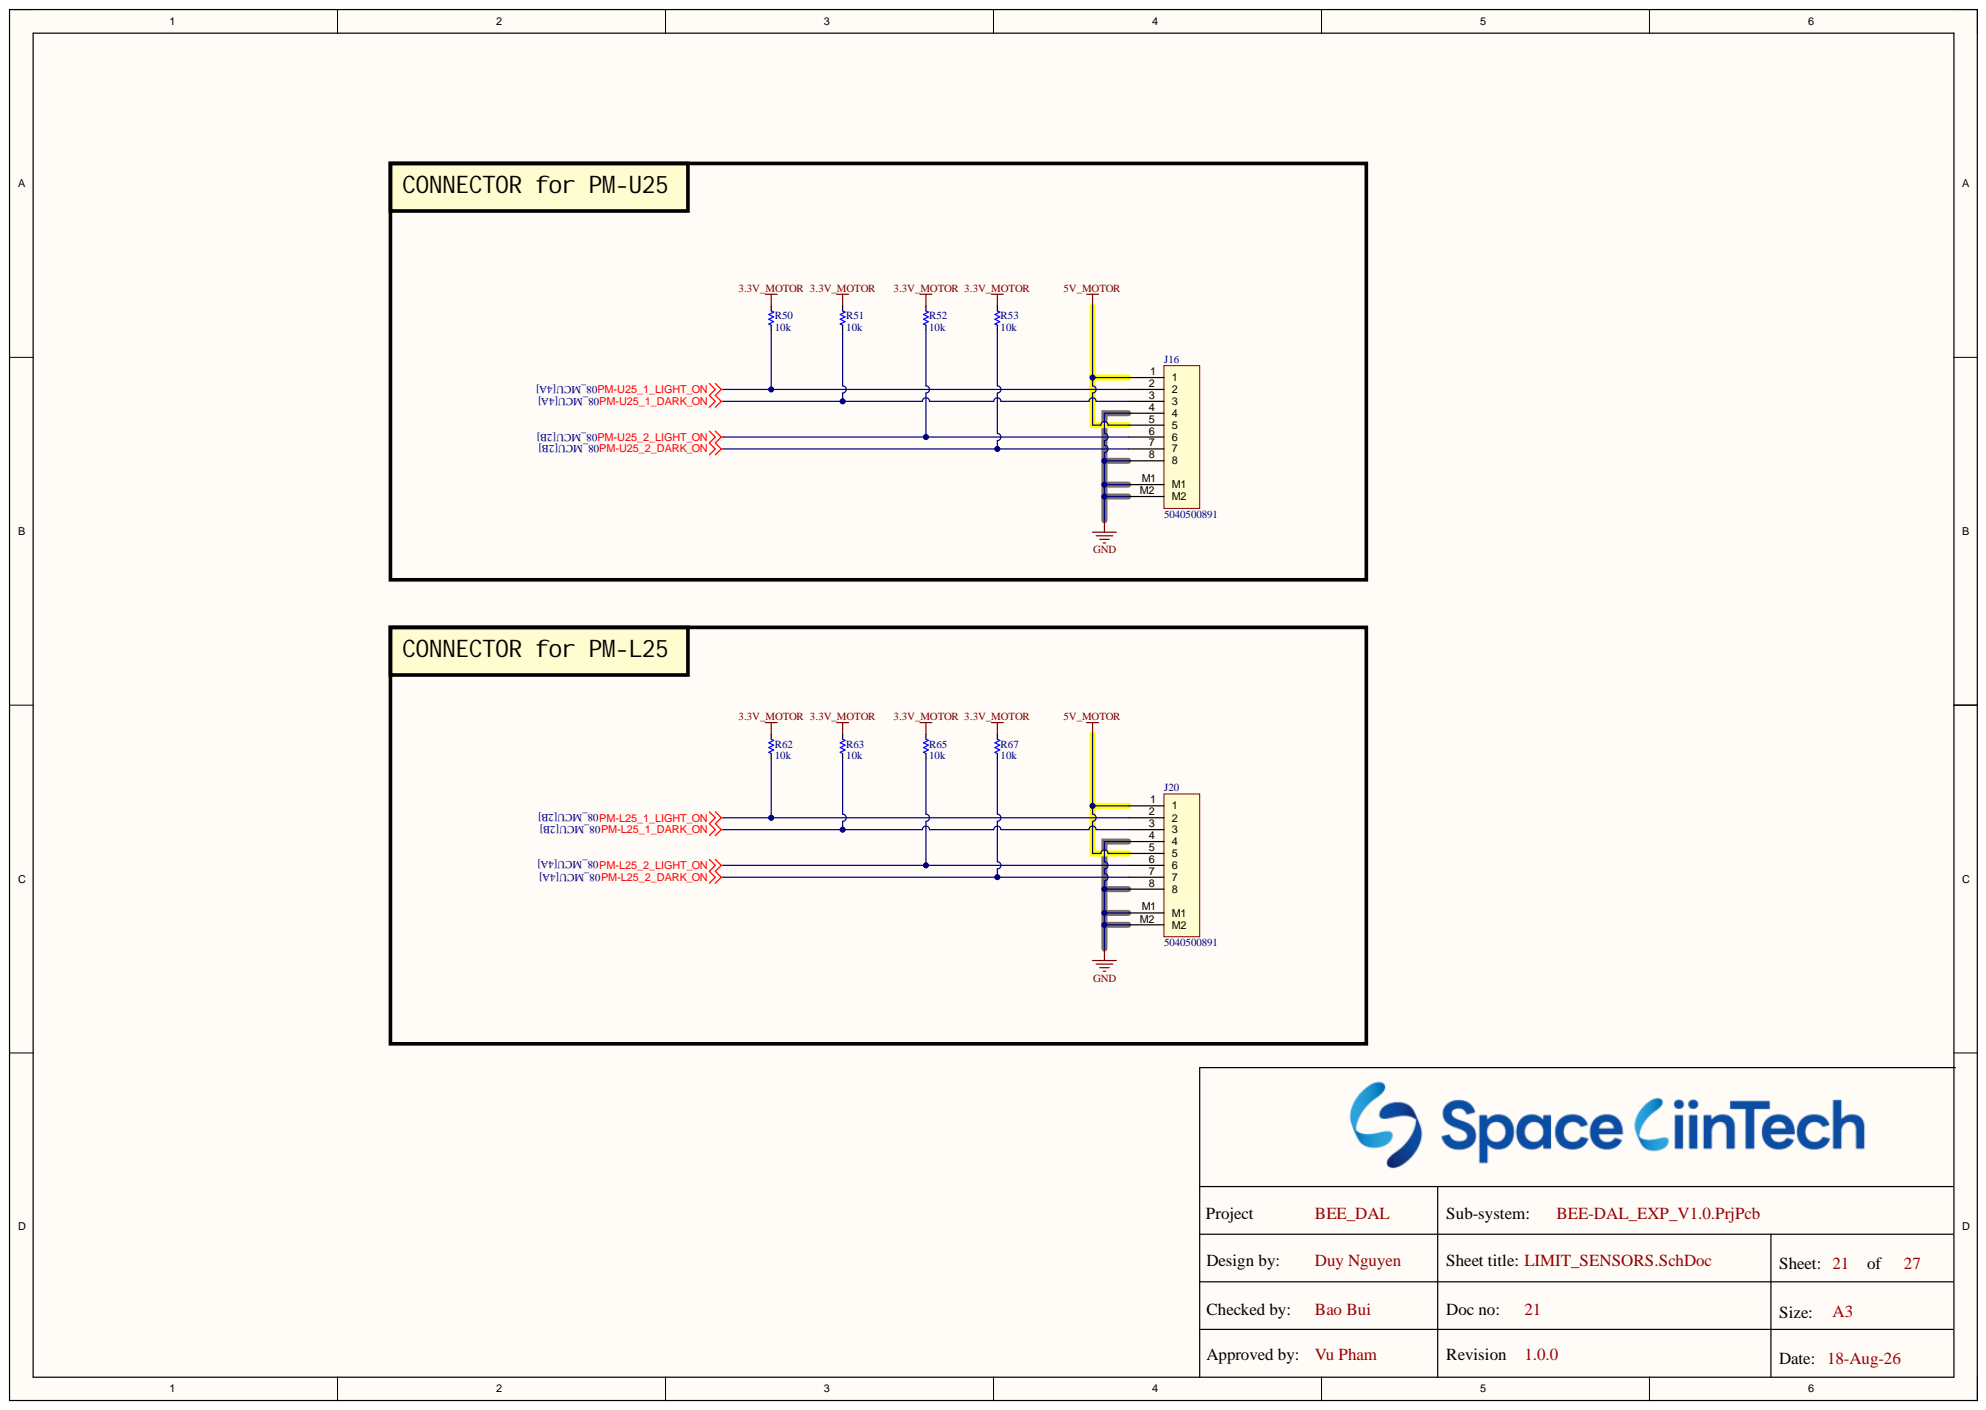
[picture p27: page 21]

4 4
5 5

M1 M1
M2 M2

Project BEE_DAL | Sub-system: BEE-DAL_EXP_V1.0.PrjPcb

Design by: Duy Nguyen | Sheet title: LIMIT_SENSORS.SchDoc | Sheet: 21 of 27

Checked by: Bao Bui | Doc no: 21 | Size: A3

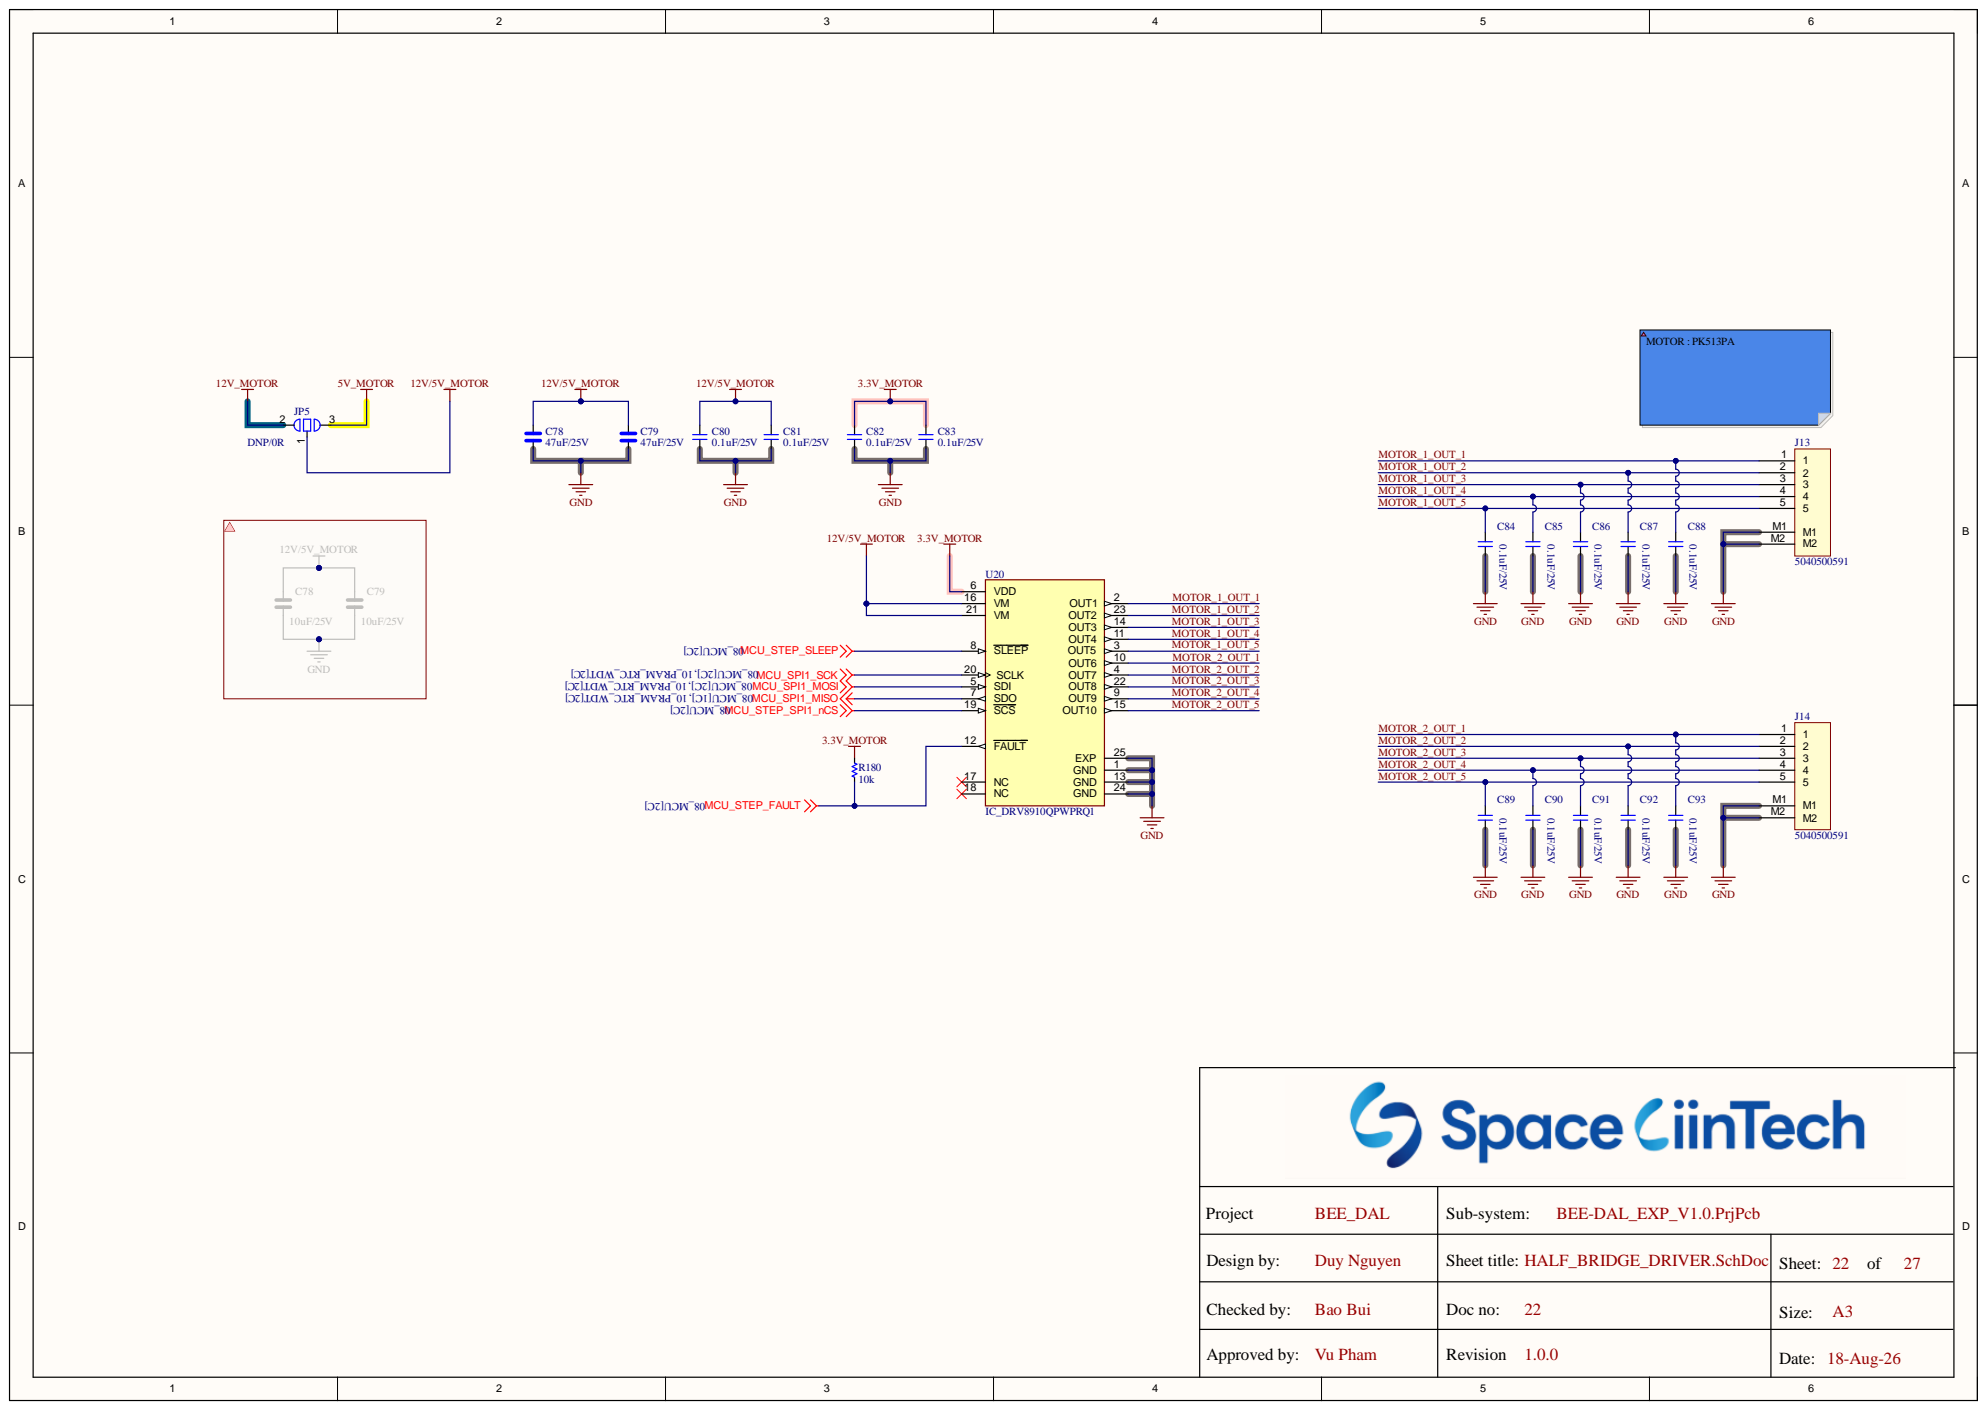
[picture p28: page 22]

Design by: Project BEE_DAL | Sub-system: BEE-DAL_EXP_V1.0.P rjP c b

Che cked by: B ao Bui | Doc no: Revision Sheet title 22 | Siz e : A3

Duy Nguye n | : HALF_B R IDGE_DR IVER.S chDoc | She et: 22 of 27

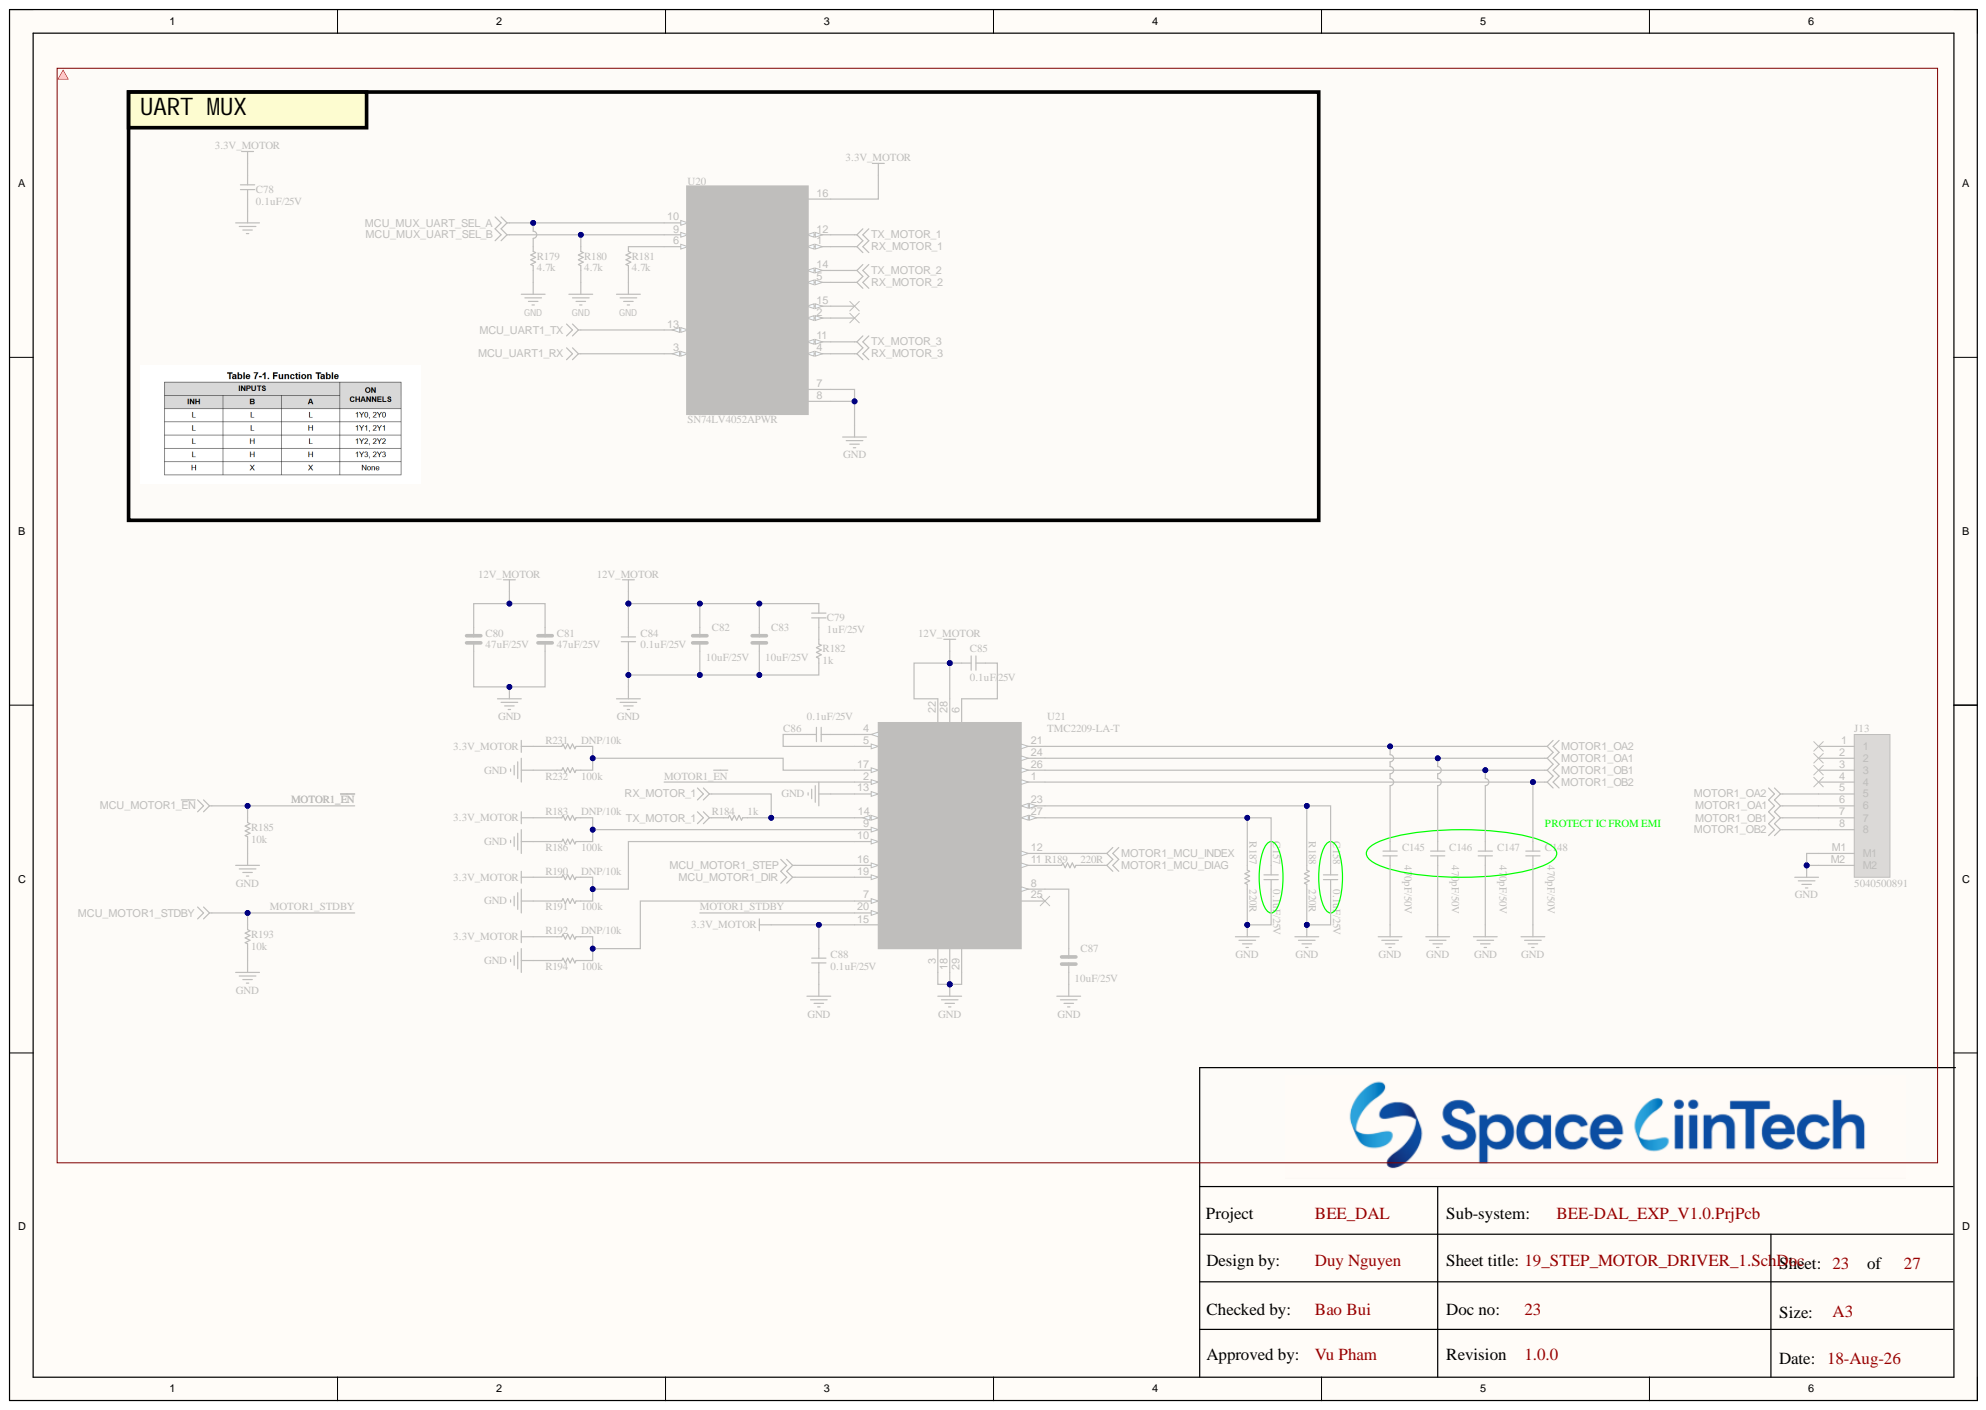
[picture p29: page 23]

PROTECT IC FROM EMI

MOTOR1_STDBY

VCC_IO 15

Project BEE_DAL | Sub-system: BEE-DAL_EXP_V1.0.PrjPcb

Design by: Duy Nguyen | Sheet title: 19_STEP_MOTOR_DRIVER_1.SchDoc | Sheet: 23 of 27

Checked by: Bao Bui | Doc no: 23 | Size: A3

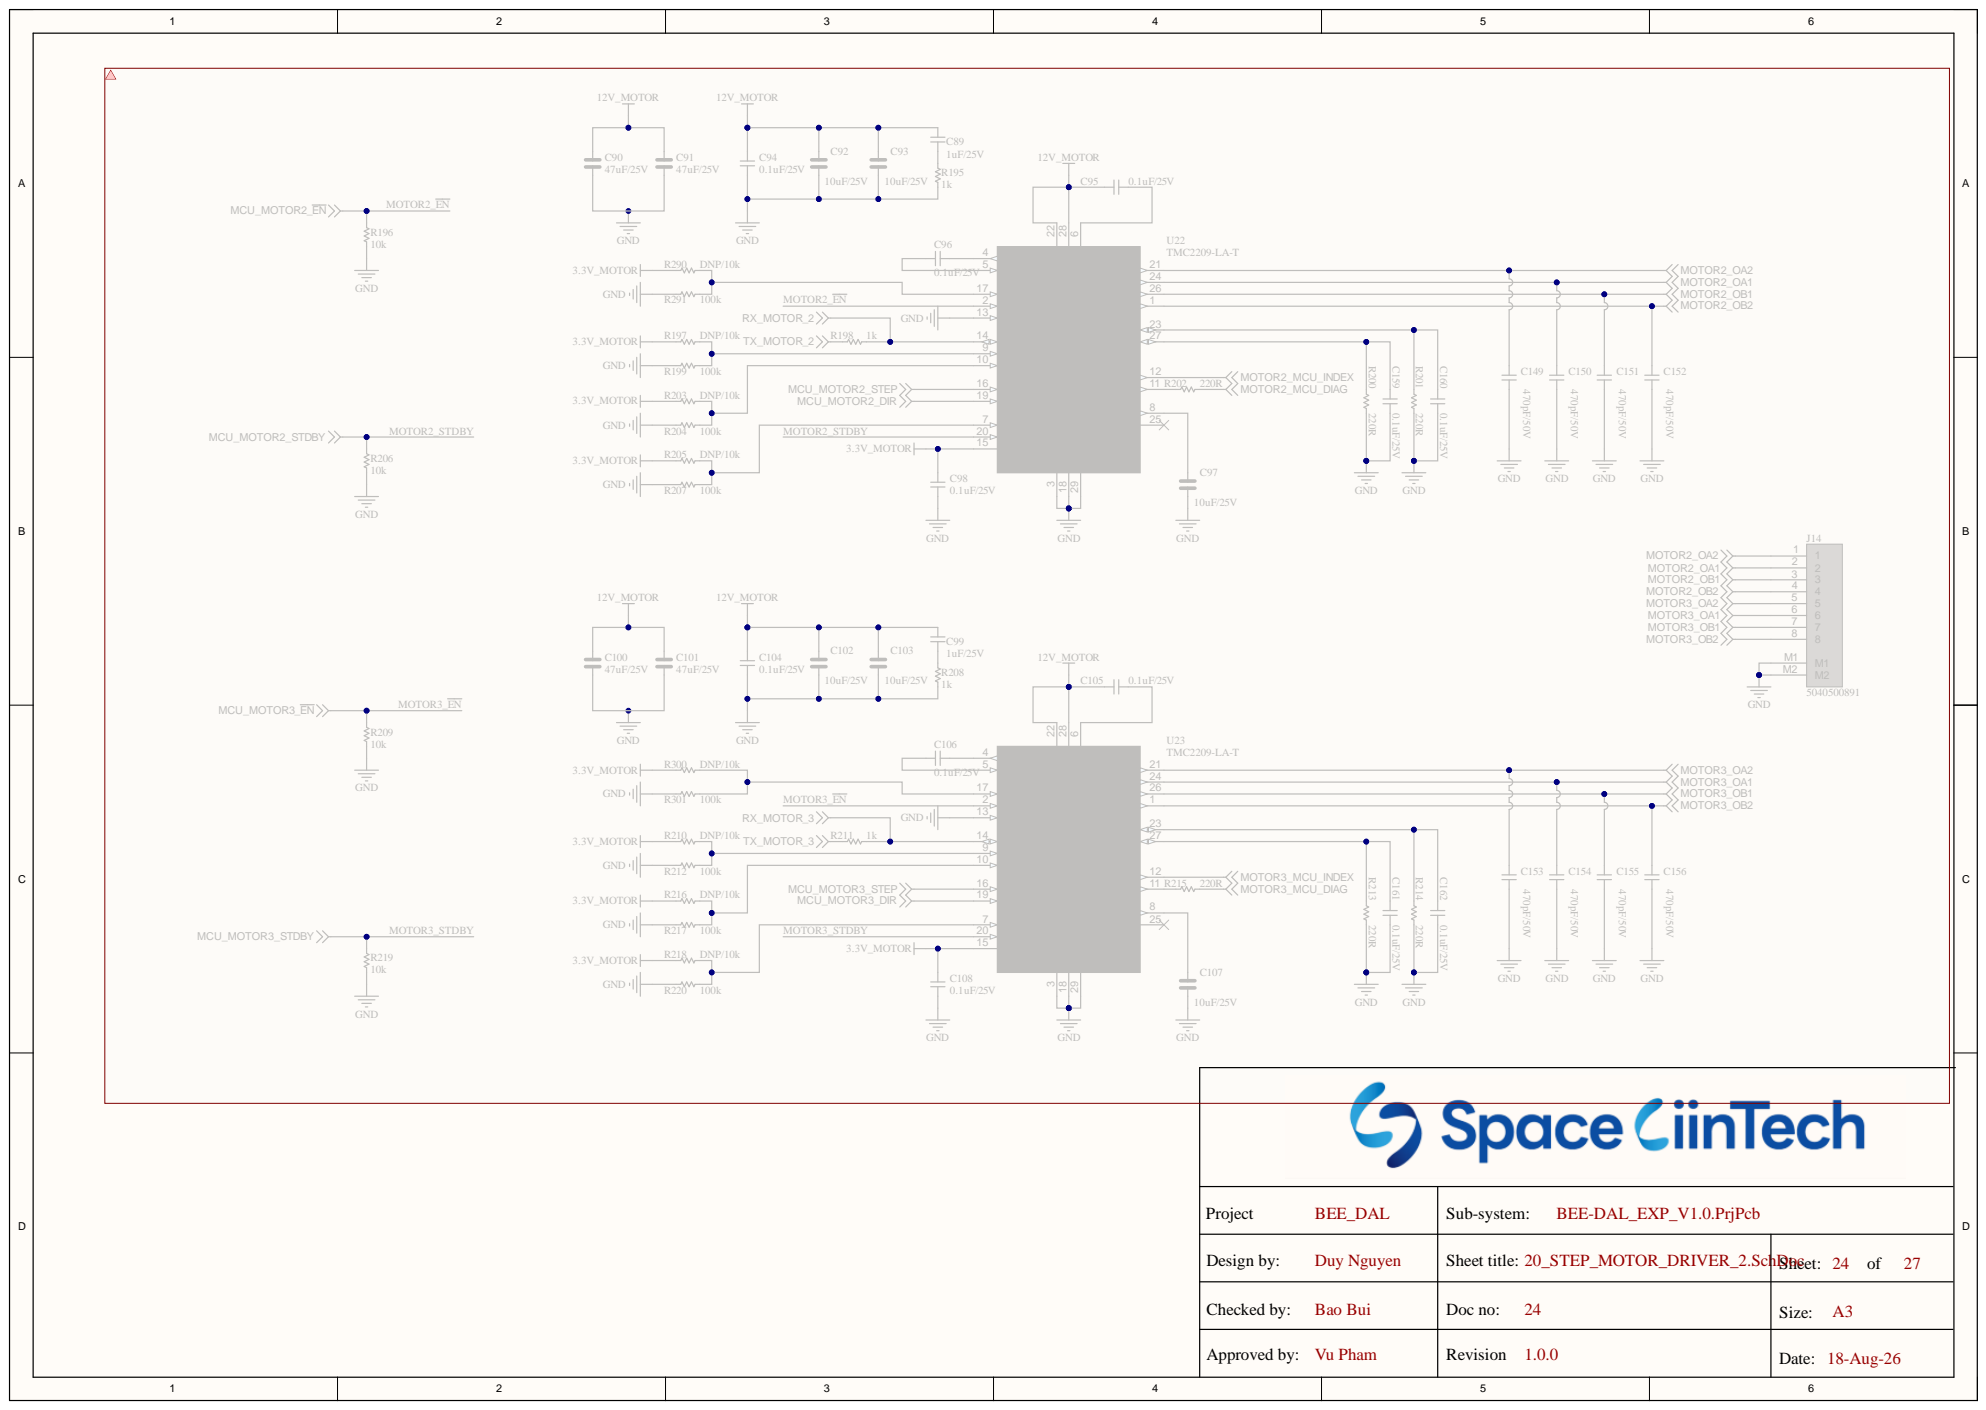
[picture p30: page 24]

R211 1k | PD_UART 14

MS1_AD0 9 | MOTOR3_MCU_INDEX R215 220R MOTOR3_MCU_DIAG
MS2_AD1 10

MCU_MOTOR3_STEP MCU_MOTOR3_DIR | STEP 16

Project BEE_DAL | Sub-system: BEE-DAL_EXP_V1.0.PrjPcb

Design by: Duy Nguyen | Sheet title: 20_STEP_MOTOR_DRIVER_2.SchDoc | Sheet: 24 of 27

Checked by: Bao Bui | Doc no: 24 | Size: A3

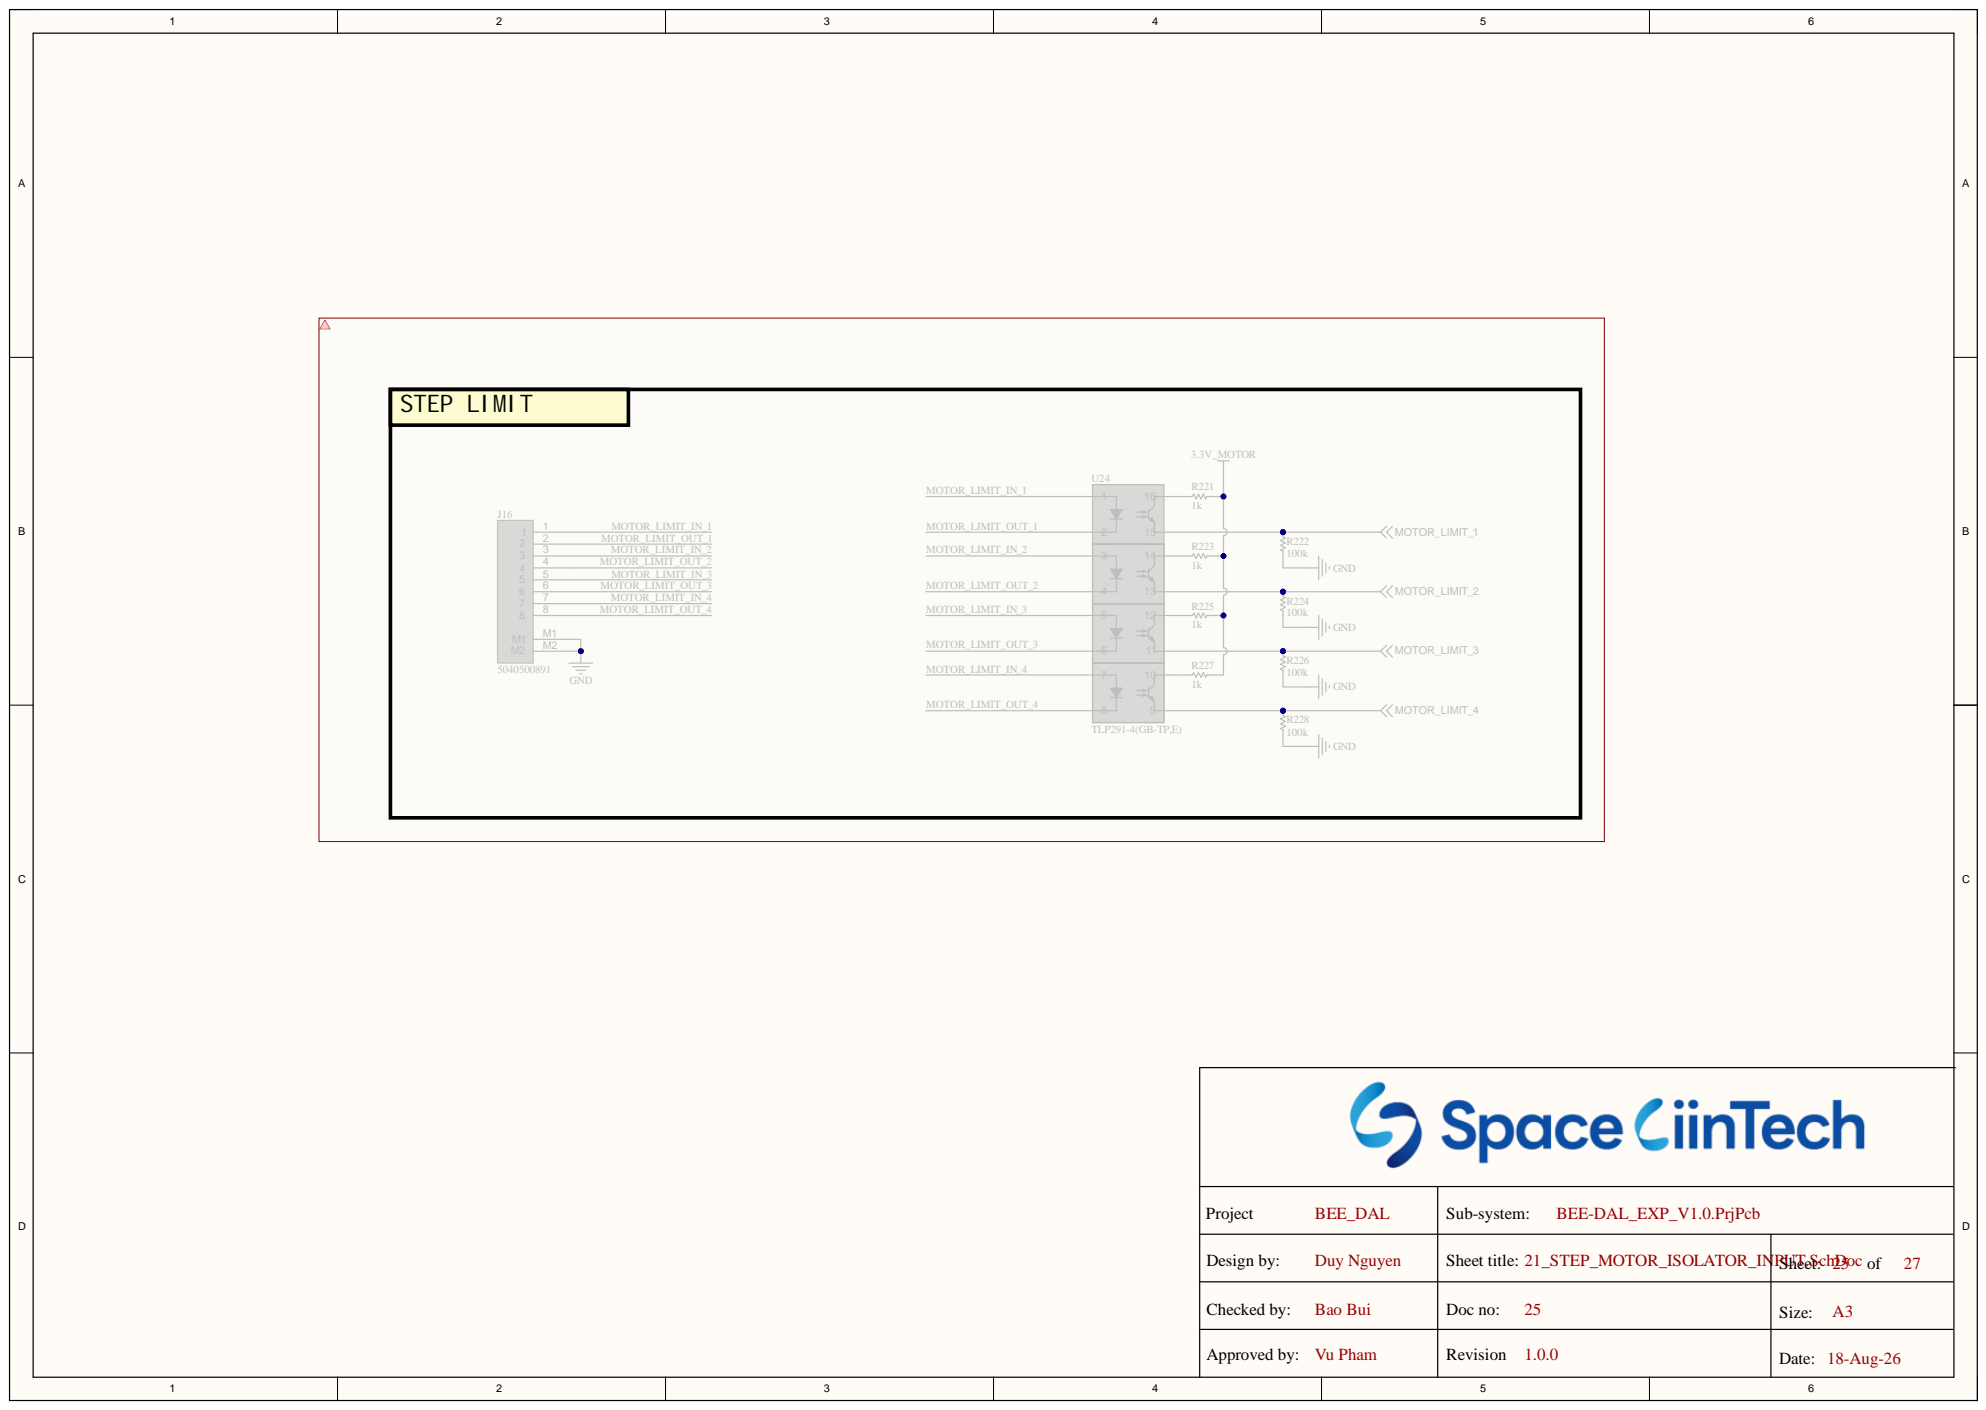
[picture p31: page 25]

Project BEE_DAL | Sub-system: BEE-DAL_EXP_V1.0.PrjPcb

Design by: Duy Nguyen | Sheet title: 21_STEP_MOTOR_ISOLATOR_INPUT.SchDoc | Sheet: 25 of 27

Checked by: Bao Bui | Doc no: 25 | Size: A3

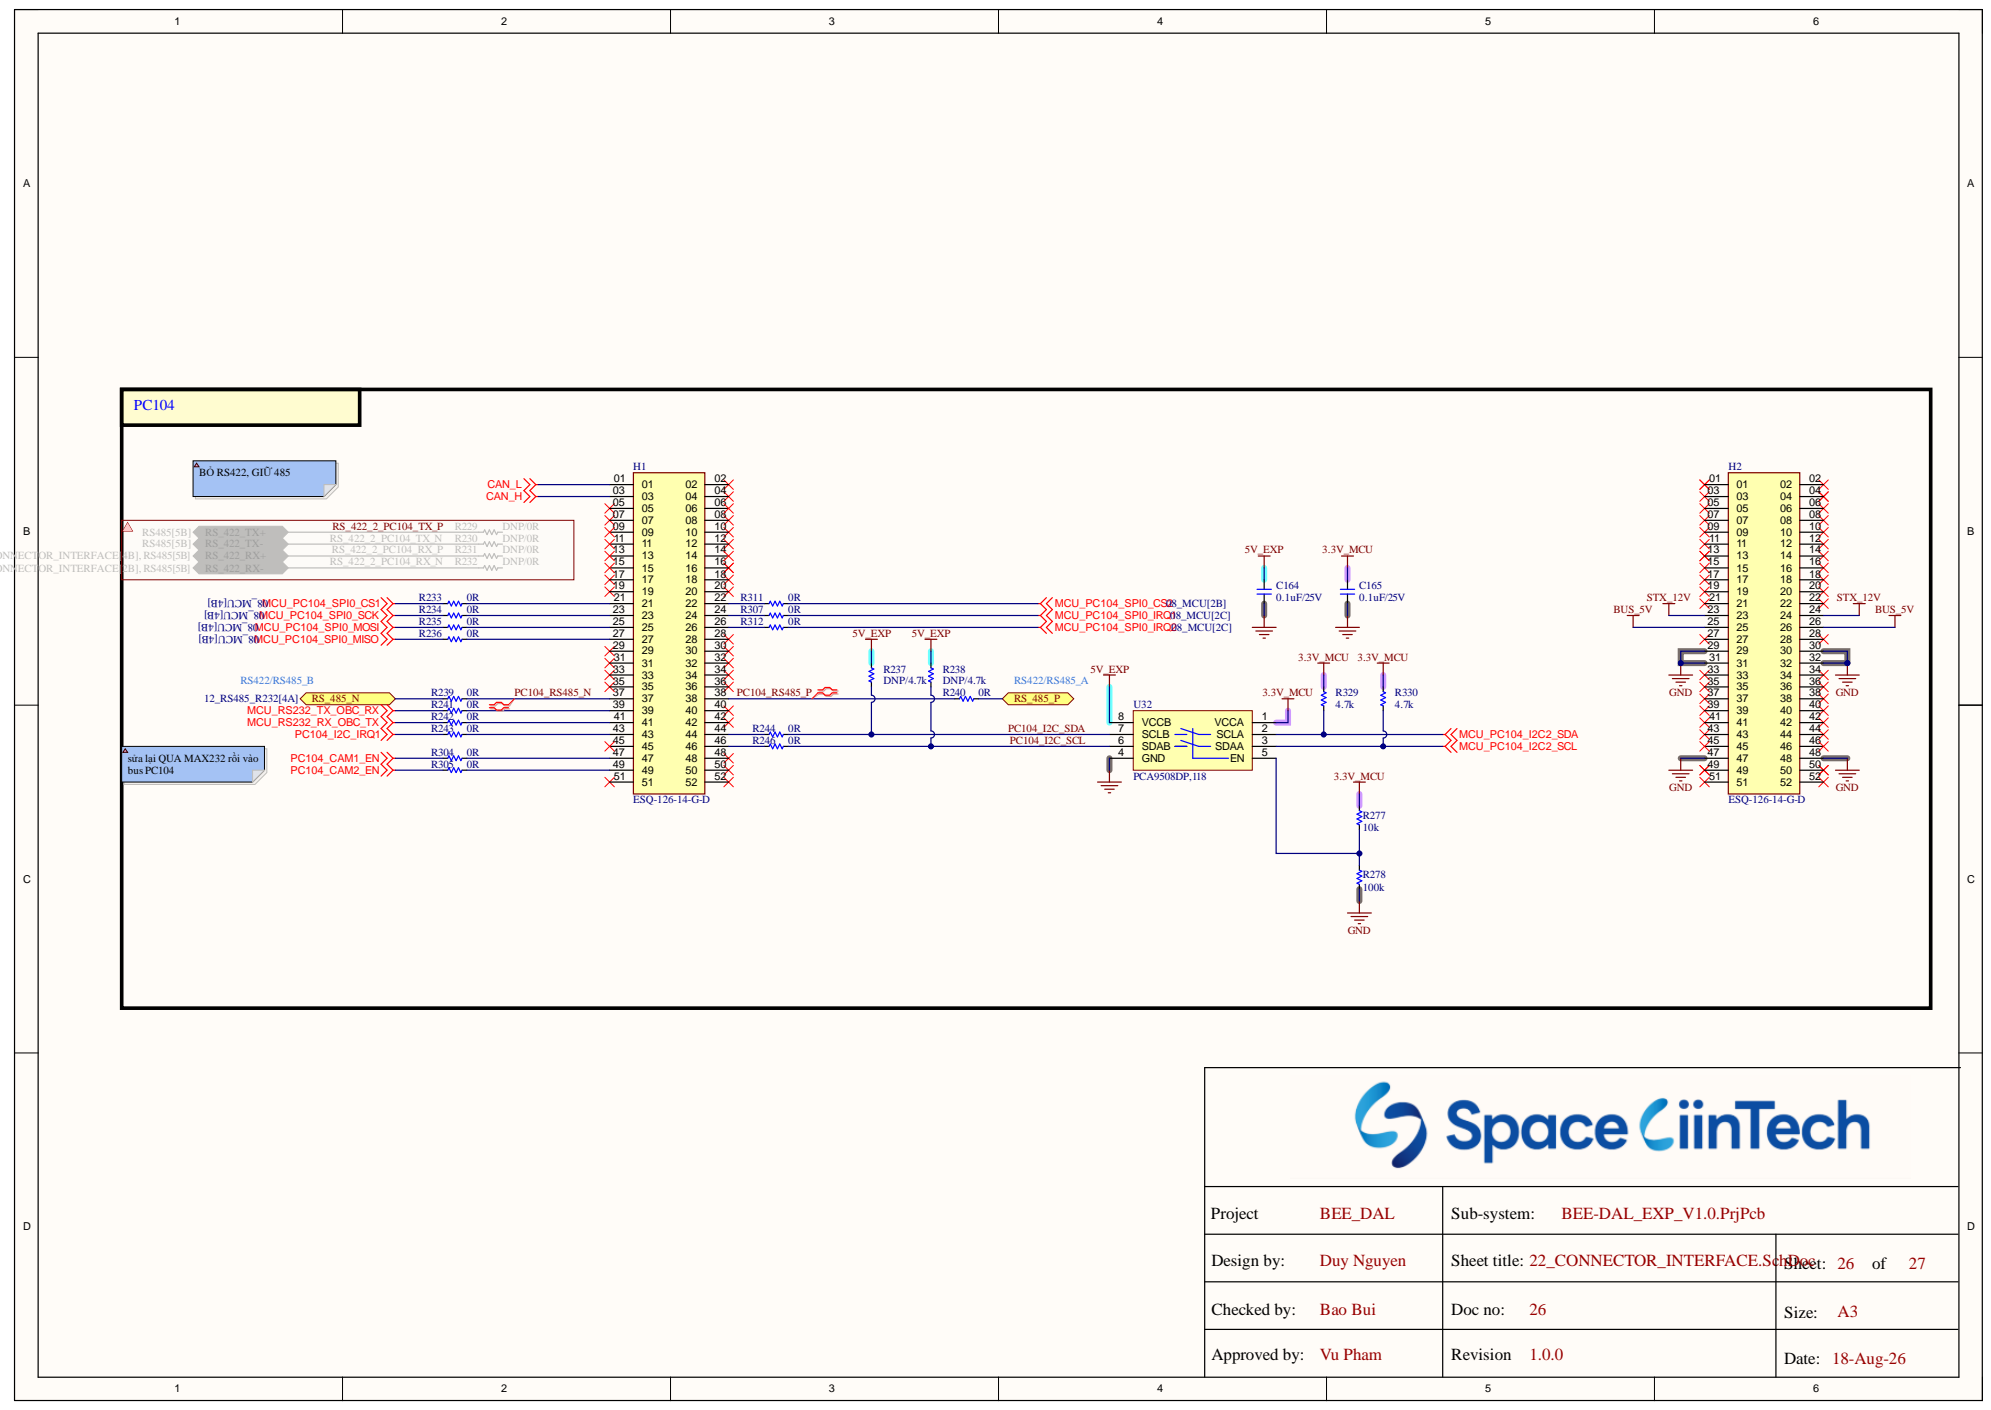
[picture p32: page 26]

Design by: Project BEE_DAL | Sub-system: BEE-DAL_EXP_V1.0.P rjP c b

Che cked by: B ao Bui | Doc no: Revision Sheet title 26 | Siz e : A3

Duy Nguye n | : 22_CONNEC TOR_INTER FACE.S | chDoc She et: 26 of 27

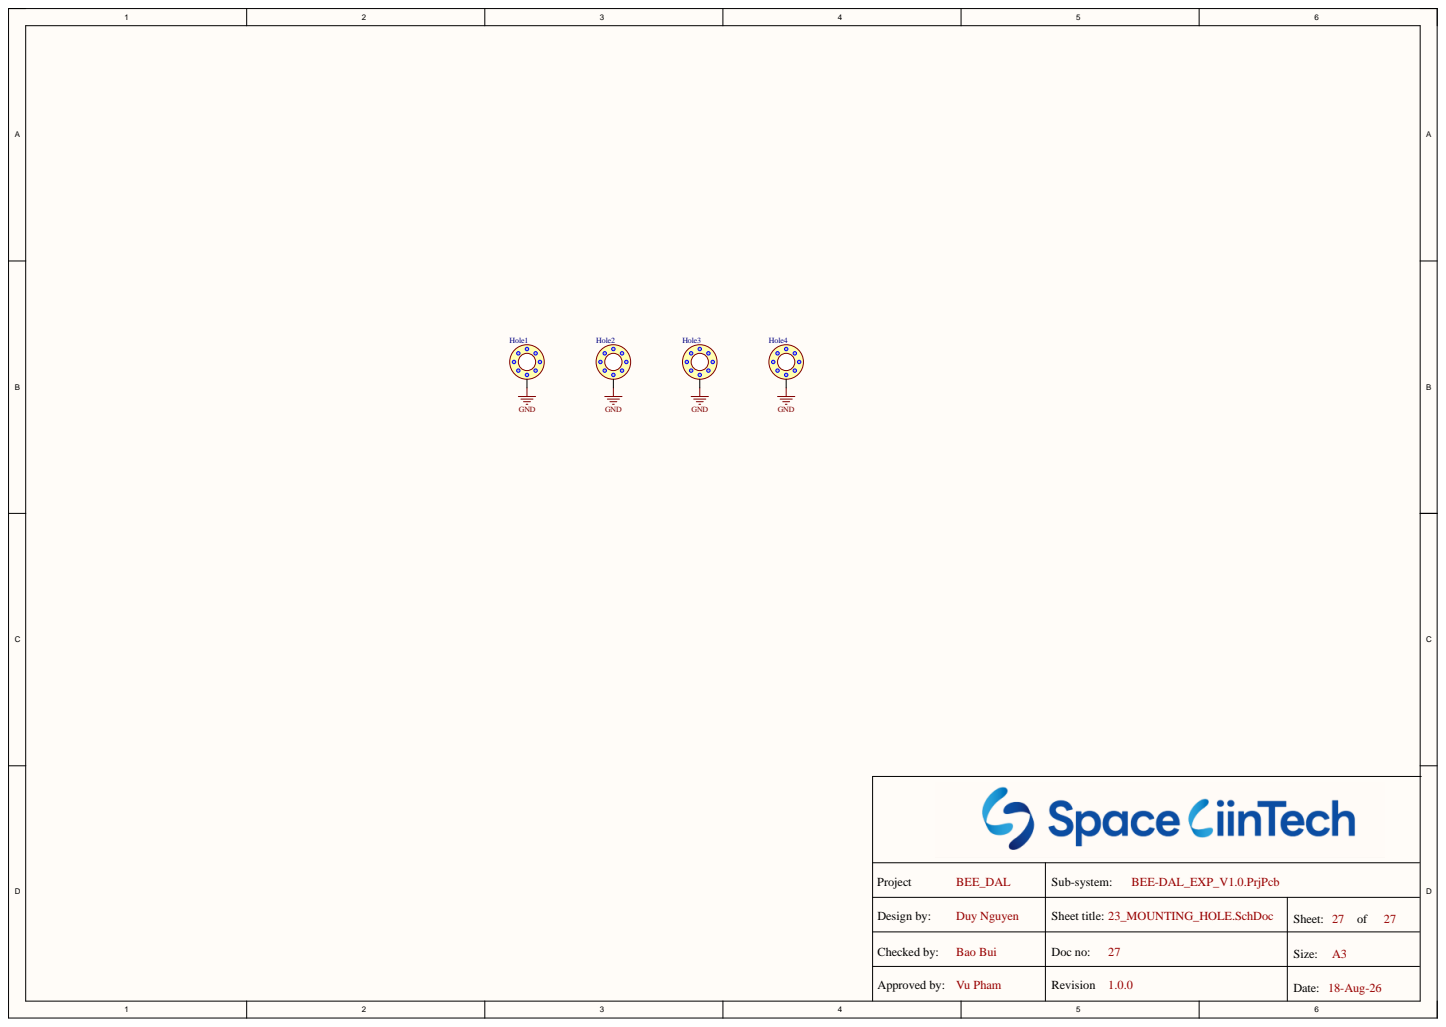
[picture p33: page 27]

Project BEE_DAL | Sub-system: BEE-DAL_EXP_V1.0.PrjPcb

Design by: Duy Nguyen | Sheet title: 23_MOUNTING_HOLE.SchDoc | Sheet: 27 of 27

Checked by: Bao Bui | Doc no: 27 | Size: A3

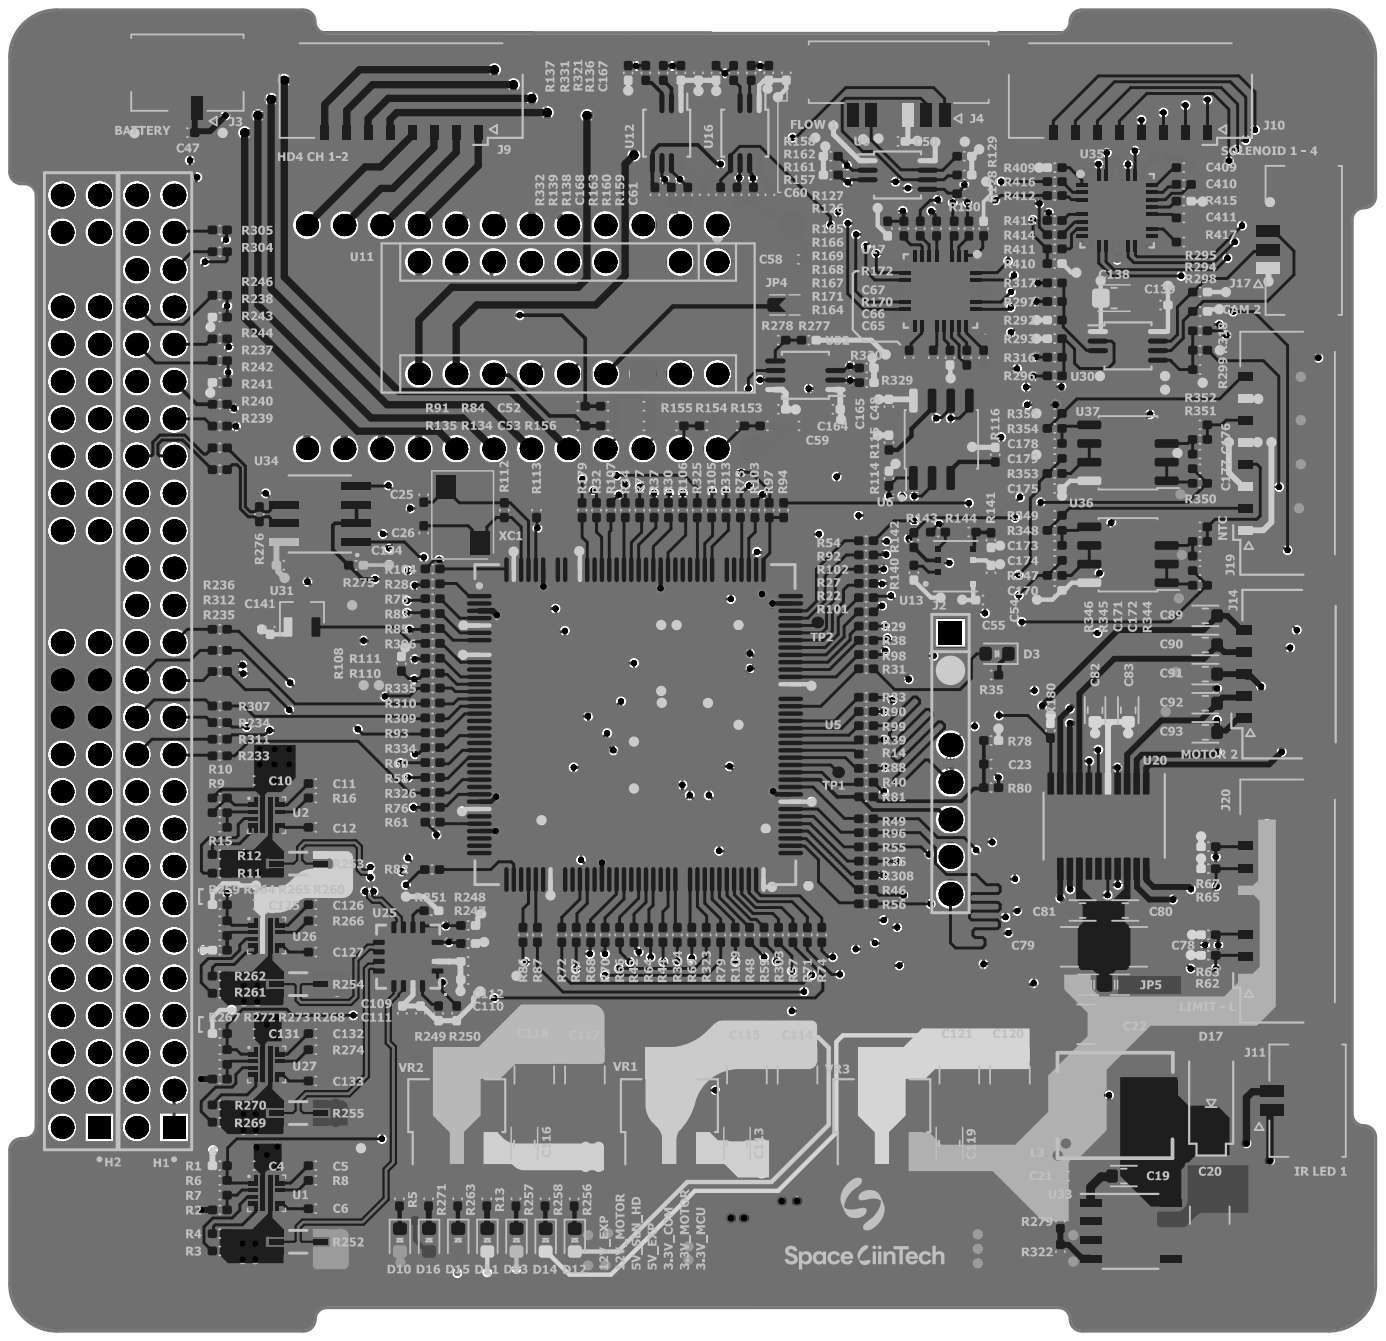
[picture p34: page 28]
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
