baobuibk/SpaceLiin_BEE-DAL_EXP_V1.0_HW/05_SMT/BEE-DAL_EXP_V1.0_DRAWING_PDF.pdf

A

B

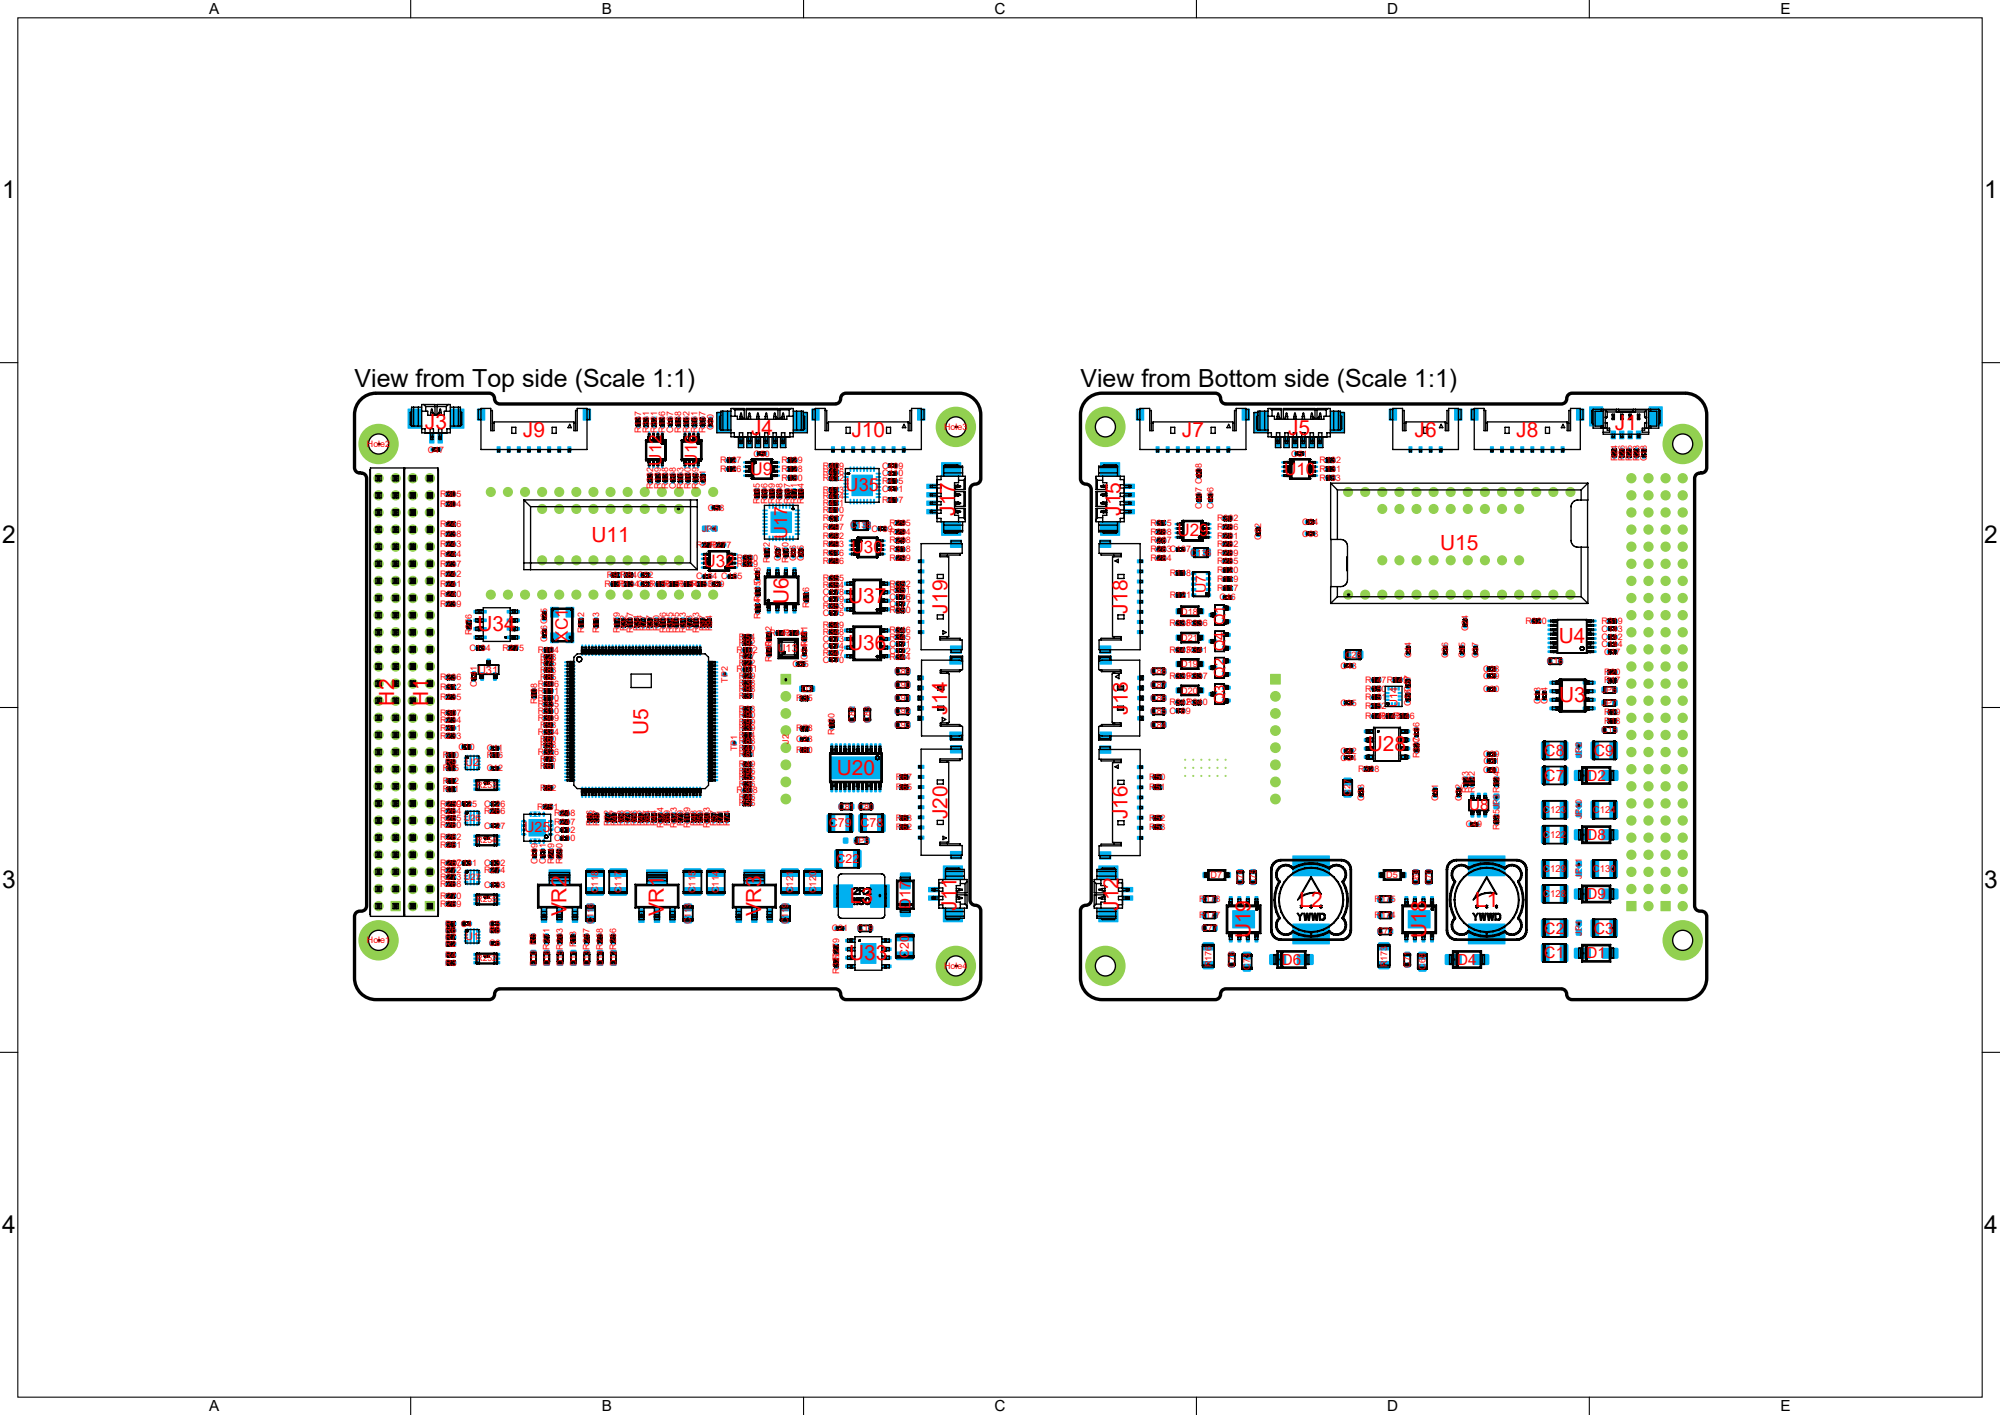
[picture p35: page 1]

View from Top side (Scale 1:1)

View from Bottom side (Scale 1:1)
