baobuibk/SpaceLiin_BEE-DAL_EXP_V1.0_HW/(list of files, drawings)

Other design files:
0_LIB/BEE-DAL_EXP_pcb.PcbLib
0_LIB/BEE-DAL_EXP_sche.SCHLIB
01_DESIGN/01_INDEX.SchDoc
01_DESIGN/02_POWER_TREE.SchDoc
01_DESIGN/03_BLOCK_DIAGRAM.SchDoc
01_DESIGN/04_POWER.SchDoc
01_DESIGN/05_POWER_EFUSE.SchDoc
01_DESIGN/06_POWER_MEASUREMENT.SchDoc
01_DESIGN/07_FUNCTION_EFUSE.SchDoc
01_DESIGN/08_MCU.SchDoc
01_DESIGN/09_CAN.SchDoc
01_DESIGN/10_PRAM_RTC_WDT.SchDoc
01_DESIGN/11_CONSOLE.SchDoc
01_DESIGN/12_RS485_R232.SchDoc
01_DESIGN/13_FLOW_Sensor.SchDoc
01_DESIGN/14_I2C_Sensor_OnBoard.SchDoc
01_DESIGN/15_HD_PUMP.SchDoc
01_DESIGN/16_SOLENOID_HB_1.SchDoc
01_DESIGN/17_CAM_CONNECTOR.SchDoc
01_DESIGN/18_IR_LED.SchDoc
01_DESIGN/19_STEP_MOTOR_DRIVER_1.SchDoc
01_DESIGN/20_STEP_MOTOR_DRIVER_2.SchDoc
01_DESIGN/21_STEP_MOTOR_ISOLATOR_INPUT.SchDoc
01_DESIGN/22_CONNECTOR_INTERFACE.SchDoc
01_DESIGN/23_MOUNTING_HOLE.SchDoc
01_DESIGN/BEE-DAL_EXP_V1.0.PcbDoc
01_DESIGN/BEE-DAL_EXP_V1.0.PrjPcb
01_DESIGN/HALF_BRIDGE_DRIVER.SchDoc
01_DESIGN/HEATER.SchDoc
01_DESIGN/LIMIT_SENSORS.SchDoc
01_DESIGN/NTC.SchDoc
