baobuibk/SpaceLiin_BEE-DAL_EXP_V1.0_HW/(commit log)

2026-06-27 initial prj
    [06_POWER_3.SchDoc, 07_CAN.SchDoc, 08_MCU.SchDoc, 09_CONSOLE.SchDoc, 10_PRAM_RTC_WDT.SchDoc, 13_FLOW_Sensor.SchDoc, 14_I2C_Sensor_OnBoard.SchDoc, 15_HD_PUMP.SchDoc]
2026-07-01 design schematic: UART is enough, choosing signal IO for step driver
    [06_POWER_3.SchDoc, 08_MCU.SchDoc, 10_PRAM_RTC_WDT.SchDoc, 15_HD_PUMP.SchDoc, 16_SOLENOID_HB_1.SchDoc, BEE-DAL_EXP.PrjPcb, BEE-DAL_EXP_sche.SCHLIB, CONNECTOR_INTERFACE.SchDoc]
2026-07-02 provisionally completed, wait fot review
    [07_CAN.SchDoc, 08_MCU.SchDoc, 09_CONSOLE.SchDoc, 10_PRAM_RTC_WDT.SchDoc, 13_FLOW_Sensor.SchDoc, 14_I2C_Sensor_OnBoard.SchDoc, 15_HD_PUMP.SchDoc, 16_SOLENOID_HB_1.SchDoc]
2026-07-06 remove rs422
    [07_CAN.SchDoc, 08_MCU.SchDoc, 10_PRAM_RTC_WDT.SchDoc, 13_FLOW_Sensor.SchDoc, 14_I2C_Sensor_OnBoard.SchDoc, 15_HD_PUMP.SchDoc, 16_SOLENOID_HB_1.SchDoc, BEE-DAL_EXP.PrjPcb]
2026-07-09 waiting check schematic round2, init pcb
    [07_CAN.SchDoc, 08_MCU.SchDoc, 09_CONSOLE.SchDoc, 10_PRAM_RTC_WDT.SchDoc, 13_FLOW_Sensor.SchDoc, 14_I2C_Sensor_OnBoard.SchDoc, 15_HD_PUMP.SchDoc, 16_SOLENOID_HB_1.SchDoc]
2026-07-09 add file index, rename filename
    [01_INDEX.SchDoc, 02_POWER_TREE.SchDoc, 03_BLOCK_DIAGRAM.SchDoc, 04_POWER.SchDoc, 05_POWER_EFUSE.SchDoc, 06_POWER_MEASUREMENT.SchDoc, 07_CAN.SchDoc, 07_FUNCTION_EFUSE.SchDoc]
2026-07-10 add BOM, sche pdf
    [04_POWER.SchDoc, 05_POWER_EFUSE.SchDoc, 06_POWER_MEASUREMENT.SchDoc, 07_FUNCTION_EFUSE.SchDoc, 10_PRAM_RTC_WDT.SchDoc, 12_RS485_R232.SchDoc, 14_I2C_Sensor_OnBoard.SchDoc, 16_SOLENOID_HB_1.SchDoc]
2026-07-10 re-push sche pdf
    [04_POWER.SchDoc, 05_POWER_EFUSE.SchDoc, 06_POWER_MEASUREMENT.SchDoc, 07_FUNCTION_EFUSE.SchDoc, 08_MCU.SchDoc, 09_CAN.SchDoc, 10_PRAM_RTC_WDT.SchDoc, 11_CONSOLE.SchDoc]
2026-07-12 add file pin_configuration.csv, add cap in pin OA/OB of step motor, re-export sche pdf
    [04_POWER.SchDoc, 08_MCU.SchDoc, 19_STEP_MOTOR_DRIVER_1.SchDoc, 20_STEP_MOTOR_DRIVER_2.SchDoc, BEE-DAL_EXP_V1.0.0.xlsx, BEE-DAL_EXP_V1.0.PrjPcb, BEE-DAL_EXP_V1.0.xlsx, pin_configurations.xlsx]
2026-07-13 placing IR led
    [04_POWER.SchDoc, 05_POWER_EFUSE.SchDoc, 06_POWER_MEASUREMENT.SchDoc, 07_FUNCTION_EFUSE.SchDoc, 08_MCU.SchDoc, 09_CAN.SchDoc, 10_PRAM_RTC_WDT.SchDoc, 11_CONSOLE.SchDoc]
2026-07-16 change 5V motor to 12V
    [04_POWER.SchDoc, 06_POWER_MEASUREMENT.SchDoc, 07_FUNCTION_EFUSE.SchDoc, 08_MCU.SchDoc, 19_STEP_MOTOR_DRIVER_1.SchDoc, 20_STEP_MOTOR_DRIVER_2.SchDoc, 22_CONNECTOR_INTERFACE.SchDoc]
2026-07-17 update 3d, postion connector
    [09_CAN.SchDoc, BEE-DAL_EXP_V1.0.PrjPcb]
2026-07-18 layouting, change to rs485
    [08_MCU.SchDoc, 12_RS485_R232.SchDoc, BEE-DAL_EXP_V1.0.PrjPcb, BEE-DAL_EXP_sche.SCHLIB]
2026-07-21 layouting, remaining 10 nets
    [08_MCU.SchDoc, 12_RS485_R232.SchDoc, 22_CONNECTOR_INTERFACE.SchDoc, BEE-DAL_EXP_V1.0.PrjPcb]
2026-07-22 layouting, GND
    [07_FUNCTION_EFUSE.SchDoc]
2026-07-22 done route first
    [BEE-DAL_EXP_V1.0.PrjPcb]
2026-07-23 change BNO to i2c interface, update BOM
    [10_PRAM_RTC_WDT.SchDoc, 14_I2C_Sensor_OnBoard.SchDoc, 16_SOLENOID_HB_1.SchDoc, 19_STEP_MOTOR_DRIVER_1.SchDoc, BEE-DAL_EXP_V1.0.PrjPcb, BEE-DAL_EXP_V1.0.xlsx]
2026-07-24 re-layyout bump, fix position pin solenoid
    [08_MCU.SchDoc, 10_PRAM_RTC_WDT.SchDoc, 15_HD_PUMP.SchDoc, 16_SOLENOID_HB_1.SchDoc, 22_CONNECTOR_INTERFACE.SchDoc]
2026-07-26 re-place rs232, wd
    [BEE-DAL_EXP.PcbDoc]
2026-07-27 add driverpump 1 channel, delete 2 flow sensor
    [04_POWER.SchDoc, 08_MCU.SchDoc, 13_FLOW_Sensor.SchDoc, 15_HD_PUMP.SchDoc, 22_CONNECTOR_INTERFACE.SchDoc, BEE-DAL_EXP.PcbDoc]
2026-07-27 placing pump
    [BEE-DAL_EXP.PcbDoc]
2026-07-29 routing, 2 nets remaining
    [12_RS485_R232.SchDoc, 13_FLOW_Sensor.SchDoc, 19_STEP_MOTOR_DRIVER_1.SchDoc, BEE-DAL_EXP.PcbDoc]
2026-07-30 layout done, waiting for check
    [BEE-DAL_EXP.PcbDoc]
2026-08-03 change ic step, add heater, add ntc
    [08_MCU.SchDoc, 12_RS485_R232.SchDoc, 14_I2C_Sensor_OnBoard.SchDoc, 16_SOLENOID_HB_1.SchDoc, 19_STEP_MOTOR_DRIVER_1.SchDoc, 20_STEP_MOTOR_DRIVER_2.SchDoc, 22_CONNECTOR_INTERFACE.SchDoc, BEE-DAL_EXP.PcbDoc]
2026-08-04 add ic half bridge, add limit sensor, placing
    [04_POWER.SchDoc, 08_MCU.SchDoc, 11_CONSOLE.SchDoc, 14_I2C_Sensor_OnBoard.SchDoc, 21_STEP_MOTOR_ISOLATOR_INPUT.SchDoc, BEE-DAL_EXP.PcbDoc, BEE-DAL_EXP_V1.0.PrjPcb, BEE-DAL_EXP_pcb.PcbLib]
2026-08-05 routing, 22 nets remaining
    [08_MCU.SchDoc, BEE-DAL_EXP.PcbDoc, BEE-DAL_EXP_V1.0.PrjPcb, HEATER.SchDoc]
2026-08-06 remaining 1 GND
    [BEE-DAL_EXP.PcbDoc]
2026-08-07 remaining GND of some connectors and fix some clearance of silk to silk and silk to solder mask
    [BEE-DAL_EXP.PcbDoc]
2026-08-08 fix issue pull up bus 5V i2c pc104, fix issue change voltage cap from 10 to 25V at rs232
    [12_RS485_R232.SchDoc, 15_HD_PUMP.SchDoc, 22_CONNECTOR_INTERFACE.SchDoc, BEE-DAL_EXP.PcbDoc, HALF_BRIDGE_DRIVER.SchDoc, LIMIT_SENSORS.SchDoc]
2026-08-10 change ic rs232
    [12_RS485_R232.SchDoc, 14_I2C_Sensor_OnBoard.SchDoc, 15_HD_PUMP.SchDoc, BEE-DAL_EXP.PcbDoc, HALF_BRIDGE_DRIVER.SchDoc, LIMIT_SENSORS.SchDoc]
2026-08-10 export first gerber, smt, fixing BOM
    [BEE-DAL_EXP.PcbDoc, BEE-DAL_EXP_V1.0.PcbDoc, BEE-DAL_EXP_V1.0.xls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]
2026-08-11 export BOM
    [BEE-DAL_EXP_V1.0.PrjPcb, BEE-DAL_EXP_V1.0.xlsx]
2026-08-11 fix file BEE-DAL_EXP_V1.0_STACK_UP in folder 04_GERBER
    [12_RS485_R232.SchDoc, 18_IR_LED.SchDoc, BEE-DAL_EXP_V1.0.PrjPcb, BEE-DAL_EXP_V1.0.xls, BEE-DAL_EXP_V1.0_STACK_UP.xls, NTC.SchDoc]
2026-08-12 fix issuse #6 error pin SPI at ic DRV8910QPWPRQ1
    [BEE-DAL_EXP_V1.0.PcbDoc, HALF_BRIDGE_DRIVER.SchDoc]
2026-08-12 fix and close issue in repo, about issue using cap tant: using cap cer with 47uF/25V, export gerber, smt files, 3d, bom
    [06_POWER_MEASUREMENT.SchDoc, 08_MCU.SchDoc, 09_CAN.SchDoc, 10_PRAM_RTC_WDT.SchDoc, 11_CONSOLE.SchDoc, 12_RS485_R232.SchDoc, 13_FLOW_Sensor.SchDoc, 14_I2C_Sensor_OnBoard.SchDoc]
2026-08-13 routing VDDCORE in L4, increase size polygon of VDDCORE, re-export: gerber, smt, drawing, 3d
    [BEE-DAL_EXP_V1.0.PcbDoc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]
2026-08-13 fix value of component in BOM, re-export: BOM, pick and place, drawing
    [04_POWER.SchDoc, 05_POWER_EFUSE.SchDoc, 07_FUNCTION_EFUSE.SchDoc, 08_MCU.SchDoc, 12_RS485_R232.SchDoc, 16_SOLENOID_HB_1.SchDoc, 17_CAM_CONNECTOR.SchDoc, 18_IR_LED.SchDoc]
2026-08-13 add GND pour TOP BOT, re-export gerber smt file, BOM
    [BEE-DAL_EXP_V1.0.PcbDoc, BEE-DAL_EXP_V1.0.PrjPcb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]
2026-08-14 increasing the distance between vias causes the GND layer to be split, re-export gerber, smt
    [BEE-DAL_EXP_V1.0.PcbDoc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]
2026-08-15 fix stackup board, increase rules distance of width
    [12_RS485_R232.SchDoc, 22_CONNECTOR_INTERFACE.SchDoc, BEE-DAL_EXP_V1.0.PcbDoc, BEE-DAL_EXP_V1.0.PrjPcb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]
2026-08-18 add jumper add can bus transceiver for bypass option of termination resistor; change cap add vref to 4.7nF/50V; re-export gerber, smt, bom, 3d
    [09_CAN.SchDoc, BEE-DAL_EXP_V1.0.PcbDoc, BEE-DAL_EXP_V1.0.PrjPcb, BEE-DAL_EXP_V1.0.xlsx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]
